SAndras01/Masters-thesis/FELV-cat.jpg

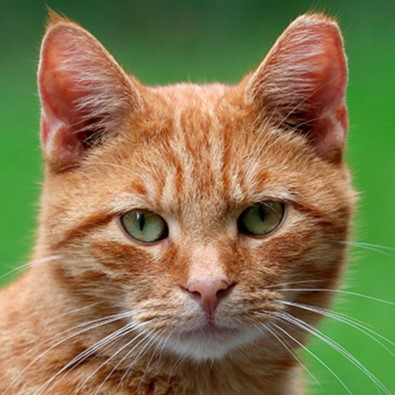
FELV-cat.jpg
