SAndras01/Masters-thesis/images/20251127_200717.jpg

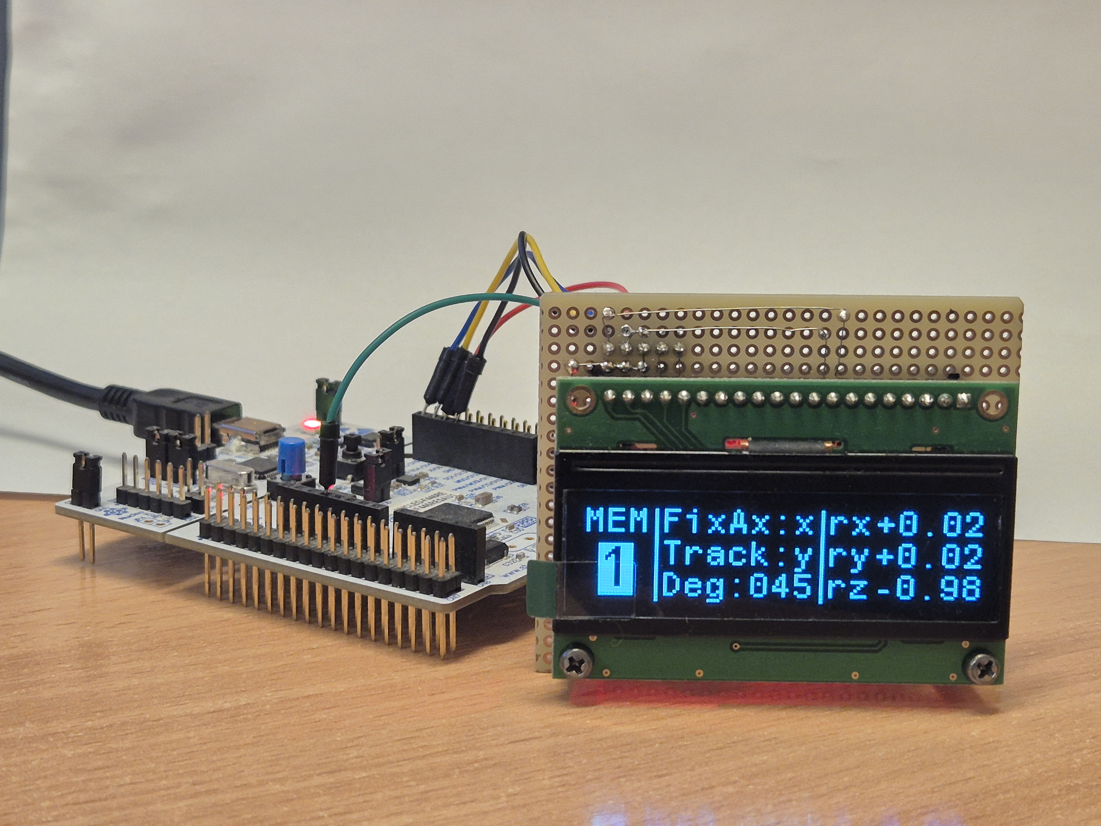
images/20251127_200717.jpg
