SAndras01/Masters-thesis/README.md

# Masters-thesis
Two-axes rotary table for characterization of accelerometers
