SAndras01/Masters-thesis/Dokumentáció/PowerPoint/rendszerdiagram.pptx

PC

SPI-simulyzer

Motorvezérlő1

Motorvezérlő2

Forgatómechanizmus

Kezelőfelület

Gomb panel

OLED

Numerikus billentyűzet

Ref. szenzor

Mérőasztal

Alaplap

enkóde r

STEPPER

MCU

STEPPER

enkóder

EEPROM

## Slide 2

Kiindulás és tervezés

Megoldandó probléma megállapítása

Teljesítendő követelmények meghatározása

Szakirodalmi áttekintés és elméleti alapok

Deszkamodell, megvalósítás

Rendszerarchitektúra és szükséges modulok meghatározása

Modulok fejlesztése

Szoftverintegráció és állapotgép

Nyomtatott áramkörök tervezése

Funkcionális prototípus

Rendszerszintű funkcionalitás elérése

Mechanikai kivitelezés és végső integráció
