SAndras01/Masters-thesis/Dokumentáció/PowerPoint/CharKnowDay.pptx

## K.I.T.T.E.N.

(Kinetic Test Environment)

## Feladat: Gyorsulásmérő szenzorok pozicionálása

Manuális pozicionálás

Időigényes (mérés leállítás, újra pozicionálás)
Jelenlétet igényel
Nem időzíthető
Pontos reprodukálás nehéz

Gépi pozicionálás

Forgatás a mérési kódba integrálható
Távolról vezérelhető
Pontos időzítés
Pontosan reprodukálható mérési szekvencia

## Követelmények

- Hozzáférés a mért szenzorhoz
- Vezérelhető számítógépről vagy kezelőpanelről
- Laborbiztonságnak megfelel

## Slide 4

Gombok

Encoder

Kijelző

Kezelőfelület

Numpad

Motorvezérlés

Mozgatás

Referenciaszenzor

MCU
modulok vezérlése
állapotgép

## Állapotgép

Mem btn

Select Memory

Beállítások betöltése, 9 memória hely van

MEM

Settings

FixAx
TrackedAx
Angle of tracked ax

REMOTE

Remote

Vezérlés PC-ről

OK

REMOTE

Moove

Beállítások által leírt pozíció felvétele

SET

Mozgás vége

Free moove

Free moove

Free moove

Szabad mozgatása a tengelyeknek

## Kezelőfelület

Kijelző

Numpad

Gombok

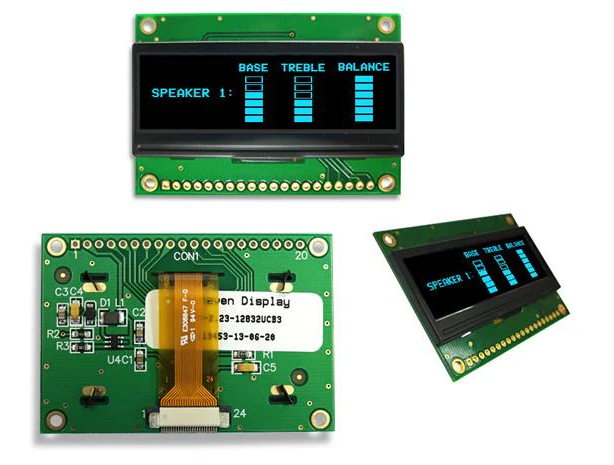
[picture p3: figure]

Analóg
Szűrt jel
Referencia visszamérve

HW debounce

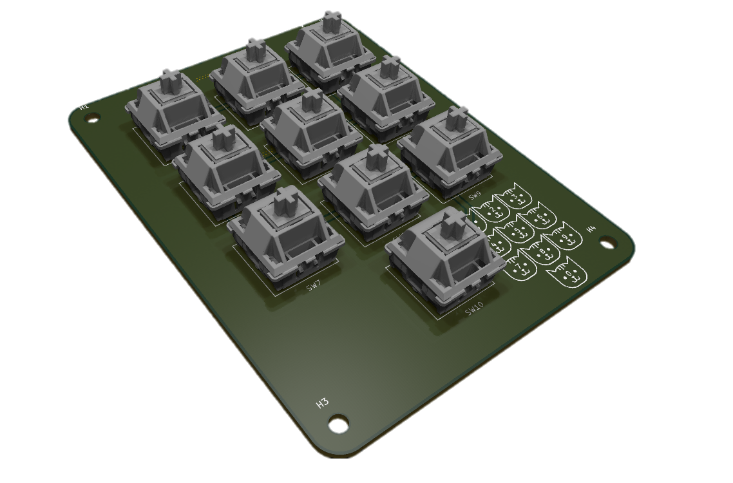
[picture p4: figure]
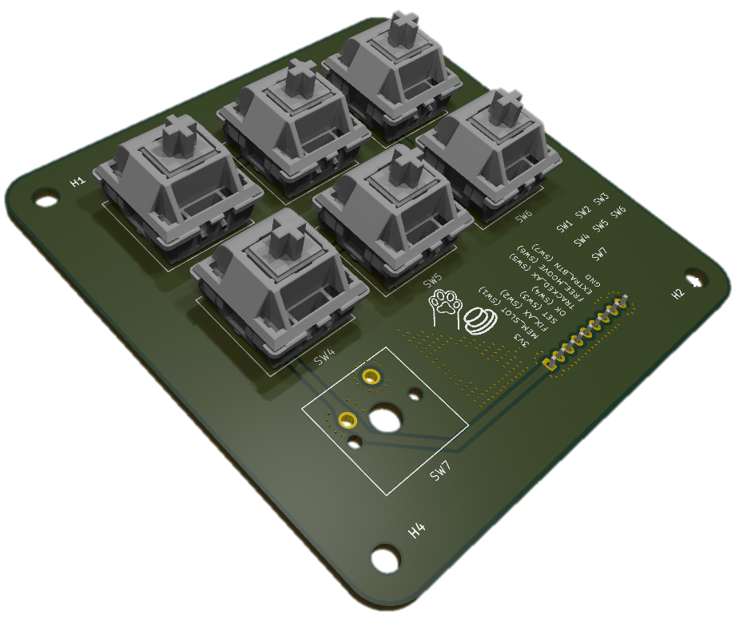
[picture p5: figure]
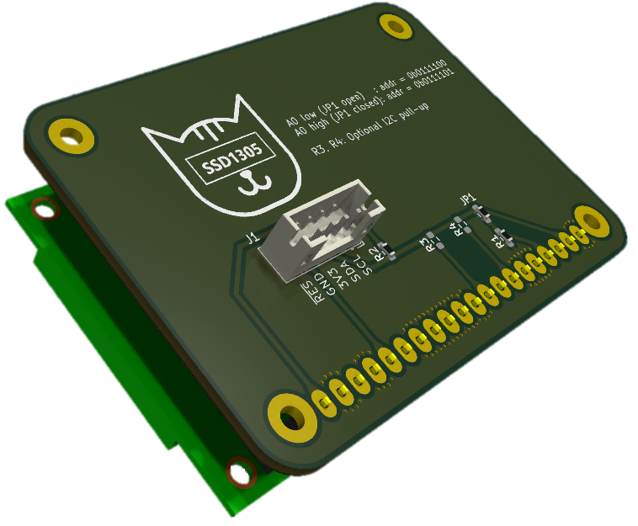
[picture p6: figure]

## Fő panel

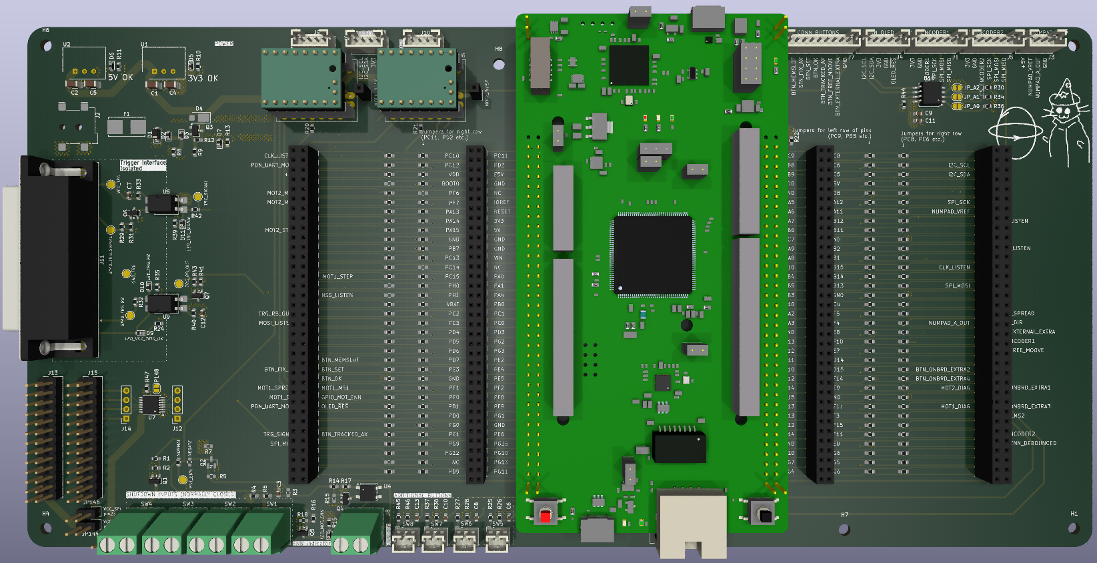
[picture p7: figure]

Notes: „Hackability”

Minden gpio kivezetve, sok tesztpont, invertálható leállítójel

## Mozgatás

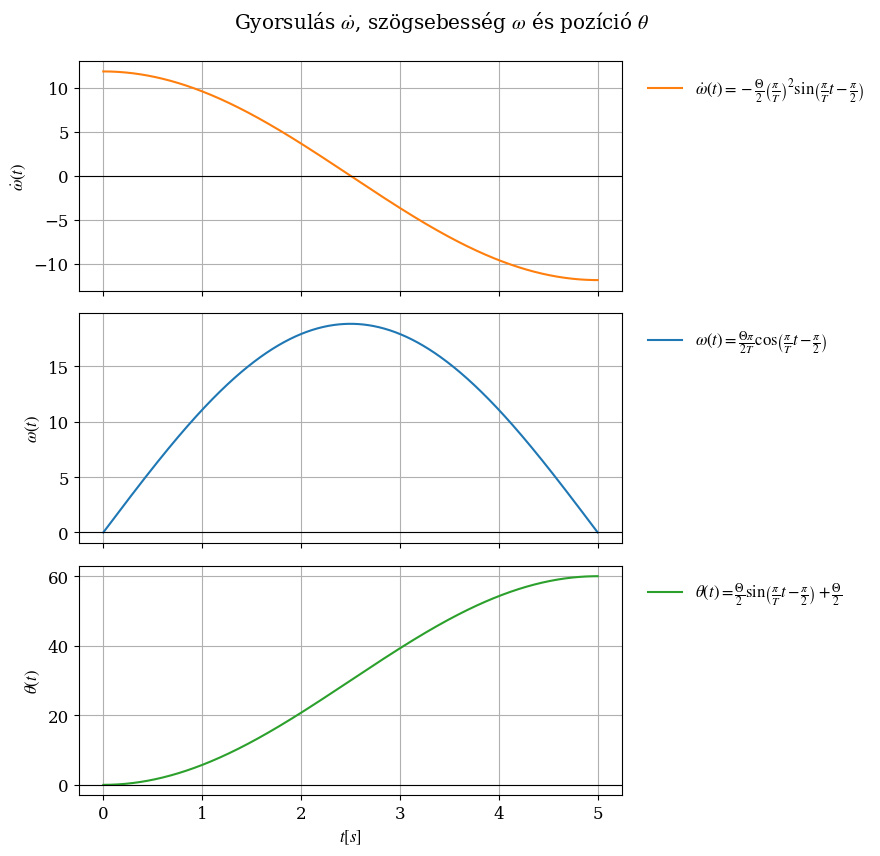
[picture p8: figure]
A képen szöveg, sor, Diagram, diagram látható Előfordulhat, hogy az AI által létrehozott tartalom helytelen.

CPU

Periféria
(timer)

DMA

Memória

BUSZ

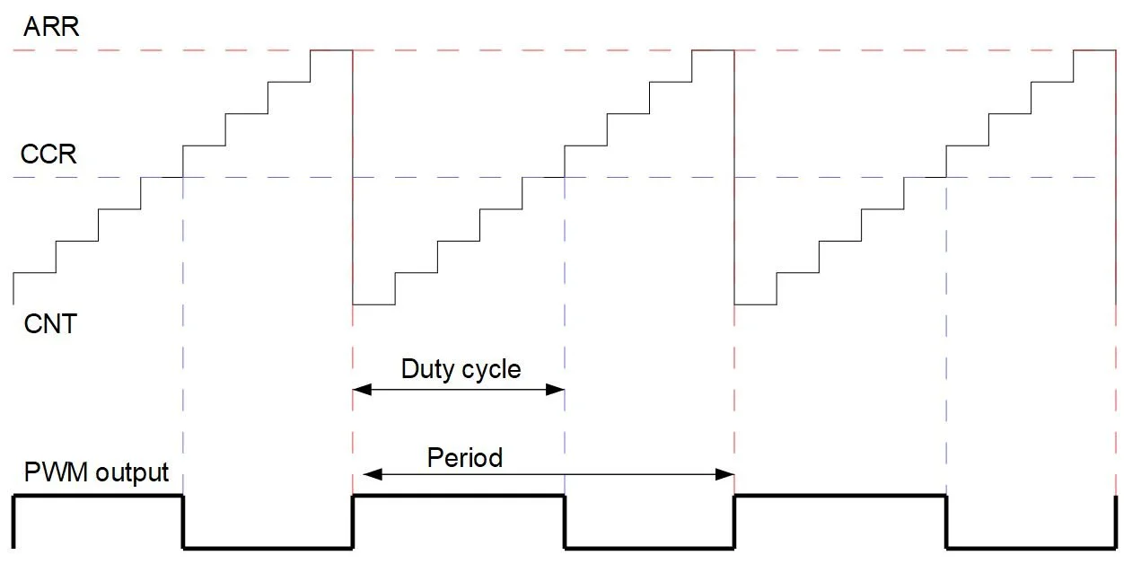
[picture p9: figure]

Notes: Nullomga nyomaték + 0 lengési lehetőség: léptetőmotr -> nyílt hatáslánc.
Ne legyen végtelen nyomaték és ezért rángatás/lépéstévesztés -> deriválható fgv: trigonometrikus. Jelenleg nincs implementáva, de könnyedén lehetne Nyomatékmax (= gyorsulásmax * tehetetlenség) alapján T és omega maxot számolni.

theta(t) inverz fgv-e a t(theta), ami t(k*alpha) -> k adik lépés t-je megkapható

Aszinkron, hogy a két motor egyszerre is mozgatható legyen-> PWM + DMA
CCR fix->kb a minimális step impulzus hossz, ARR értékeket számolunk, ezeket lapátolja a DMA a timerbe. Ha végez azt jelzi egy flag

## Slide 9
