SAndras01/Masters-thesis/Dokumentáció/töröltSlide-ok.pptx

## Projekt ütemterve

Kiindulás és tervezés

Megoldandó probléma megállapítása

Teljesítendő követelmények meghatározása

Szakirodalmi áttekintés és elméleti alapok

Deszkamodell, driverek

Rendszerarchitektúra és szükséges modulok meghatározása

Modulok fejlesztése

Szoftverintegráció és állapotgép

Nyomtatott áramkörök tervezése

Funkcionális prototípus

Rendszerszintű funkcionalitás elérése

Mechanikai kivitelezés és végső integráció

## Tengelyek elrendezése

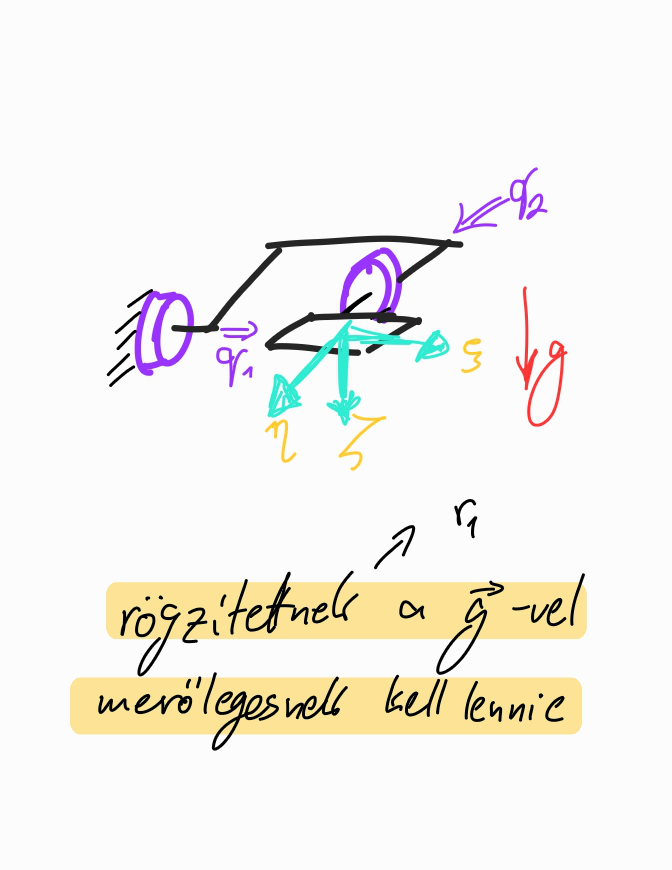
[picture p80: figure]
A képen szöveg, kézírás, rajz, tinta látható Előfordulhat, hogy a mesterséges intelligencia által létrehozott tartalom helytelen.
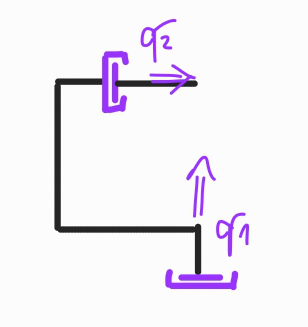
[picture p81: figure]
A képen szöveg, kézírás, rajz, tinta látható Előfordulhat, hogy a mesterséges intelligencia által létrehozott tartalom helytelen.
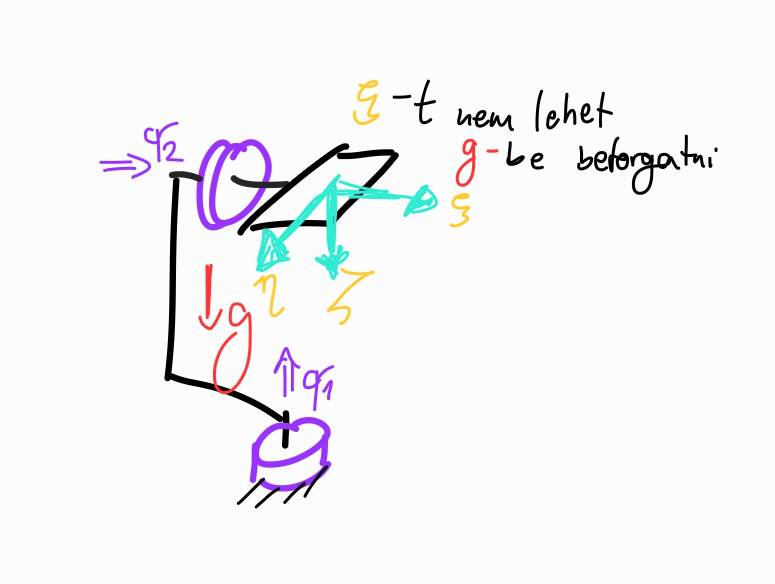
[picture p82: figure]
A képen szöveg, kézírás, rajz, tinta látható Előfordulhat, hogy a mesterséges intelligencia által létrehozott tartalom helytelen.

Notes: Akár 3tengelyes gyorsulásmérő szenzor bármely tengelye párhuzamos tudjon lenni a g-vel
Legalább két tengely körül forgatott forgóasztal
Nézzük hogyan oldható meg

## Slide 3

SW

HW

MCU

Állapotgép

PC vezérlés

Kialakított

OLED

Külön panelen

Numpad

Külön panelen

Gombok

Külön panelen

EEPROM

Külön panelen

Referenciaszenzor

Kapható hardwer

SPI sniffer

Alaplapon

Trigger interface

Alaplapon

Motorvezérlés

Kapható hardwer

Enkóderek

Motorra rögzíthető

## Slide 4

Állapotgép

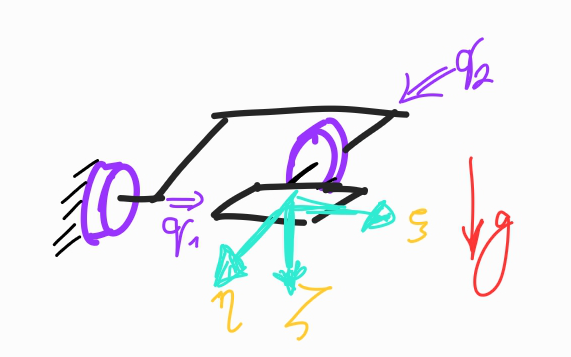
[picture p83: figure]
A képen szöveg, kézírás, rajz, tinta látható Előfordulhat, hogy a mesterséges intelligencia által létrehozott tartalom helytelen.

Memória választás

Beállítások betöltése, 9 memória hely van

MEM

Paraméterek beállítása

Fix tengely
Követett tengely
Szög

REMOTE

PC vezérlés

Vezérlés PC-ről

Szabad mozgatás

OK

REMOTE

Mozgás vége

Szabad mozgatás

SET

Beállás

Beállítások által leírt pozíció felvétele

Szabad mozgatás

Szabad mozgatása a tengelyeknek

## Slide 5
