SAndras01/Masters-thesis/Dokumentáció/DIP A/Diplomaterv.docx

FELADATKIÍRÁS

A feladatkiírást a tanszék saját előírása szerint vagy a tanszéki adminisztrációban lehet átvenni, és a tanszéki pecséttel ellátott, a tanszékvezető által aláírt lapot kell belefűzni a leadott munkába, vagy a tanszékvezető által elektronikusan jóváhagyott feladatkiírást kell a Diplomaterv Portálról letölteni és a leadott munkába belefűzni (ezen oldal HELYETT, ez az oldal csak útmutatás). Az elektronikusan feltöltött dolgozatban már nem kell megismételni a feladatkiírást.

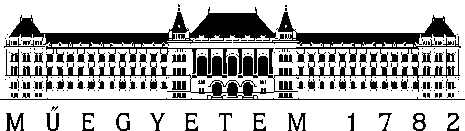
[picture p84: figure]

Budapesti Műszaki és Gazdaságtudományi Egyetem

Villamosmérnöki és Informatikai Kar

Automatizálási és Alkalmazott Informatikai Tanszék

Sásdi András

# Két tengelyű forgóasztal gyorsulásmérő szenzorok karakterizálásához

Konzulens

Dr. Stumpf Péter Pál

BUDAPEST, 2025

# Tartalomjegyzék

Hallgatói nyilatkozat

Alulírott Sásdi András, szigorló hallgató kijelentem, hogy ezt a diplomatervet meg nem engedett segítség nélkül, saját magam készítettem, csak a megadott forrásokat (szakirodalom, eszközök stb.) használtam fel. Minden olyan részt, melyet szó szerint, vagy azonos értelemben, de átfogalmazva más forrásból átvettem, egyértelműen, a forrás megadásával megjelöltem.

Hozzájárulok, hogy a jelen munkám alapadatait (szerző(k), cím, angol és magyar nyelvű tartalmi kivonat, készítés éve, konzulens(ek) neve) a BME VIK nyilvánosan hozzáférhető elektronikus formában, a munka teljes szövegét pedig az egyetem belső hálózatán keresztül (vagy hitelesített felhasználók számára) közzétegye. Kijelentem, hogy a benyújtott munka és annak elektronikus verziója megegyezik. Dékáni engedéllyel titkosított diplomatervek esetén a dolgozat szövege csak 3 év eltelte után válik hozzáférhetővé.

Kelt: Budapest, 2025. 11. 26.

...…………………………………………….

Sásdi András

# Összefoglaló

# Abstract

The goal of the thesis is to design and implement a controlled two-axis rotary table that is adequate for the characterisation of MEMS accelerometers. As discussed in chapter … due to their physical properties and working principles, MEMS sensors have an offset that some of these sensors can automatically cancel out (think of a digital kitchen scale that upon startup tares itself). Among others, the characterisation of the above-mentioned behaviour is one of the instances where it is necessary to change the orientation of the characterised sensor during a measurement. The current protocol is manual rotation of the sensor, which requires the presence of the engineer performing the measurement. This current method has many downsides, such as the time it takes to manually rotate the sensor, the impossibility of doing these measurements remotely or the poor reproducibility of the exact timing and speed of such rotations. The device created in this thesis aims to solve these issues thereby easing the workload of the characterisation engineers and shortening the runtime of these measurements

# 1 Bevezetés

## 1.1 A munka indoka és célja

A feladat MEMS gyorsulásszenzor karakterizálásához felhasználható vezérelhető kéttengelyes forgóasztal tervezése és megvalósítása. A MEMS szenzorok ahogy azt a … fejezetben is említem működésükből és fizikai kialakításukból adódóan ofszettel rendelkeznek, melyet ezen eszközök egyes típusai automatikusan lenulláznak (akárcsak egyes digitális konyhai mérlegek melyek bekapcsolás után tárázzák önmagukat). A szenzorok karakterizálása során többek közt ezen viselkedések kiméréséhez szükséges a szenzor orientációjának változtatása. Jelen eljárás szerint ilyen mérések során a mérést végző mérnök jelenléte szükséges, hogy a mért szenzort manuálisan a megfelelő orientációba forgassa. A jelenlegi eljárás nem csak meglassítja a mérési folyamatot, de ellehetetleníti a mérés távolról végzését, valamint az ismételhetőséget is korlátozza. A diplomaterv kereteiben létrehozott eszköz célja ezen problémák megoldása, ezáltal a karakterizálómérnök munkája könnyítése és a mérési idők csökkentése.

## 1.2 Specifikáció

## 1.3 Feladatok áttekintése

Minden feladat első lépése annak alfeladatokra bontása. A diplomamunka első féléve során a lehetséges mechanikai megvalósításokat és a biztonságtechnikai elvárásokat tártam fel. Ezután körvonalazódott, hogy milyen modulok szükségesek az eszköz megvalósításához. A modulok megvalósítása és funkcionális tesztje deszkamodell formájában valósult meg. Miután a modulok külön-külön működtek, beillesztettem ezeket az eszköz funkcionális törzsét adó állapotgépbe, itt a modulok együttműködését is ellenőrizhettem. A következő lépés a deszkamodell alapján megtervezni a kapcsolásokat és ezek alapján megalkotni a nyomtatott áramkörök tervét. Az utolsó lépésre, mely az eszköz mechanikájának megvalósítása, már nem volt időm.

## 1.4 Projekt arculata

Annak érdekében, hogy az eszközről könnyen és egyértelműen lehessen beszélni el kellett neveznem. Célom volt olyan nevet vagy betűszót találni, ami egyértelmű viszont könnyedebb hangulatú. Ezeknek megfelelően a projekt neve Kinematic Test Environment lett, aminek a rövidítése K.I.T.T.E.N., ami angolul „kiscica”. Ennek megfelelően macskás grafikákat használtam az áramkörökön. Az ilyen és ehhez hasonló elnevezéseknek és praktikáknak köszönhetően emberközelibb munkaközeg hozható létre.

## 1.5 Szakirodalmi áttekintés, elméleti összefoglaló és tervezési irányelvek

### 1.5.1 MEMS szenzorok [1] [2] [3]

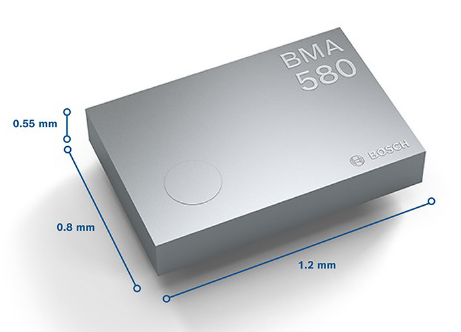
[picture p85: figure]
A képen elektronika, tervezés látható Előfordulhat, hogy a mesterséges intelligencia által létrehozott tartalom helytelen.

Error! Use the Home tab to apply 0 to the text that you want to appear here.-1. ábra BMA508 [4]

A MEMS szenzorok a mérendő fizikai mennyiségeket valamilyen mikromechanika segítségével alakítják mérendő elektromos jellé. Ezt a jelet továbbítás előtt erősíti, esetleg digitalizálja a szenzor jeltovábbítás előtt. Az érzékel fizikai mennyiség többek közt lehet akár nyomás, gyorsulás, hőmérséklet, akár egy bizonyos gáz jelenléte. Elterjedésük okai közt áll kis méretük (mint a képen látható Bosch BMA 580 gyorsulásmérő), alacsony energiafogyasztásuk és magas pontosságuk. A MEMS gyorsulásérzékelők népszerűsége vetekszik az egykor domináns piezoelektromos gyorsulásérzékelőkkel. Felhasználási területük közt szerepelnek az okos eszközök és a gépjárművek is, megbízhatóságukat alátámasztja, hogy ez utóbbiban biztonsági rendszerek részeiként is felhasználásra kerülnek.

A MEMS gyorsulásérzékelő szenzorok felépítésükből és működési elvükből adódóan belső mechanikai feszültség következtében (mely akár hőmérsékletváltozás, illetve beforrasztáskor is kialakulhat) DC ofszettel terhelt gyorsulás jelet adnak. Ezt nevezik 0g ofszetnek, melynek kikompenzálása a magasabb minőségű szenzorok esetén már a szenzor belső jelfeldolgozásánál megtörténik, így a kiküldött digitális jel ezt már nem tartalmazza. Ez a folyamat az offset cancellation (ofszet törlés), mely nem csak a szenzor bekapcsolásakor, de az esetleges hőmérsékletváltozások miatt a szenzor működése közben is üzemel.

### 1.5.2 Biztonságtechnikai lépések [5] [6]

A mérőberendezés használatánál jelen van a személyi sérülés kockázata, melyet megszűntetni vagy csökkenteni kell. A személyi sérülés forrása a forgó elemek melyek lehetséges következménye az ütés, nyírás [5] (3.2 táblázat).

Ezeknek a kockázatoknak a leg egyszerűbb minimalizálása egy védőburkolat beépítése. A védőburkolatot tervezésekor a veendő szempontokat a következőkben részletezem. Feladata a veszélyforrás emberrel való érintkezését megakadályozni. Általános szabályai, hogy legyen szilárd, ne idézzen elő további veszélyeket, ne legyen egyszerűen megkerülhető vagy hatástalanítható, tartson a veszélyes tértől kellő távolságot, a munkafolyamat megfigyelését csak a lehető legszükségesebb módon korlátozza [6]. Továbbá fontos elvárás, hogy a védőburkolat ne lassítsa feleslegesen a munkát, ezáltal ne ösztönözze a felhasználót annak kiiktatására. Emiatt fontos, hogy csak annyit burkoljon, amely a munkavégzés biztonsága szempontjából feltétlenül szükséges.

A megfigyelhetőséget figyelembe véve egy víztiszta polikarbonátból kialakított védőburkolat kerül megtervezésre. A munkavégzés minimális gátlása érdekében védőburkolat csak a forgó részeket takarhatja, nem akadályozhatja a kezelőfelületek és csatlakozók hozzáférhetőségét, valamint szerszám nélkül legyen nyitható.

A veszélyes gépi funkciók csak lezárt védőburkolat esetén működhetnek. Amennyiben működés közben kinyílik a védőburkolat, a veszélyes folyamatnak le kell állnia, a burkolat visszacsukása esetén nem folytatódhatnak automatikusan, azaz egy reteszelő berendezéssel lesz ellátva a védőburkolat.

További védőberendezésnek kell biztosítania az eszköz felborulása esetén a motorok leállását. Ennek kialakításakor a működési elv is kettőzve lesz, hiszen a felborulás érzékelésére alkalmas lesz a mérőasztalon található referencia gyorsulásérzékelő is. Ezen felül beépítésre kell kerülnie egy vészleállító gombnak is.

A biztonsági berendezések vizsgálhatóságát is figyelembe kell venni a tervezéskor. A berendezés által kiadott jelet, valamint a megszakítók állapotát is vizuális visszajelzéssel kell ellátni, például egy piros és egy zöld LED-del.

### 1.5.3 kéttengelyű forgatómechanizmusok

A kéttengelyű forgatómechanizmus alapvetően két egymásra merőleges forgatási tengelyből áll. Amennyiben a két tengely egymással párhuzamos lenne a gimbal lock jelenség lépne fel, ezért a forgatás csak a közös tengely mentén lehetne lehetséges.

A mechanizmusnak a háromtengelyű gyorsulásmérő szenzor bármely tengelyét a gravitációs térrel párhuzamossá kell tudnia tenni. Ezt minél jobb ismételhetőséggel, mechanikai stabilitással kell tudnia végrehajtani, a motorok tengelyének terhelését csapágyazás felhasználásával minimalizálni kell. A mechanizmusnak lehetőleg egyszerűnek kell lennie, a meghibásodási lehetőségeket lehetőleg minimalizálni kell.

Az első elvárás teljesítésének szükséges feltétele, hogy nem lehet olyan tengely, ami a gravitációs térrel állandóan párhuzamos, onnan ki nem fordítható. Tehát rögzített tengelynek ( q_1 ) a gravitációs térre merőlegesnek kell lennie.

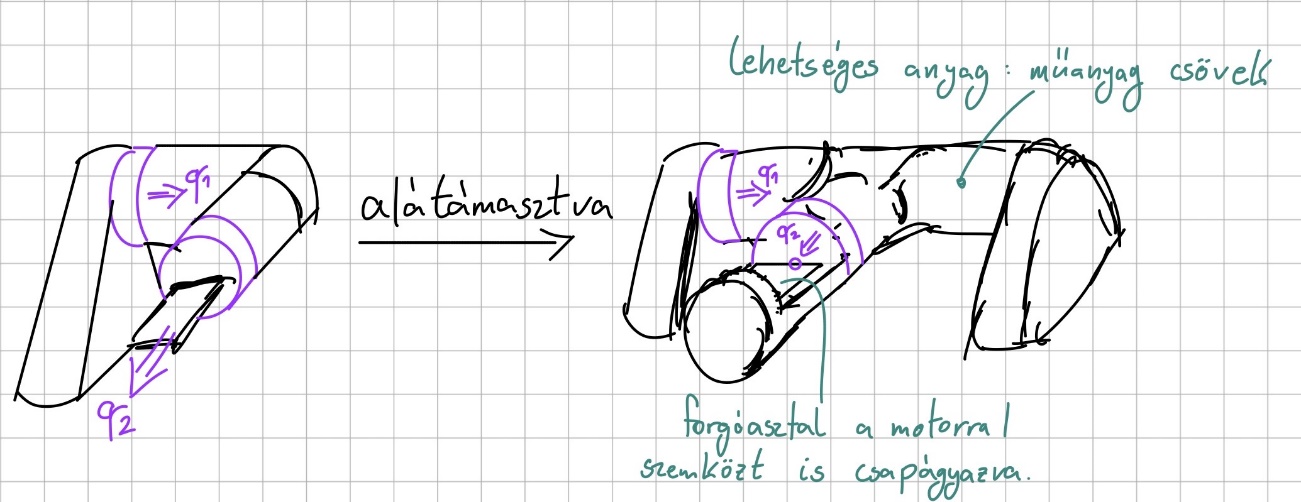
[picture p86: figure]
A képen szöveg, kézírás, sor, Diagram látható Előfordulhat, hogy a mesterséges intelligencia által létrehozott tartalom helytelen.

Error! Use the Home tab to apply 0 to the text that you want to appear here.-2. ábra Kézi vázlatok az első megoldásra

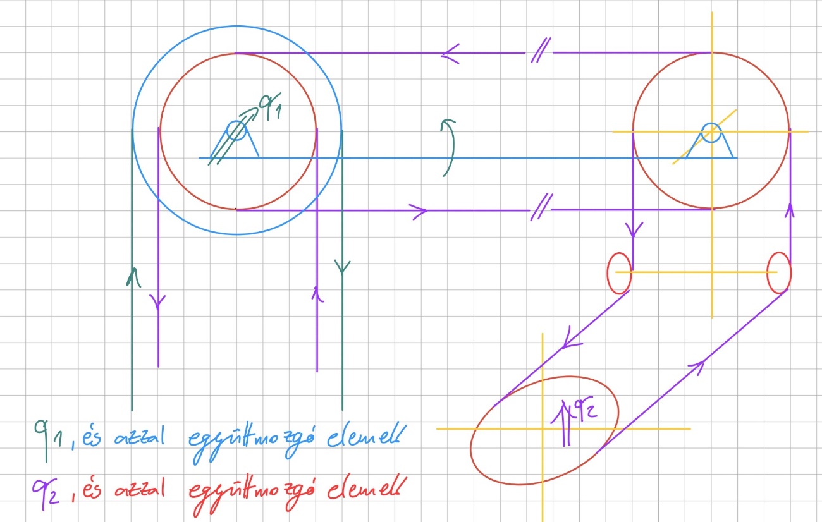
[picture p87: figure]
A képen szöveg, kézírás, sor, diagram látható Előfordulhat, hogy a mesterséges intelligencia által létrehozott tartalom helytelen.

Error! Use the Home tab to apply 0 to the text that you want to appear here.-3. ábra Kézi vázlat a második megoldásra

Alapvetően két megközelítés lehetséges, a mechanikailag leg egyszerűbb megoldás esetén egy rögzített és egy forgatott aktuátor felelős a tengelyek forgatásáért (1. ábra). Ebben az első esetben az egyik kihívás a forgatott motor jeleinek és tápvezetékeinek átvitele forgócsatlakozókon a mérőasztalra menő jeleken túl. A másik kihívás abból ered, hogy a forgatott asztalon kívül egy aktuátor tömegét és ebből adódó tehetetlenségét is gyorsítania kell az első motornak. A második kivitelezés esetén a motorok rögzítettek, így nem szükséges a második motornak sem mozgatása, sem annak jeleinek és tápvezetékeinek átvitele. Ebben az esetben viszont bonyolult fogaskerekes vagy (mint a vázlaton is látható) hajtószíjas mechanizmus szükséges (3. ábra).

# 2 Modulok

Az eszköz megvalósításához szükséges egységek fejlesztését úgynevezett deszkamodellen végeztem, ami a gyors prototípusgyártás egyik elterjedt módja. Az elektronikai alkatrészek próbapanelen vannak, nincs nyomtatott áramkör, próbanyákon vannak a csatlakozók kialakítva.

## 2.1 Motorok

Abból, hogy a mérőseszköz gyorsulásmérő szenzorokat pozícionál következik az elvárás, hogy a mérőeszköz miután felvette a kívánt pozíciót azt tartsa. Tehát nulla szögsebességnél is legyen nyomatéka, valamint oszcilláció lehetősége ne állhason fenn. Ezen elvárások alapján léptetőmotorokat választottam aktuátoroknak. A léptetőmotor tekercseinek gerjesztésével a forgórész léptethető, vagy az adott pozícióban tarható. A tekercsek gerjesztését TMC2209 IC-t használó SilentStepStick meghajtóval végeztem. A meghajtónak forgási irányt, mikrostep felbontást és lépés impulzust adva lépteti a motort lépés impulzusonként. Mivel a lépés impulzusok hatására a motor adott szöggel fordul el, a motorok nyílt hatásláncú pozíció irányítását választottam (ez elterjedt megoldás léptetőmotorok esetén). A mozgás végén felvett pozíciót mágneses abszolút enkóderekkel mérem vissza.

### 2.1.1 Motorvezérlő IC [7]

A léptetőmotorok vezérléséhez, mint azt feljebb is említettem, a TMC2209 IC-t használtam. Az IC a szükséges passzív áramköri elemekkel ellátva is kapható, beépítve a SilentStepStick elnevezésű panelen. Ez egy elterjedt léptetőmotor meghajtó IC, amit gyakran alkalmaznak például 3D nyomtatók motorjainak vezérlésére is. Választásom azért erre esett, mivel elterjedtsége miatt könnyen beszerezhető, sok információ található róla, valamint csöndesebb és energiahatékonyabb léptetést ígér. A meghajtó IC képes UART-csatornán kommunikálni, akár ezen keresztül is megadható a léptetés sebessége, de ezt a képességét nem használom ki, mivel ez nem képes gyorsító és lassító profilokra. Emiatt a későbbiekben tárgyalt sebességprofilvezérlést alkalmaztam. Az IC-nek további nagyon hasznos funkciója, hogy képes nyomaték ugrást detektálni, ezáltal végálláskapcsoló nélkül is lehet alaphelyzetet találni a motorokkal, valamint képes kihagyott lépések detektálására. A lehető leg optimálisabb motorvezérlés érdekében a meghajtó kalibrálható. Ezeket a funkcionalitásait egyelőre még nem használtam ki, de az alaplap tervezésekor úgy hoztam létre a kapcsolást, hogy az UART csatorna használható legyen.

Ez a motorvezérlő kétfázisú bipoláris léptetőmotorok vezérlésére alkalmas 2.8A maximális árammal. A pontos motorválasztásra akkor kerülhet sor, amikor a mechanikai terv már elkészült. Mivel a motor mérete nem befolyásolja az alapvető működési és vezérlési elvet, ezért ez nem jelent akadályt a fejlesztés során.

A motorvezérlő legfinomabb mikrolépés beállítása 1/32. Ez 1.8° felbontású léptetőmotorok esetén α_(min) =0,05625° -os felbontást jelent.

### 2.1.2 Léptetőmotorok sebességprofil vezérlése [7]

Feltételezve, hogy nem történik lépéstévesztés, a léptetőmotorok által a mozgás végén felvett szöghelyzetet a léptető impulzusok száma határozza meg (1.1) egyenlet, míg a mozgás közbeni szögsebességet az impulzusok közötti idő határozza meg (1.2) egyenlet.

| Θ=α⋅n | (1.1)
| ω=α/τ | (1.2)

Az egyenletekben a α az egy lépésimpulzus hatására tett elfordulást, n az impulzusok számát, Θ a mozgás során tett teljes elfordulást, τ az impulzusok között eltelt időt, ω pedig a szögsebességet jelöli.

Belátható viszont, hogy nem vezérelhető a motor oly módon, hogy álló helyzetében azonnal egy kívánt szögsebességhez tartozó τ időintervallumonként lépés impulzust adunk a vezérlőnek. A sebességprofil, amit így előírnánk a motornak nem lenne teljesíthető, hiszen az ugrásszerű szögsebességváltozáshoz elméletileg végtelenül nagy szöggyorsulás, ezáltal nyomaték tartozna, amit természetesen nem tud a motor szolgáltatni. Ez nem csak magas áramfelvételhez, hanem esetleges lépésvesztéshez is vezethet, valamint az éles gyorsulásból adódóan a motor „rángatna”. Ezen nem kívánatos hatások elkerülése érdekében a léptetőmotorokat megfelelő sebességprofillal kell vezérelni.

Gyakran használt megoldás a sebességprofilt lineáris szakaszokból összeilleszteni, ahogy azt a 4. ábra is mutatja.

A képen diagram, vázlat, sor, rajz látható Előfordulhat, hogy az AI által létrehozott tartalom helytelen.

Error! Use the Home tab to apply 0 to the text that you want to appear here.-4. ábra Gyorsulás ( ω ), sebesség ( ω ), pozíció ( θ ) [7]

Meg kell jegyezni, hogy ez a sebességprofil sem deriválható folyamatosan, ugrások vannak a gyorsulásban, így a gyorsító nyomatékban is ugrások vannak. Ennek kiküszöbölése érdekében akárhányszor deriválható sebességprofilt választottam. Kézenfekvő megoldás volt a trigonometrikus függvényekhez nyúlni.

Ezen kívül a forrásban leírt megoldásban a következő lépésig eltelt időt a motor forgása közben lépésről-lépésre számították. Annak érdekében, hogy a motorok forgatása akár párhuzamosan is történhessen, célom volt, hogy forgás közben ne használjak számítási kapacitást.

### 2.1.3 Trigonometrikus sebességprofil

A választott pozícióbeállási görbét az (1.3) függvéy adja meg, ahol Θ a végpozíció, T pedig a mozgás ideje. A kívánt mozgási profilokat az 5. ábra mutatja.

| θ(t)=Θ/2⋅sin(π/2⋅t -π/2)+Θ/2 | (1.3)

Ennek deriváltja pedig az (1.4) függvény:

| ω(t)=(π⋅Θ)/(2T)⋅cos(π/T⋅t-π/2) | (1.4)

A képen szöveg, sor, Diagram, diagram látható Előfordulhat, hogy az AI által létrehozott tartalom helytelen.

Error! Use the Home tab to apply 0 to the text that you want to appear here.-5. ábra Trigonometrikus mozgásprofil, T = 5, Θ=60°

Mivel a motor forgási sebessége a lépésimpulzusok között eltelt időtől függ, a cél a lépések közötti t_k idők meghatározása.

Első megközelítésben először számoltam a sebességprofilt, majd ezt kiértékeltem Θ/α=N db helyen, majd az így kapott ω_i sebességekhez tartozó t_i időzítéseket a t_i =(ω_i)/α összefüggéssel számoltam. Ennek a megoldásnak a problémája, hogy ω(t=0) helyen 0 értéket vesz fel, ott kiértékelve ω_i =0 -t kapunk, amiből t_i = ∞ adódik és a motor sosem fog elindulni. Erre megoldást adhat az ω(t) függvény ω_(min) minimális szögsebességgel való eltolása, így viszont a θ(t) függvényt is korrigálni kell az ebből adódó hibával.

A megoldás a θ(t) függvény inverzének, a t(θ) függvénynek használata.

| θ(t)= Θ/2⋅sin(π/2⋅t-π/2)+Θ/2 | (1.5)

Kifejezve a t(θ) függvényt:

| t(θ)=(arcsin((θ-Θ/2)⋅Θ/2)+π/2)⋅T/π | (1.6)

Áttérve diszkrét időre a θ_k =k⋅α helyettesítéssel:

| t_k =(arcsin((k⋅α-Θ/2)⋅Θ/2)+π/2)⋅T/π, {k|1≤k≤Θ/α, k∈Z} | (1.7)

Az így kapott összefüggéssel egyből a k. lépésben alkalmazandó t_k időzítést kapom, amivel a kívánt sebességprofil érhető el.

Amennyiben nem a megtételhez szükséges idő, hanem a maximális elért szögsebességet szeretnénk paraméterként felhasználni, először meg kell találni az összefüggést T és ω_(max) között. A szögsebesség maximuma könnyen belátható, hogy
t=T/2 pontban található. Az (1.4) függvénybe behelyettesítve ebben a pontban:

| ω(t=T/2)=(π⋅Θ)/(2T)⋅cos(π/T⋅T/2-π/2) | (1.8)

majd kiértékelve, az (1.9) összefüggést kapjuk. Ebből akár visszaszámolható a szükséges T a kívánt ω_(max) alapján.

| ω_(max) =(π⋅Θ)/(2T) | (1.9)

### 2.1.4 Numerikus módszerek

A következő felmerülő probléma, hogy az arcsin függvény számítása. Erre több megoldás is lehetséges: Taylor sor használata, aszimptotikus közelítés ±1 -körül [8] vagy keresőtábla lineáris interpolációval. A numerikus módszereket először python környezetben valósítottam meg, majd összehasonlítottam az eredményeket és ez alapján döntöttem, hogy melyiket implementáljam az eszközön.

Az összehasonlításnál negyedfokú Taylor sort használtam. Ezzel a -arcsin függvény közelítését a 6. ábra mutatja. Mint látható, nullától távolodva egyre jobban torzul a függvény közelítése.

A képen sor, Diagram, diagram, szöveg látható Előfordulhat, hogy az AI által létrehozott tartalom helytelen.

Error! Use the Home tab to apply 0 to the text that you want to appear here.-6. ábra -arcsin közelítése negyedfokú Taylor sorral

A következő vizsgált megoldás az aszimptotikus közelítés, mellyel a Taylor sor 1 és -1 körüli torzítását kívántam ellensúlyozni azzal, hogy az aszimptotikus közelítést -1 (és a szimmetria által ezáltal 1) köré választottam. Az így kapott -arcsink közelítést a 7. ábra mutatja. Látható, hogy itt törés van nullánál. Magasabb fokú kifejtésnél ez az effektus csökken, de a nem folytonosságból adódó hiba sosem tűnik el.

A képen sor, Diagram, szöveg, diagram látható Előfordulhat, hogy az AI által létrehozott tartalom helytelen.

Error! Use the Home tab to apply 0 to the text that you want to appear here.-7. ábra Aszimptotikus közelítés

A harmadik módszer keresőtáblát használni, azaz adott pontokban előre meghatározni a függvény értékét, és ezen pontok között becsülni a függvény értékét. Az összehasonlítás során 100 elemű táblát használtam. A tábla csak a negatív x értékekhez tartozó y értékeket tartalmazza, hiszen a függvény szimmetrikus, ezért valójában 200 elemes tábla felbontását adja. Az így kapott -arcsin közelítést a 8. ábra mutatja.

A képen sor, Diagram, diagram, szám látható Előfordulhat, hogy az AI által létrehozott tartalom helytelen.

Error! Use the Home tab to apply 0 to the text that you want to appear here.-8. ábra -arcsin közelítése keresőtáblával

A módszereknek az adott feladatra való alkalmasságát úgy ellenőriztem, hogy a különböző módszerekkel kiszámítottam egy adott mozgásprofilhoz tartozó t_k értékeket, illetve ez alapján számítottam ebből adódó szögsebességet és szögelfordulást is. Annak érdekében, hogy legyen összehasonlítási alap, a Numpy csomag beépített arcsin függvényével is kiszámoltam egy „pontos” sorozatot. Az eredményeket a 9. ábra foglalja össze.

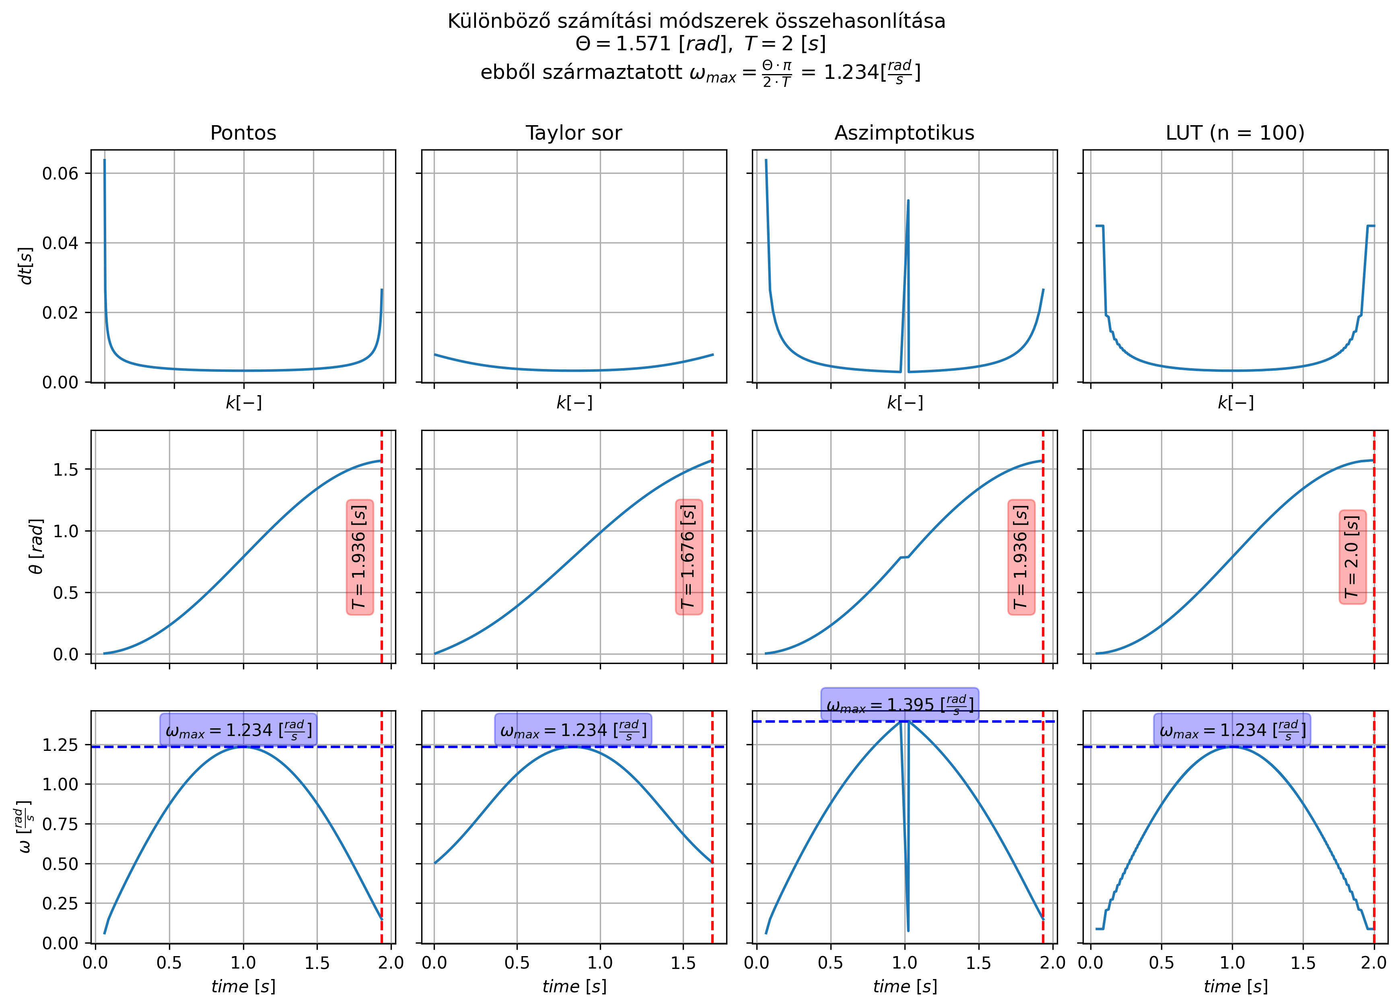
[picture p88: figure]
A képen szöveg, diagram, sor, Diagram látható Előfordulhat, hogy az AI által létrehozott tartalom helytelen.

Error! Use the Home tab to apply 0 to the text that you want to appear here.-9. ábra közelítési módszerek

A megadott T beállási időt a Taylor soros megoldás közelítette a leg rosszabbul, illetve a Taylor soros számítás esetén a kapott szögsebesség profil is sokkal nagyobb kezdeti ugrással indul, mint a többi módszer. Az aszimptotikus közelítés esetén a nulla körüli törés által okozott torzításon kívül a sebességprofil formája messze van a kívánt profiltól, ezért a nulla körüli kiugrás numerikus kiszűrésével nem foglalkoztam. A 100 elemes keresőtáblás megoldás a tesztelt módszerek közül a legjobban követte a pontos számítás eredményeit. Nem tekinthetünk el attól a sem, hogy a keresőtáblás megközelítés jóval kisebb számítási igényt igényel, viszont a keresőtábla keresése időigényes, valamint a többi megközelítéssel szemben a keresőtábla letárolása miatt memória igényesebb ez a módszer. Ezek a hátrányok elfogadhatóak, hiszen a választott mikrovezérlő tárhelye bőven elegendő a 100db, akár 32bites érték letárolásához, valamint az aszinkron kivitelezés miatt (először t_k táblázat számítása majd parancsra a mozgatás megkezdése) nem probléma, ha a mozgásprofil számítása időigényesebb.

### 2.1.5 Módszer implementálása beágyazott eszközre

Mivel kis számokkal kellene számolni, könnyen bekövetkezhetne, hogy számolás közben nullává változik egy eredmény a számábrázolás miatt. Azért, hogy ezt elkerüljem, felskálázott keresőtáblát használok és az értékeit 32 biten tárolom. A számítások leírásánál többek között az osztások és szorzások sorrendjére is külön figyelnem kellett.

### 2.1.6 Enkóderek [10]

Mivel a motorokat nyílt hatáslánccal irányítom (tehát nincs visszacsatolás) elengedhetetlen, hogy a mozgás végén visszamérjem a motorok pontos pozícióját. A pozíció visszamérése azért is elengedhetetlen, mert a következő pozícióba való beálláshoz szükséges a jelenlegi pozíció ismerete. A pozícióméréssel szemben támaszott elvárásom, hogy bekapcsoláskor is abszolút szöghelyzetet szolgáltasson, szögfelbontása legalább annyira legyen finom, mint a legkisebb használt motorlépés, könnyű legyen beszerelni és könnyen beszerezhető legyen.

Ezen megfontolások alapján mágneses alapú enkódert választottam. Ezek az eszközök a hall effektuson alapulnak, a tengelyre rögzített mágnes terének abszolút helyzetét képesek megállapítani. A pontos választott szenzortípus az AMS által gyártott „AS5147U” 14 bites mágneses elfordulásmérő szenzor. 14 biten az elméleti felbontása az eszköznek 360/(2^14 -1)≅0.022[(deg)/(LSB)] , ami kisebb, mint az elérhető α_(min) . A szenzor beszerezhető beépítve az AMS által gyártott „AS5x47U Motor Board” panelbe. Ez a kész eszköz különböző tengelyátmérőkre rögzíthető, megfelelően polarizált mágnesekkel érkezik, valamint különböző méretű motorokkal kompatibilis rögzítőfuratokkal el van látva.

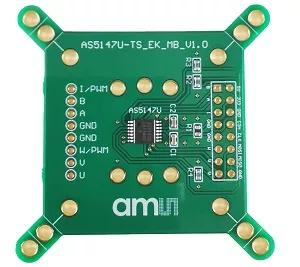
[picture p89: figure]
A képen szöveg, Elektronikus alkatrész, Elektrontechnika, Passzív áramköri elem látható Előfordulhat, hogy az AI által létrehozott tartalom helytelen.

Error! Use the Home tab to apply 0 to the text that you want to appear here.-10. ábra AS5x47U Motor Board [11]

A választott szenzor képes az optikai enkódereknél megszokott impulzus jelek kiadására, de SPI kommunikáción keresztül kiolvasható belőle a mágneses tér pozíciója, így a tengely abszolút szögpozíciója bármikor kiolvasható a szenzorból. További előnye, hogy diagnosztikai adatok is kiolvashatóak, így a megfelelő beépítés ellenőrizhető.

Mivel nem találtam szabadon felhasználható drivert erre az enkóderre, ezért azt nekem kellett megvalósítani az adatlapja alapján.

## 2.2 Kezelőfelület

Mivel cél, hogy az eszköz számítógép nélkül is intuitívan használható legyen meg kellett terveznem a kezelőfelületét. Célom az volt, hogy a laboratóriumi tápegységek kezelőfelületével hasonlóan egyszerű és egyértelmű interfészt alkossak. Itt is (akárcsak a labortápoknál is) a felhasználó kiválaszt 2 paramétert, majd a gép gombnyomásra végrehajtja a paraméterek szerinti állapot felvételét.

Az eszköz feladata az, hogy a 3 tengelyű gyorsulásmérő szenzor bármely adott tengelyét képes legyen a gravitációs tengelyhez képest adott szögbe állítani. Ennek egy nagyon intuitív megoldása, ha a kezelő kiválaszthat egy fix, gravitációs térre merőleges tengelyt, ami körül forgatni fog a gép. Ez után kiválasztható a maradék két tengely közül, hogy melyiknek a szögét szeretnénk megadni, majd megadható a kívánt szög. Ezzel a módszerrel egyértelműen tudni fogja az eszköz, hogy melyik forgató tengelyt hova forgassa és nem lesz olyan konfiguráció, ahonnan a beállás nem egyértelmű. Ezen kívül a kezelőnek is egy intuitív eszközt ad a kívánt szög megadására.

A használatot nagyban egyszerűsíti, ha a felhasználó elmenthet néhány állapotot. Ennek érdekében az eszközt kiegészítettem egy EEPROM IC-vel. A felhasználó amikor beállít egy adott pozíciót, az az éppen kiválasztott „memória helyre” kerül mentésre. A memória választó gombbal a felhasználó beléphet a memóriaválasztás állapotba, ahol számlapon megadhatja a 9 közül melyik memóriát szeretné betölteni és akár módosítani.

### 2.2.1 Állapotgép

Legyenek képek, hogy az egyes állapotban miket mutat az OLED

Az eszköz vezérlését egy egyszerű állapotgéppel valósítottam meg. A felhasználó a gép bekapcsolásakor a „Paraméterek beállítása” állapotba lép. Ebben az állapoton belül egy belső állapotgép fut. A felhasználó kiválaszthatja a

A képen szöveg, képernyőkép, diagram, Betűtípus látható Előfordulhat, hogy az AI által létrehozott tartalom helytelen.

### 2.2.2 Számítógépes vezérlés [12]

A számítógépes vezérléshez a nyílt forráskódú „Shellminator” programot használtam. Ez a program lényegében egy terminál, mely mikrovezérlők távoli elérésére lett fejlesztve. Futtatása nem igényel beágyazott operációs rendszert. Mivel a kommunikáció egyszerű soros kommunikáció formájában zajlik, a számítógépre sem szükséges semmilyen specifikus szoftver telepítése.

Ez a keretrendszer lehetővé teszi a számítógépről érkező parancsok egyszerű kezelését. Az eszköz terminálból való kezelését segíti, visszaküldi a leütött betűket, lehetővé teszi az visszakeresést, valamint további terminál alkalmazásokban megszokott kiegészítő funkciót implementál.

## 2.3 Kijelző [13] [14]

A kijelző kiválasztásánál a következő szempontokat vettem figyelembe: képpontonkénti kezelhetőség (például nem 8 szegmenses), kontraszt, megfelelő méret, I2C vagy SPI támogatása, jó dokumentáció elérhetősége, professzionális megjelenés.

A fenti elvárásaimat tökéletesen teljesítette egy, a Newhaven Display International által gyártott 128x32 felbontású kék OLED panel (NHD-2.23-12832UCB3). Ez az OLED panel az SSD1305 típusú vezérlő IC-vel van szerelve. Ez a vezérlő IC támogat párhuzamos és soros kommunikációt is, és maga az OLED panel is úgy van megvalósítva, hogy ezeket a kommunikációs protokollokat támogatja, én az I2C kommunikációt választottam.

Sajnos ehhez a meghajtó IC-hez nem találtam szabadon felhasználható I2C drivert, ezért ezt nekem kellett megvalósítanom az adatlapja alapján.

### 2.3.1 Nyomtatott áramkör

Az OLED panel egy nyomtatott áramkörre szerelve kapható, amin 20 csatlakozási furat van kialakítva. Ezeket a csatlakozási pontokat a kívánt kommunikációs protokollnak és egyéb paramétereknek megfelelően kell földre vagy logikailag magas feszültségre „húzni”, illetve a megfelelő csatlakozási pontokon keresztül kell a mikrovezérlővel összekötni, hogy megvalósuljon a kommunikáció. A megfelelő kapcsolást a panel adatlapja részletezni (11. ábra).

A képen szöveg, diagram, Betűtípus, sor látható Előfordulhat, hogy az AI által létrehozott tartalom helytelen.

Error! Use the Home tab to apply 0 to the text that you want to appear here.-11. ábra OLED panel adatlapi ábrája I2C konfigurációhoz [14]

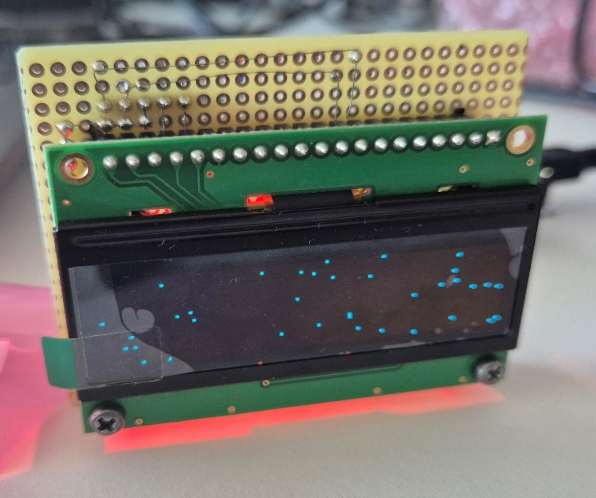
[picture p90: figure]
A képen elektronika, Elektronikus eszköz, számítógép, Számítógép-alkatrész látható Előfordulhat, hogy az AI által létrehozott tartalom helytelen.
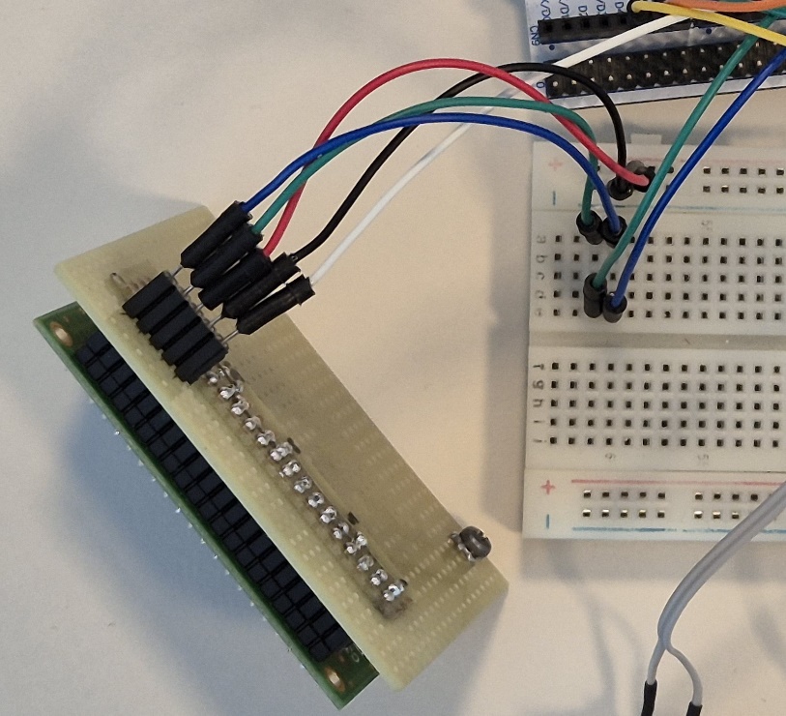
[picture p91: figure]
A képen Elektromos vezetékek, Elektrontechnika, kábel, elektronika látható Előfordulhat, hogy az AI által létrehozott tartalom helytelen.

Error! Use the Home tab to apply 0 to the text that you want to appear here.-12. ábra OLED modul próbapanelen

Amíg a panel funkcionalitásait teszteltem és a drivert írtam hozzá addig ideiglenesen egy próbapanelen hoztam létre ezt a kapcsolást és azon helyeztem el az I2C felhúzó ellenállásait is. Így a mikrovezérlőhöz már csak 5 vezetéket kellett vezetnem.

A végső megvalósításhoz ez alapján nyomtatott áramkört terveztem. Az áramkörön az A0 kiválasztására 0R ellenállás beforrasztásával van lehetőség, valamint bele terveztem egy tápfeszültség visszajelző LEDet is (ez a próbapanelen is helyet kapott).

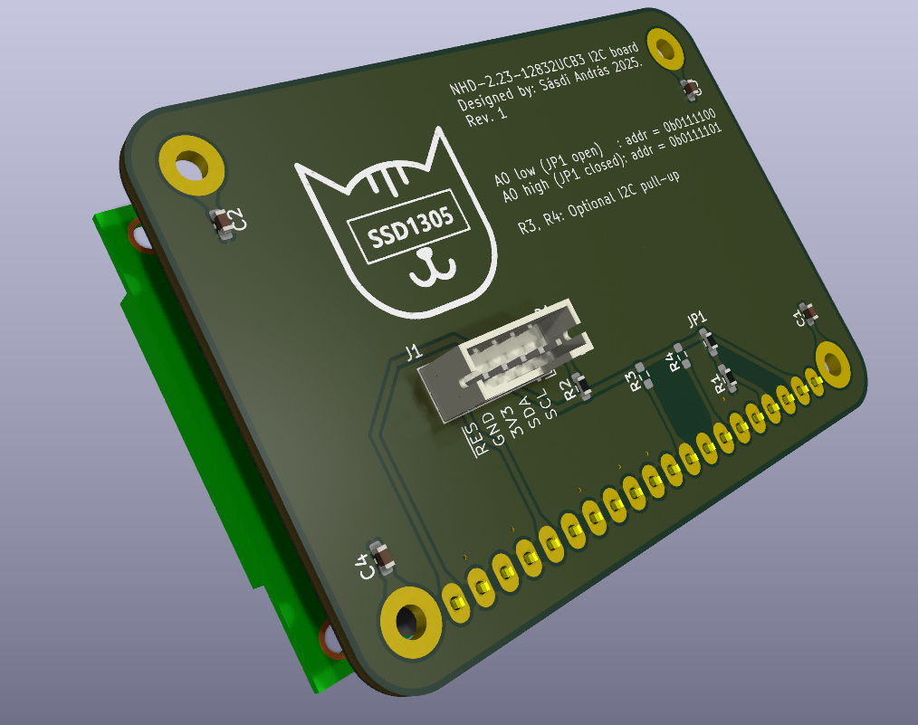
[picture p92: figure]
A képen szöveg, elektronika, Betűtípus, Elektrontechnika látható Előfordulhat, hogy az AI által létrehozott tartalom helytelen.

Error! Use the Home tab to apply 0 to the text that you want to appear here.-13. ábra OLED modul nyomtatott áramkörön

A képen is látható R3 és R4 ellenállások az I2C felhúzó ellenállásainak a helyei. Mivel az I2C busz felhúzó ellenállásai az alaplapon, a mikrovezérlőhöz minél közelebb lesznek beépítve, ezért ezeket nem szabad jelen esetben beültetni. Helyük azért van kialakítva, hogy ettől a projekttől függetlenül is, akár önállóan felhasználható legyen az áramkör.

## 2.4 Gomb panel

A felhasználó az eszközt (ha nem számítógépen keresztül kommunikál) gombok segítségével tudja kezelni. Annak érdekében, hogy a gombokat az alaplaptól függetlenül el tudjam helyezni az eszközön, a gomboknak külön panelt hoztam létre.

A nyomógombok típusának kiválasztásában fontos szempont volt a taktilis visszajelzés. A gumimembrános gomboknál a felhasználók sokszor nem érik biztosra, hogy lenyomták-e a gombot, van, hogy túl erősen nyomják és összességében „olcsó” hatást adnak az eszköznek. Ezzel szemben a mechanikus gombok, amiknek van érezhető átbillenési pontja visszajelzést adnak a felhasználónak a gomb lenyomásáról. Ismert kapcsoló gyártó cég a Cherry, aminek a kék típusú kapcsolóját választottam. Ezek a gombok egyértelmű aktivációs ponttal és érezhető kattanással és hanggal rendelkeznek. A lenyomásról a felhasználó biztos visszajelzést kap.

A mechanikus kapcsolók (nyomógombok, relék stb.) tulajdonsága az úgynevezett „pergés”. Ez a jelenség abból adódik, hogy a mechanikailag bistabil rendszert az egyik állapotából a másikba billentve a rugalmas érintkező tagok visszapattanhatnak egymásról, így több kapcsolódás-szakadás periódus alakulhat ki az állapot állandósulása előtt [15]. Ez a jelenség ahhoz vezet, hogy a felhasználó egyszeri gombnyomását a mikrovezérlő sok egymás utáni lenyomásként érzékeli. Ennek a nem kívánatos jelenségnek több elterjedt és bevált kezelése is létezik. A gomb panel megépítése előtt, az állapotgép tesztelésekor szoftveres megoldást használtam. A hardveres megoldások közt elterjedt az RC tag, illetve ennek ötvözése egy hiszterézises kapcsolóval (schmitt triggerrel). Én schmitt trigger nélküli, egyszerű RC tagos megoldást választottam (Error! Use the Home tab to apply 0 to the text that you want to appear here.-14. ábra), ami lényegében egy alul áteresztő szűrő. Első iterációban ezt 0.5ms-os feltöltési és 5ms kisütési idővel terveztem. Ezt az áramkör megérkezésekor tesztelni fogom, hogy megfelelő-e és ez alapján szükség esetén módosítom az ellenállás és kondenzátor értékeket.


Error! Use the Home tab to apply 0 to the text that you want to appear here.-14. ábra Nyomógomb pergésmentesítése

A szűrő válaszát a gomb lenyomására és felengedésére (pergést nem szimulálva) a köveztkező ábra mutatja


A nyomtatott áramkörön a bővíthetőség érdekében a szükségesnek ítélt gombokon kívül kialakítottam még egy további gombnak a helyét.

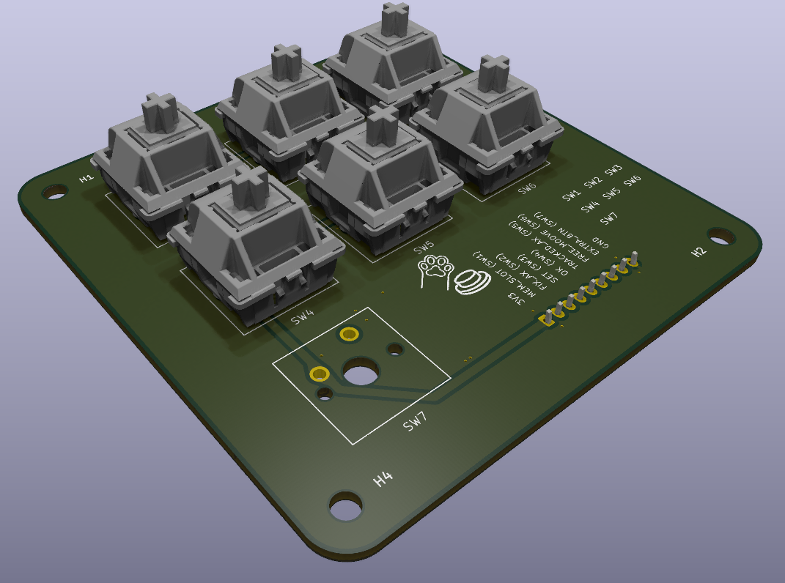
[picture p93: figure]

## 2.5 Számlap

Az eszköz másik fontos kezelőszerve a numerikus billentyűzet. Ezzel tudja a felhasználó bevinni a kívánt szög értéket, valamint szabad mozgatás állapotban a mozgatás is ezzel valósítható meg. A számlap gombjaival szemben is a korábban támasztott elvárásaim voltak, ezért itt is Cherry Blue nyomógombokat használtam.

Mivel az eszköznek sok perifériát kell kezelnie és szempont a bővíthetőség, Minimalizálni szerettem volna a számlap kezeléséhez felhasznált GPIO-k számát. Egy lehetséges megoldás erre, és amivel tovább haladtam az egy analóg megközelítés. A kimeneti feszültség a lenyomott gombbal arányos. Ezt a megoldást a vezetékes fülhallgatók gombjainak kivitelezéséből merítettem [16].

A feszültségosztós megoldásnál alapvetően két megközelítés lehetséges. Az első, hogy a be- és kimeneti feszültséget is méri a mikrovezérlő és ennek kettőnek a hányadából lehet a lenyomott gombot megállapítani. Ennek előnye, hogy a bemeneti feszültség változása nem befolyásolja a módszer eredményét, hátránya viszont, hogy 2 analóg-digitális átalakító is szükséges hozzá. A második megközelítés ismert referenciafeszültség létrehozása, majd ennek az osztása. Ebben az esetben elegendő egy ADC használata, a mért jelet ismert szintekhez hasonlítva.

Mivel az eszköz tervezése során a modularitás és rugalmasság központi szempont a két megközelítést ötvöztem. A bemeneti 5V-ból 3V-os referenciafeszültséget hozok létre, de mind a bemeneti, mind az osztott feszültség vissza van vezetve a mikrovezérlőhöz. A feszültségek visszamérését követőerősítőkön keresztül vezetem vissza, de erősítésnek a lehetőségét kialakítottam: a visszacsatolás 0R ellenálláson keresztül, valamint nem beépített 0603-as beforrasztási lehetőség passzív alkatrésznek, amivel erősítés vagy szűrés megvalósítható. Tehát akár az is megoldható, hogy a bemeneti 5V-ot vezetem a feszültségosztóra (kiveszem a referenciafeszültséget biztosító állítható referenciát), majd visszamérés előtt ezt visszaskálázom a mikrovezérlőnek megfelelő feszültségtartományra.

Ez a megközelítés felépítéséből adódóan érzékeny a passzív komponensek értéknek szórására. A 0.1%-os pontosságú ellenállások bőségesen elérhetőek és nem számítanak drága, precíziós ellenállásnak. Azt, hogy ez a pontossági kategória elegendő lesz-e LTspice szoftverben ellenőriztem, Monte Carlo legrosszabb esetek elemzéssel. Ennek a lényege, hogy végig iterálja a tűréssel ellátott passzív komponenseknek az adott tűréssel megadott leg rosszabb értékeit, így minden legrosszabb kombinációt lemodellez.

Az áramkör tervezésénél a visszamérés előtt a feszültségosztó kimenetét egy alul áteresztő szűrőn keresztül vezetem. Ennek az értékei egyelőre 1k ohm és 1nF, de amennyiben szükséges, a panel viselkedésének kimérése után ez módosítható.

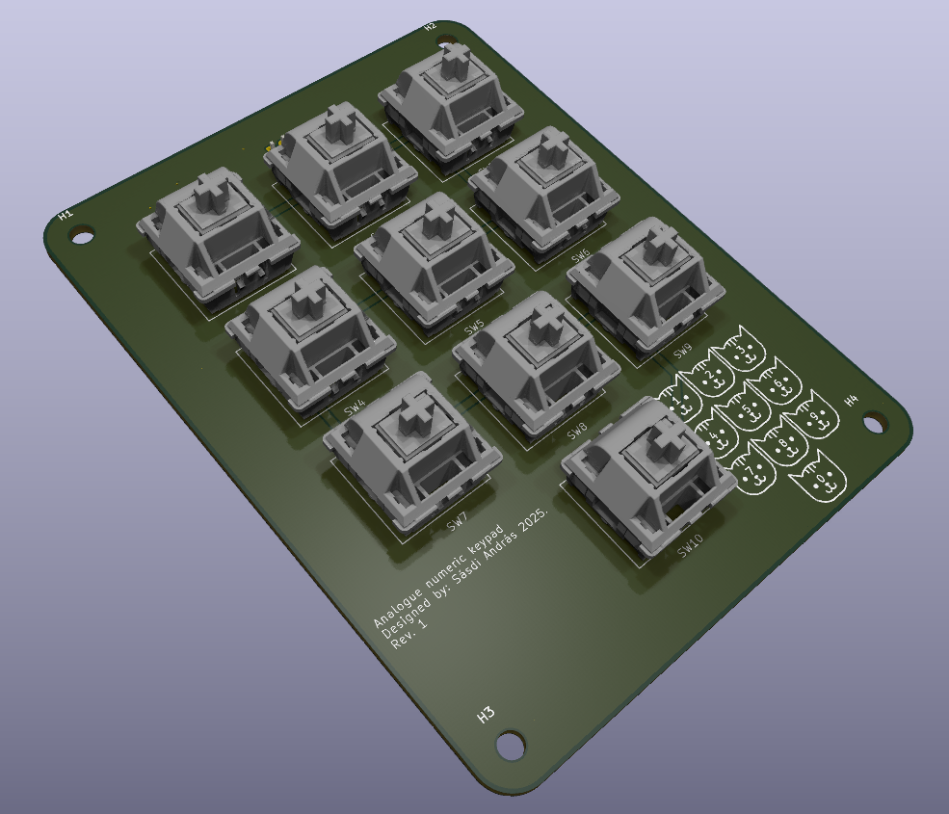
[picture p94: figure]

## 2.6 Referenciaszenzor

## 2.7 EEPROM

## 2.8 Alaplap

# 3 Irodalomjegyzék

[1] | „All about MEMS sensors,” © Bosch Sensortec GmbH, 2024. [Online]. Available: https://www.bosch-sensortec.com/about-us/our-company/mems/. [Hozzáférés dátuma: 10 05 2025].
[2] | C. Murphy, „Why MEMS Accelerometers Are Becoming the Designer’s Best Choice for CbM Applications,” Analog Devices, 01 02 2021. [Online]. Available: https://www.analog.com/en/resources/technical-articles/why-memes-acceler-are-best-choice-for-cbm-apps.html. [Hozzáférés dátuma: 10 05 2025].
[3] | PCB design guidelines for MEMS sensors, STMicroelectronics, 2023.
[4] | „Acceleration sensor: BMA580,” © Bosch Sensortec GmbH, 2024. [Online]. Available: https://www.bosch-sensortec.com/products/motion-sensors/accelerometers/bma580/. [Hozzáférés dátuma: 10 05 2025].
[5] | Z. Bende és A. Rávai, Gépek biztonsága, Budapest: Akadémiai Kiadó, 2018.
[6] | Technológiai és Ipari Minisztérium, MUNKAESZKÖZÖK BIZTONSÁGA, Technológiai és Ipari Minisztérium, 2022.
[7] | ATMEL, „AVR446: Linear speed control of stepper motor,” Atmel Corporation, San Jose, CA 95131, USA, 2006.

# Irodalomjegyzék

[1] Levendovszky, J., Jereb, L., Elek, Zs., Vesztergombi, Gy.: Adaptive statistical algorithms in network reliability analysis, Performance Evaluation - Elsevier, Vol. 48, 2002, pp. 225-236
[2] National Istruments: LabVIEW grafikus fejlesztői környezet leírása, http://www.ni.com/ (2010. nov.)
[3] Fowler, M.: UML Distilled, 3rd edition, ISBN 0-321-19368-7, Addison-Wesley, 2004
[4] Wikipedia: Evaluation strategy, http://en.wikipedia.org/wiki/Evaluation_strategy (revision 18:11, 31 July 2012)

# Függelék
