SAndras01/Masters-thesis/Dokumentáció/DIP A/SásdiAndrás_Forgóasztal.pptx

## KÉT TENGELYŰ FORGÓASZTAL GYORSULÁSMÉRŐ SZENZOROK KARAKTERIZÁLÁSÁHOZ

(Diplomatervezés A)
Sásdi András
Email: sasdiandris01@gmail.com
Tel.: 06305779087

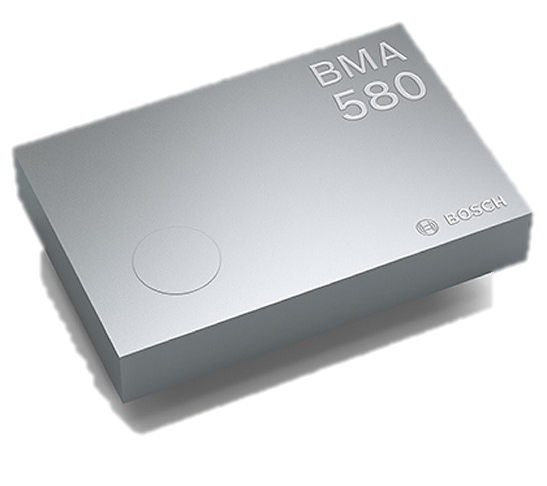
[picture p95: figure]
A képen elektronika, tervezés látható Előfordulhat, hogy a mesterséges intelligencia által létrehozott tartalom helytelen.
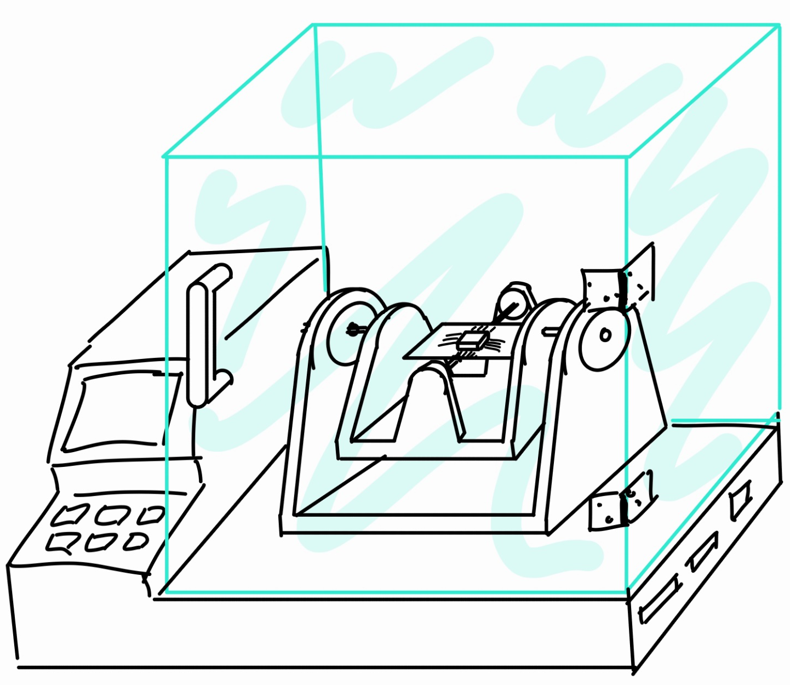
[picture p96: figure]
A képen szöveg, diagram, rajz, vázlat látható Előfordulhat, hogy a mesterséges intelligencia által létrehozott tartalom helytelen.
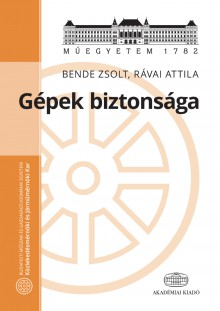
[picture p97: figure]
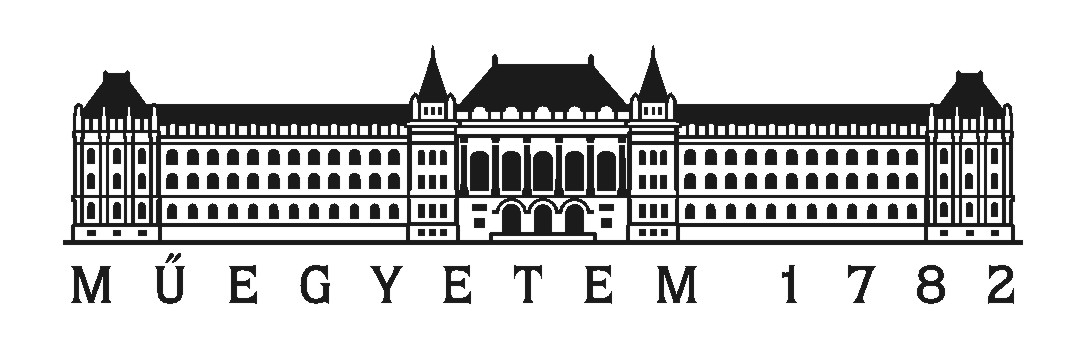
[picture p98: figure]

Notes: Diplomamunka A - tervezés

## MEMS szenzorok

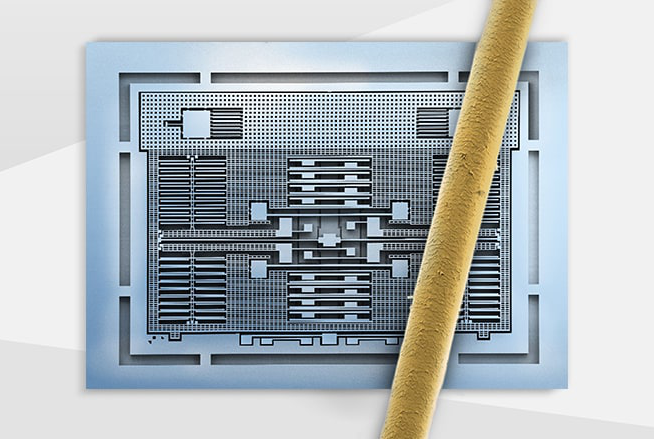
[picture p99: figure]
Automotive MEMS Sensors
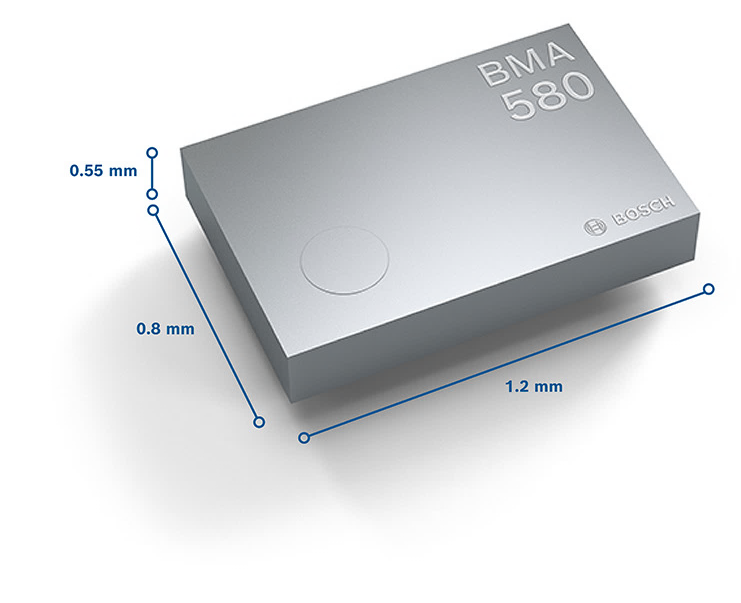
[picture p100: figure]
A képen elektronika, tervezés látható Előfordulhat, hogy a mesterséges intelligencia által létrehozott tartalom helytelen.

Notes: Mikromechanikai szerkezettel alakítják át a fizikai mennyiséget elektromos jellé
Jeltovábbítás előtt jelerősítés és kondicionálás, digitalizálják.
Mérendő mennyiség lehet Nyomás, Gyorsulás, gázkoncentráció stb
Felhasználásuk sokrétű, egyre elterjedtebbek

Kis méret
Megbízhatóság
Alacsony áramfelvétel

## A megoldandó probléma

MEMS gyorsulásérzékelők manuális pozicionálása

Automatizálás

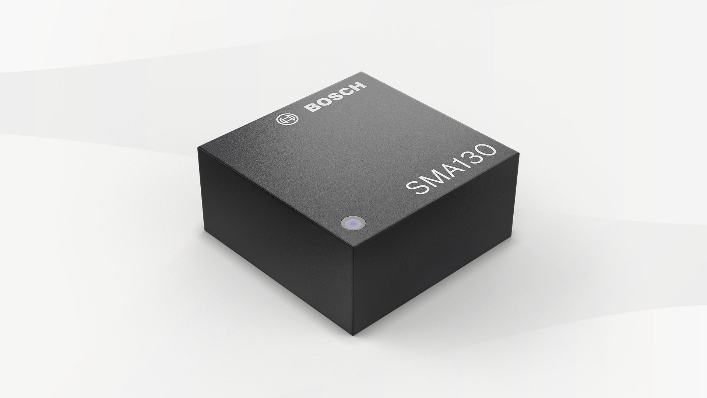
[picture p101: figure]

Távolról végezhető
Gyorsabb
Jobb reprodukálhatóság
Mérnökórák ideálisabb kihasználása

Notes: Karakterizáció során egyes tesztek elvégzéséhez szükséges a mért szenzor pozicionálás
Jelenleg a mérést végzést mérnöknek kell ezt megtennie manuálisan
Feladat a Tengelyek beforgatása a gravitációs térrel párhuzamos irányba

Ott kell lenni
Sok idő
Kevésbé reprodukálható

## Elvárások és kihívások

- Manuális forgatás kiváltása
- Hozzáférés a mért szenzorhoz
- Vezérelhető számítógépről vagy kezelőpanelről
- Laborbiztonságnak megfelel

Notes: A szenzor tengelyei beforgathatóak legyenek a gravitációs térrel párhuzamos orientációba
A mért szenzor táp- és jelvezetékei ki legyenek vezetve
Az eszköz vezérlőpanelről és PC-ről egyaránt vezérelhető kell, hogy legyen
Ne legyen veszélyforrás, a laborban üzembehelyezhető legyen

## Mechanizmus - Tengelyek

A képen szöveg, kézírás, rajz, tinta látható Előfordulhat, hogy a mesterséges intelligencia által létrehozott tartalom helytelen.
A képen szöveg, kézírás, rajz, tinta látható Előfordulhat, hogy a mesterséges intelligencia által létrehozott tartalom helytelen.
A képen szöveg, kézírás, rajz, tinta látható Előfordulhat, hogy a mesterséges intelligencia által létrehozott tartalom helytelen.

Notes: Akár 3tengelyes gyorsulásmérő szenzor bármely tengelye párhuzamos tudjon lenni a g-vel
Legalább két tengely körül forgatott forgóasztal
Nézzük hogyan oldható meg

## Jeltovábbítás

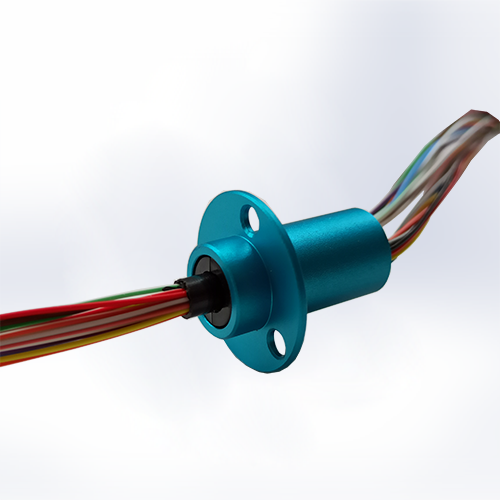
[picture p102: figure]
OD12.4mm 18 Channel 2A - ZER-X1A - Slipring Elektrik A.S.
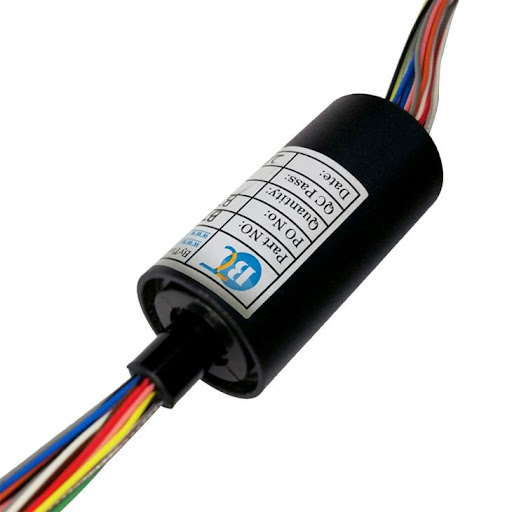
[picture p103: figure]
csúszógyűrű fémház gyártóval, beszállítóval, eladóval - ByTune Electronics Co., Ltd.

Notes: A forgóasztalhoz a jel továbbításának kézenfekvő megoldása a csúszógyűrűk használata. Könnyen beszerezhető, sorozatgyártott alkatrészek
Fontos szempont, hogy a kommunikációs jelek továbbítására alkalmasak legyenek.

## Mechanizmus – Motorok elrendezése

Forgatott motor

Fix motor

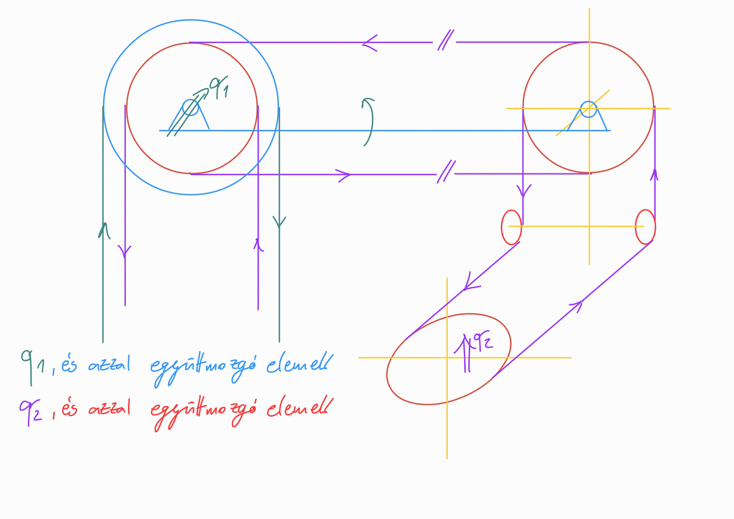
[picture p104: figure]
A képen vázlat, rajz, diagram, szöveg látható Előfordulhat, hogy a mesterséges intelligencia által létrehozott tartalom helytelen.
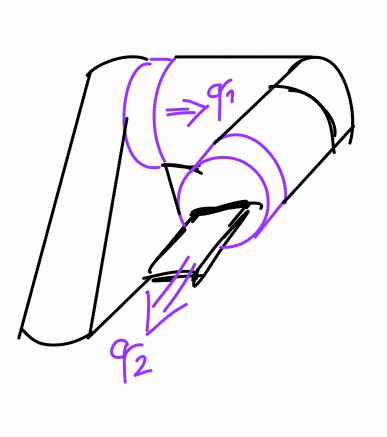
[picture p105: figure]
A képen szöveg, kézírás, rajz, tinta látható Előfordulhat, hogy a mesterséges intelligencia által létrehozott tartalom helytelen.
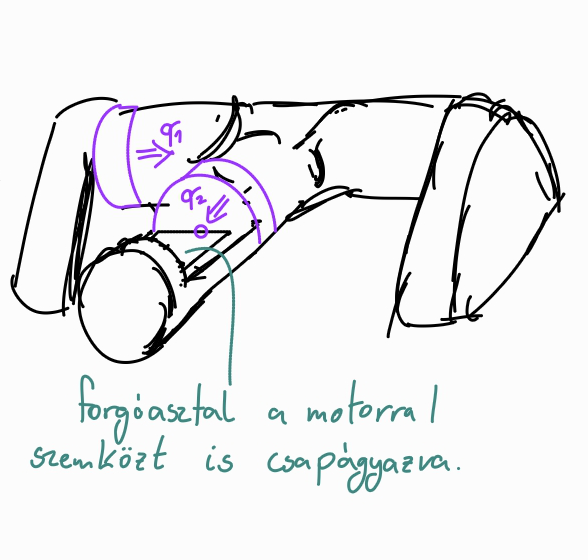
[picture p106: figure]
A képen szöveg, kézírás, rajz, tinta látható Előfordulhat, hogy a mesterséges intelligencia által létrehozott tartalom helytelen.

Notes: Forgatott motor

Motor tengelye ne legyen egyedüli teherviselő

Hátrány:
q2 táp és jelvezetékei,
Többeres csúszógyűrű vagy párhuzamosan több használata
Nagy áram továbbítása csúszógyűrűn, jelvezeték mellett
q2 súly
Q1-nek erősebbnek kell lennie
Nagyobb szerkezet

Fix motor ezeket megoldja, de:

Bonyolultabb szerkezet
Nem lehet backlash
Több meghibásodási lehetőség

## Biztonság – veszély felmérése

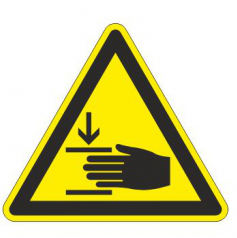
[picture p107: figure]
Figyelmeztető táblák

Forgó alkatrészek

veszély

Ütés, nyírás

Kockázat minimalizálása

Védőburkolat

Notes: Lássa el a feladatot, legyen a szenzor elérhető

## Biztonság – Védőburkolat

- Szilárd, nem megkerülhető, nem idéz elő új veszélyt
- Csak szükséges mértékben korlátozza a munkát
- Ne ösztönözze a megkerülését

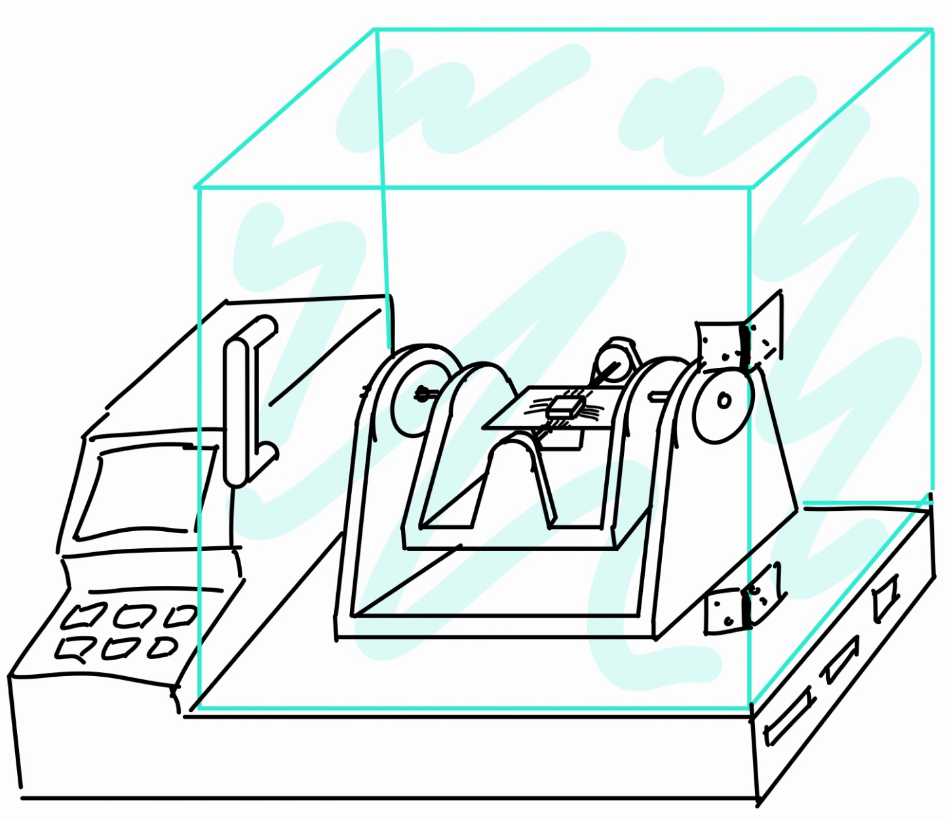
[picture p108: figure]
A képen szöveg, diagram, rajz, vázlat látható Előfordulhat, hogy a mesterséges intelligencia által létrehozott tartalom helytelen.

- Víztiszta polikarbonát
- Csak a veszélyforrást fedi
- Szerszám nélkül nyitható

## Biztonság – További megfontolások

- Nyitott burkolat esetén veszélyes funkciók kikapcsolása
- Vészleállítási lehetőség
- Tesztelhetőség

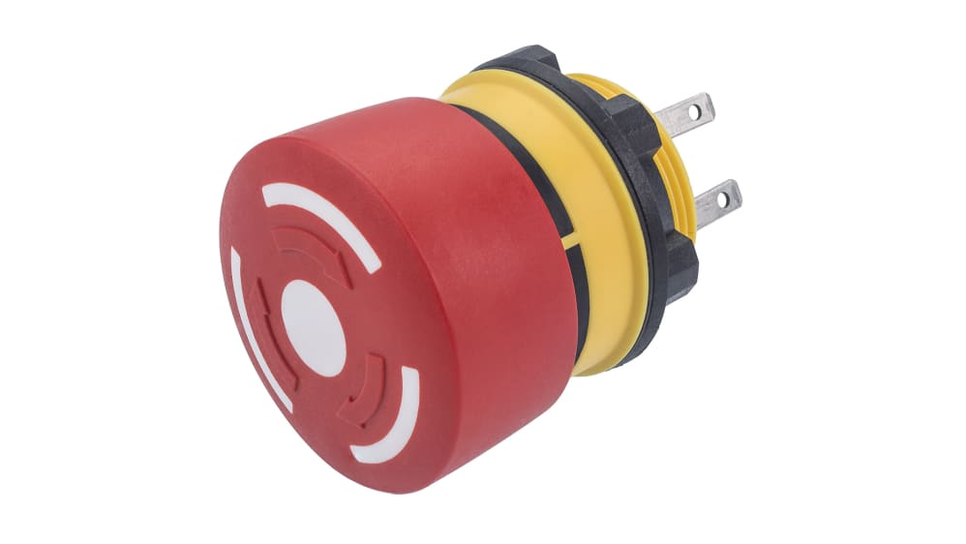
[picture p109: figure]
84-5240.0020 | EAO vészleállító nyomógomb, 22mm, Panelre szerelhető, Menetes kioldású, 2 alaphelyzetben zárt, IP65, IP67 | RS

- Reteszelt védőburkolat
- Vészleállító gomb
- Visszajelző LED-ek

Notes: Reteszelt védőburkolat: reteszelő berendezéssel (reteszeléssel) úgy összekapcsolt védőburkolat, hogy a gép vezérlőrendszerével együtt teljesíti a következő funkciókat:
a védőburkolattal „lefedett” veszélyes gépi funkciók nem működtethetők mindaddig, amíg a védőburkolat nincs becsukva;
ha a védőburkolat nyitva van, miközben a veszélyes gépi funkciókat működtetik, akkor állj parancsot ad, és
ha a védőburkolat be van csukva, akkor a védőburkolattal „lefedett” veszélyes gépi funkciók működtethetők (a védőburkolat becsukása önmagában nem indítja el a veszélyes gépi funkciókat).

A biztonsági berendezések vizsgálhatóságát is figyelembe kell venni a tervezéskor. A berendezés által kiadott jelet, valamint a megszakítók állapotát is vizuális visszajelzéssel kell ellátni, például egy piros és egy zöld LED-del

## Köszönöm a figyelmet!

Notes: Következő lépés: megvalósítás
