SAndras01/Masters-thesis/images/20251127_200728.jpg

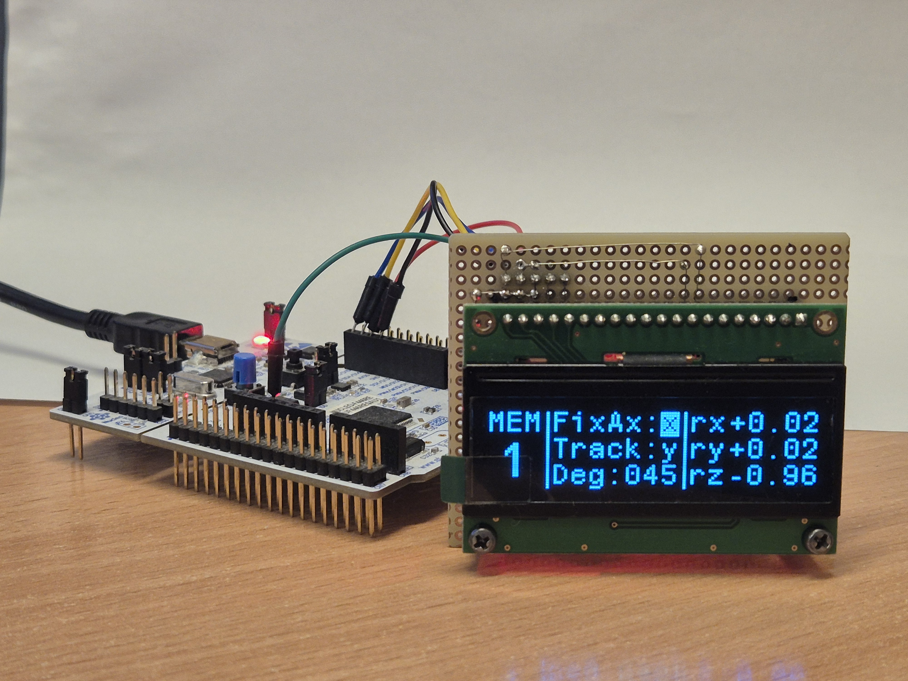
images/20251127_200728.jpg
