SAndras01/Masters-thesis/images/20251127_200736.jpg

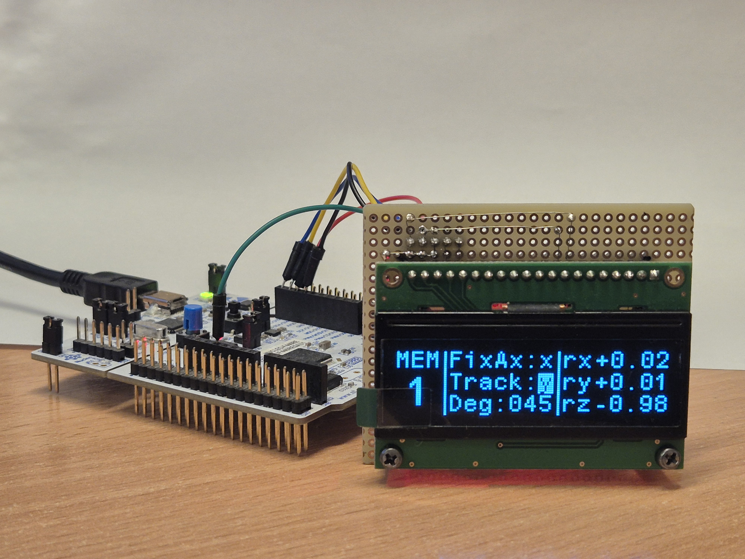
images/20251127_200736.jpg
