SAndras01/Masters-thesis/KiCad/motherboard/motherboard_.png

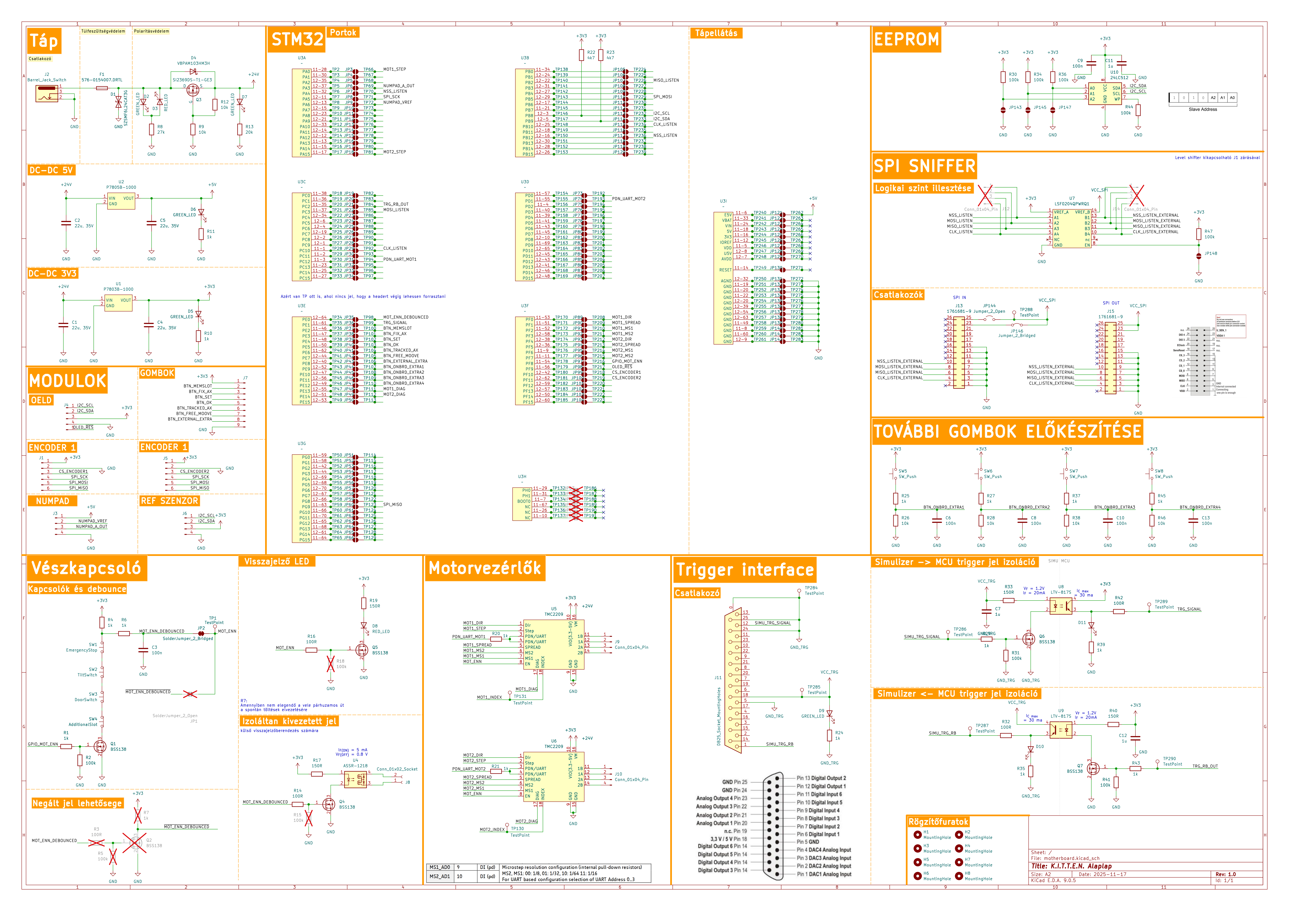
KiCad/motherboard/motherboard_.png
