SAndras01/Masters-thesis/python/LUT/output.png

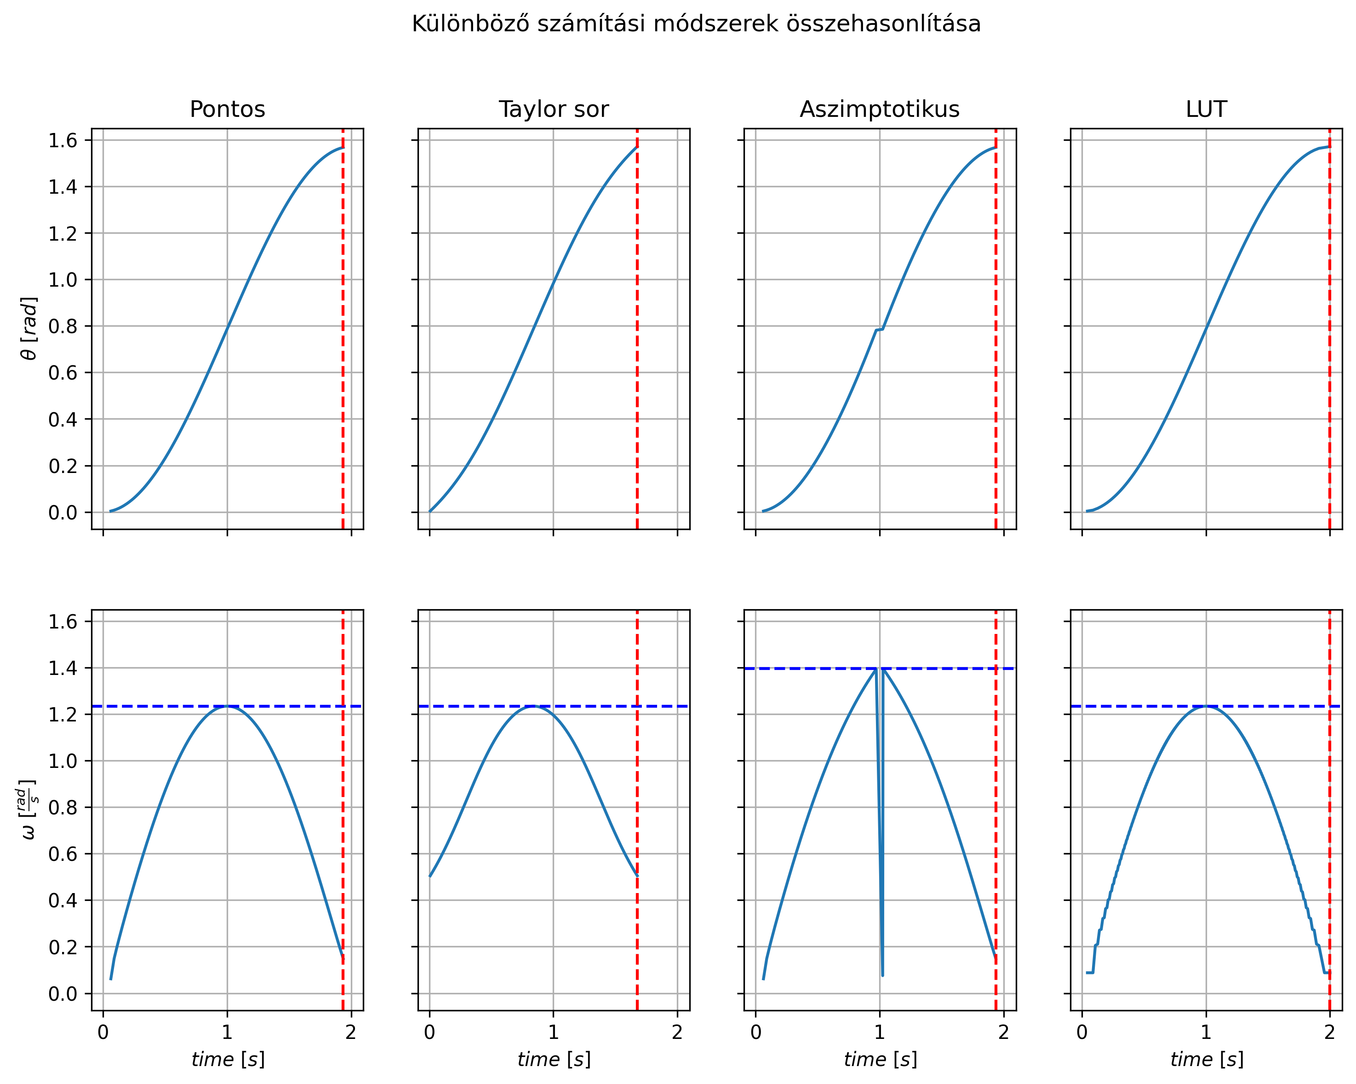
python/LUT/output.png
