SAndras01/Masters-thesis/KiCad/BOMs/Boms.xlsx

Sheet: buttons
Id | Designator | Footprint | Quantity | Designation | Supplier and ref | megjegyzés | Rendelve | Megérkezett | Beültetve
1 | SW2,SW4,SW5,SW7,SW3,SW6,SW1 | SW_Cherry_MX_1.00u_PCB | 7 | Cherry Switch Single | MX1A-E1NW |  |  | 1
2 | J1 | JST_PH_B9B-PH-K_1x09_P2.00mm_Vertical | 1 | Conn_01x09_Pin | 306-B9BPHKSLFSNP |  |  | 1
3 | R13,R2,R1,R8,R3,R7,R9 | R_0603_1608Metric | 7 | 1k | MCT06030D1001BP500 |  |  | 1
4 | C2,C3,C6,C1,C4,C7,C5 | C_0603_1608Metric | 7 | 100n | GA0603Y104KXAAC31G |  |  | 1
5 | R14,R12,R5,R6,R11,R4,R10 | R_0603_1608Metric | 7 | 10k | MCT06030D1002BP500 |  |  | 1

Sheet: display
Id | Designator | Footprint | Quantity | Designation | Supplier and ref | megjegyzés | Rendelve | Megérkezett | Beültetve
1 | J1 | JST_PH_B5B-PH-K_1x05_P2.00mm_Vertical | 1 | Conn_01x05_Pin | 306-B5BPHKSLFSNP |  |  | 1
2 | R1 | R_0603_1608Metric_Pad0.98x0.95mm_HandSolder | 1 | 15k | - | Ez csak az A0 lehúzó ellenállása, nem kell megrendelni
3 | R3,R4 | R_0603_1608Metric | 2 | 2k2 | 594-MCT06030D2201BP5 | I2C felhúzó ellenállás, a működés ellenőrzéséhez kell
4 | C1,C3,C2,C4 | C_0603_1608Metric | 4 | 1n | 77-VJ0603Y102JXACBC
5 | D1 | D_0603_1608Metric | 1 | LED | 150060VS83000 | Zöld LED
6 | R2 | R_0603_1608Metric | 1 | 150R | 594-MCT06030D1500BP5
7 | U1 | NHD-2.23-12832UCB3 | 1 | Display | - | Ez már meg van

Sheet: numpad
Id | Designator | Footprint | Quantity | Designation | Supplier and ref | megjegyzés | Rendelve | Megérkezett | Beültetve
1 | SW5,SW7,SW3,SW6,SW8,SW2,SW10,SW9,SW4,SW1 | SW_Cherry_MX_1.00u_PCB | 10 | Cherry Switch Single | MX1A-E1NW
2 | TP1,TP2 | TestPoint_Pad_D2.0mm | 2 | TestPoint | -
3 | R12,R13,R15,R10,R9,R16,R14,R17,R1,R18,R20,R11 | R_0603_1608Metric | 12 | 1k | MCT06030D1001BP500
4 | R8 | R_0603_1608Metric | 1 | 7k5 | MCT06030D7501BP500
5 | J1 | JST_PH_B4B-PH-K_1x04_P2.00mm_Vertical | 1 | Conn_01x04_Pin | B4B-PH-K-S(LF)(SN)
6 | C2,C1 | C_0603_1608Metric_Pad1.08x0.95mm_HandSolder | 2 | C | DNP
7 | R5,R4 | R_0603_1608Metric | 2 | 0R | 71-CRCW06030000Z0EE
8 | D1 | D_0603_1608Metric | 1 | LED | 150060VS83000 | Zöld LED
9 | R7,R6 | R_0603_1608Metric | 2 | 100R | MCT06030D1000BP500
10 | U2 | SOIC-8_3.9x4.9mm_P1.27mm | 1 | TL431D | 595-TL431BCDR
11 | R3 | R_0603_1608Metric | 1 | 51k | 594-MCT06030D5102BP5
12 | R2 | R_0603_1608Metric | 1 | 10k | MCT06030D1002BP500
13 | R19 | R_0603_1608Metric | 1 | 100k | MCT06030D1003BP500
14 | R21 | R_0603_1608Metric | 1 | 4k7 | 594-MCT06030D4701BP5
15 | U1 | SOIC-8_3.9x4.9mm_P1.27mm | 1 | LT1632 | 584-LT1632IS8#PBF
16 | C3 | C_0603_1608Metric | 1 | 1n | 77-VJ0603Y102JXACBC

Sheet: motherboard
Id | Designator | Footprint | Quantity | Designation | Supplier and ref | megjegyzés | Rendelve | Megérkezett | Beültetve
45 | J2 | BarrelJack_Wuerth_694106106102_2.0x5.5mm | 1 | Barrel_Jack_Switch | 710-694108106102
19 | C12,C7,C11 | C_0603_1608Metric | 3 | 1u | 963-TMK107B7105KA-T
25 | C8,C10,C9,C3,C13,C6 | C_0603_1608Metric | 6 | 100n | GA0603Y104KXAAC31G
5 | C2,C4,C1,C5 | C_1206_3216Metric | 4 | 22u, 35V | 810-C3216X5R1V226M
21 | D11,D10,D9,D6,D2,D7,D5 | D_0603_1608Metric | 7 | GREEN_LED | 150060VS83000
32 | D8,D3 | D_0603_1608Metric | 2 | RED_LED | 710-150060SS75003
47 | D1 | D_SOD-123 | 1 | SZSMF6L24CAT3G | 576-SZSMF6L24CAT3G
39 | J11 | DSUB-25_Socket_Horizontal_P2.77x2.84mm_EdgePinOffset7.70mm_Housed_MountingHolesOffset9.12mm | 1 | DB25_Socket_MountingHoles | 622-025-260-042
28 | F1 | Fuseholder_Littelfuse_Nano2_154x | 1 | 576-0154007.DRTL | 576-0154007.DRTL
3 | SW5,SW6,SW8,SW7 | JST_PH_B2B-PH-K_1x02_P2.00mm_Vertical | 4 | SW_Push | B2B-PH-K-S(LF)(SN)
12 | J6,J3,J10,J9 | JST_PH_B4B-PH-K_1x04_P2.00mm_Vertical | 4 | Conn_01x04_Pin | 306-B4BPHKSLFSNPP
33 | J4 | JST_PH_B5B-PH-K_1x05_P2.00mm_Vertical | 1 | Conn_01x05_Pin | 306-B5BPHKSLFSNP
14 | J1,J5 | JST_PH_B6B-PH-K_1x06_P2.00mm_Vertical | 2 | Conn_01x06_Pin | 306-B6B-PH-K-SLFSN
18 | J7 | JST_PH_B9B-PH-K_1x09_P2.00mm_Vertical | 1 | Conn_01x09_Pin | 306-B9BPHKSLFSNP
46 | U3 | NUCLEO-F767ZI | 1 | ~
37 | TP288 | PinHeader_1x01_P2.54mm_Vertical | 1 | TestPoint
38 | JP144 | PinHeader_1x02_P2.54mm_Vertical | 1 | Jumper_2_Open |  | Ezek a jumpereknek ilyen 2-es pinek
44 | JP146 | PinHeader_1x02_P2.54mm_Vertical | 1 | Jumper_2_Bridged |  | Ezek a jumpereknek ilyen 2-es pinek
2 | J13,J15 | PinHeader_2x13_P2.54mm_Vertical | 2 | 1761681-9 | 571-1761681-9
1 | TP185,TP75,TP14,TP182,TP194,TP196,TP99,TP282,TP275,TP76,TP218,TP67,TP79,TP240,TP138,TP59,TP145,TP277,TP191,TP82,TP239,TP43,TP245,TP169,TP45,TP214,TP258,TP102,TP243,TP58,TP7,TP230,TP62,TP270,TP158,TP232,TP167,TP101,TP4,TP281,TP9,TP264,TP251,TP114,TP234,TP46,TP47,TP168,TP257,TP206,TP263,TP205,TP154,TP70,TP237,TP77,TP20,TP121,TP268,TP133,TP256,TP219,TP278,TP179,TP184,TP220,TP10,TP157,TP57,TP96,TP162,TP254,TP92,TP209,TP74,TP180,TP207,TP143,TP265,TP109,TP68,TP113,TP201,TP90,TP110,TP54,TP159,TP279,TP216,TP262,TP172,TP33,TP136,TP244,TP17,TP122,TP241,TP141,TP52,TP95,TP217,TP242,TP49,TP227,TP274,TP97,TP98,TP61,TP66,TP146,TP247,TP34,TP5,TP105,TP231,TP151,TP225,TP215,TP210,TP19,TP170,TP189,TP260,TP28,TP85,TP63,TP8,TP200,TP204,TP259,TP126,TP123,TP235,TP84,TP165,TP65,TP103,TP112,TP83,TP25,TP11,TP104,TP188,TP197,TP252,TP24,TP115,TP178,TP193,TP190,TP27,TP36,TP255,TP15,TP38,TP148,TP69,TP134,TP150,TP13,TP142,TP213,TP55,TP223,TP224,TP87,TP16,TP198,TP91,TP132,TP212,TP233,TP56,TP253,TP51,TP155,TP236,TP119,TP144,TP3,TP6,TP261,TP156,TP32,TP186,TP181,TP44,TP31,TP22,TP166,TP78,TP276,TP89,TP267,TP30,TP152,TP280,TP120,TP40,TP127,TP249,TP195,TP199,TP26,TP80,TP128,TP48,TP100,TP248,TP39,TP140,TP202,TP93,TP88,TP283,TP171,TP129,TP203,TP12,TP137,TP71,TP266,TP273,TP23,TP164,TP118,TP211,TP18,TP161,TP35,TP125,TP221,TP229,TP94,TP173,TP149,TP176,TP183,TP272,TP64,TP246,TP29,TP177,TP153,TP174,TP108,TP42,TP2,TP37,TP73,TP72,TP81,TP271,TP269,TP107,TP135,TP117,TP238,TP116,TP139,TP163,TP106,TP53,TP208,TP21,TP228,TP25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 | PinSocket_1x01_P2.54mm_Vertical | 280 | TestPoint_Small |  | Ide igazából 2soros anya kell
24 | TP131,TP130 | PinSocket_1x01_P2.54mm_Vertical | 2 | TestPoint
36 | J12,J14 | PinSocket_1x04_P2.54mm_Vertical | 2 | Conn_01x04_Pin |  | SPI illesztő mellett tüskesor
4 | R43,R10,R25,R6,R1,R39,R27,R24,R21,R35,R20,R4,R45,R7,R29,R37,R11 | R_0603_1608Metric | 17 | 1k | MCT06030D1001BP500
6 | R19 | R_0603_1608Metric | 1 | 330R |  | 150R-re frissítve a rajzon
7 | R16,R42,R3,R14,R32 | R_0603_1608Metric | 5 | 100R | MCT06030D1000BP500
8 | R31,R15,R41,R30,R5,R2,R36,R44,R34,R18,R47 | R_0603_1608Metric | 11 | 100k | MCT06030D1003BP500
9 | R38,R9,R26,R46,R12,R28 | R_0603_1608Metric | 6 | 10k | MCT06030D1002BP500
10 | R22,R23 | R_0603_1608Metric | 2 | 4k7 | 594-MCT06030D4701BP5
16 | R33,R40 | R_0603_1608Metric | 2 | 190R |  | Ide 190 jó lesz, mert 11 mA nál már szaturál lényegében
23 | R8 | R_0603_1608Metric | 1 | 27k | 594-MCT06030D2702BP5 | 75V-os
31 | R17 | R_0603_1608Metric | 1 | 150R | 594-MCT06030D1500BP5
41 | R13 | R_0603_1608Metric | 1 | 20k |  | ide is 27k lesz, rajzon frissítve
30 | U2 | SIP3_11.6x8.5mm | 1 | P7805B-1000 | 490-P7805B-1000
43 | U1 | SIP3_11.6x8.5mm | 1 | P7803B-1000 | 490-P7803B-1000
40 | U9,U8 | SMDIP-4_W9.53mm | 2 | LTV-817S | 859-LTV-817S
13 | U4 | SO-4_4.4x4.3mm_P2.54mm | 1 | ASSR-1218 | 630-ASSR-1218-503E
27 | U10 | SOIC-8_5.3x6.2mm_P1.27mm | 1 | 24LC512 |  | Ilyenünk van
17 | Q2,Q4,Q5,Q1,Q6,Q7 | SOT-23 | 6 | BSS138 | 621-BSS138-13-F
11 | SW1 | TerminalBlock_Phoenix_MKDS-1,5-2_1x02_P5.00mm_Horizontal | 1 | EmergencyStop | 651-1734656
15 | SW4 | TerminalBlock_Phoenix_MKDS-1,5-2_1x02_P5.00mm_Horizontal | 1 | AdditionalSlot | 651-1734656
29 | SW2 | TerminalBlock_Phoenix_MKDS-1,5-2_1x02_P5.00mm_Horizontal | 1 | TiltSwitch | 651-1734656
42 | J8 | TerminalBlock_Phoenix_MKDS-1,5-2_1x02_P5.00mm_Horizontal | 1 | Conn_01x02_Socket | 651-1734656
48 | SW3 | TerminalBlock_Phoenix_MKDS-1,5-2_1x02_P5.00mm_Horizontal | 1 | DoorSwitch | 651-1734656
26 | TP286,TP1,TP285,TP290,TP289,TP284,TP287 | TestPoint_Pad_D2.0mm | 7 | TestPoint
35 | U5,U6 | TMC2209 Silentstepstick | 2 | TMC2209
20 | Q3 | TSOT-23 | 1 | SI2369DS-T1-GE3 | 78-SI2369DS-T1-GE3
22 | U7 | TSSOP-14_4.4x5mm_P0.65mm | 1 | ~ | 595-LSF0204QPWRQ1
34 | D4 | Vishay_SMPA | 1 | V8PAM103HM3H | 78-V8PAM103HM3H

Sheet: Summary
Key | Quantity | Mouser No | Desc | Note
1k_R_0603_1608Metric | 36 | MCT06030D1001BP500 | Thin Film Resistors - SMD .032W 1Kohm 0.1% 0603 25ppm
Cherry Switch Single_SW_Cherry_MX_1.00u_PCB | 17 | MX1A-E1NW | Pushbutton Switches Full Travel, Mech. KeyswitchClick Tactile Feel (Blue stem), 60cNNo LED, No DiodeFixation Pins for PCB Mounting
10k_R_0603_1608Metric | 14 | MCT06030D1002BP500 | Thin Film Resistors - SMD .032W 10Kohm 0.1% 0603 25ppm
100n_C_0603_1608Metric | 13 | GA0603Y104KXAAC31G | Multilayer Ceramic Capacitors MLCC - SMD/SMT 0.1 uF 10% 50V X7R 0603
100k_R_0603_1608Metric | 12 | MCT06030D1003BP500 | Thin Film Resistors - SMD .032W 100Kohms 0.1% 0603 25ppm
GREEN_LED_D_0603_1608Metric | 7 | 150060VS83000 | Single Colour LEDs WL-SMCW SMT 0603 Dome Bright Green Typ 300mcd 2V | 2
100R_R_0603_1608Metric | 7 | MCT06030D1000BP500 | Thin Film Resistors - SMD .032W 100ohms 0.1% 0603 25ppm
BSS138_SOT-23 | 6 | 621-BSS138-13-F
Conn_01x04_Pin_JST_PH_B4B-PH-K_1x04_P2.00mm_Vertical | 5
1n_C_0603_1608Metric | 5 | 77-VJ0603Y102JXACBC | Multilayer Ceramic Capacitors MLCC - SMD/SMT 0603 1000pF 50volts X7R 5%
22u, 35V_C_1206_3216Metric | 4 | 810-C3216X5R1V226M | Multilayer Ceramic Capacitors MLCC - SMD/SMT 1206 35V 22uF X5R 20% T: 1.6mm
SW_Push_JST_PH_B2B-PH-K_1x02_P2.00mm_Vertical | 4
4k7_R_0603_1608Metric | 3 | 594-MCT06030D4701BP5 | Thin Film Resistors - SMD .032W 4.7Kohms 0.1% 0603 25ppm
1u_C_0603_1608Metric | 3 | 963-TMK107B7105KA-T | Multilayer Ceramic Capacitors MLCC - SMD/SMT 963-MSAST168SB7105KT RPLCMT PN 25V 1uF X7R 0603 10%
C_C_0603_1608Metric_Pad1.08x0.95mm_HandSolder | 2
RED_LED_D_0603_1608Metric | 2 | 710-150060SS75003 | Single Colour LEDs WL-SMCW 320mcd 1,9V 0603 S_Red 630nm Adv
LTV-817S_SMDIP-4_W9.53mm | 2 | 859-LTV-817S
LED_D_0603_1608Metric | 2 |  |  | Ide is simán a zöld mehet
Conn_01x09_Pin_JST_PH_B9B-PH-K_1x09_P2.00mm_Vertical | 2
Conn_01x06_Pin_JST_PH_B6B-PH-K_1x06_P2.00mm_Vertical | 2
Conn_01x05_Pin_JST_PH_B5B-PH-K_1x05_P2.00mm_Vertical | 2
TMC2209_TMC2209 Silentstepstick | 2
TestPoint_PinSocket_1x01_P2.54mm_Vertical | 2
0R_R_0603_1608Metric | 2 | 71-CRCW06030000Z0EE |  | 50
Conn_01x04_Pin_PinSocket_1x04_P2.54mm_Vertical | 2
2k2_R_0603_1608Metric | 2 | 594-MCT06030D2201BP5 | Thin Film Resistors - SMD MCT 0603-25 0.1% P5 2K2
150R_R_0603_1608Metric | 2 | 594-MCT06030D1500BP5
1761681-9_PinHeader_2x13_P2.54mm_Vertical | 2
190R_R_0603_1608Metric | 2
Barrel_Jack_Switch_BarrelJack_Wuerth_694106106102_2.0x5.5mm | 1
TL431D_SOIC-8_3.9x4.9mm_P1.27mm | 1
24LC512_SOIC-8_5.3x6.2mm_P1.27mm | 1
SI2369DS-T1-GE3_TSOT-23 | 1
20k_R_0603_1608Metric | 1
SZSMF6L24CAT3G_D_SOD-123 | 1
TestPoint_PinHeader_1x01_P2.54mm_Vertical | 1
P7803B-1000_SIP3_11.6x8.5mm | 1
15k_R_0603_1608Metric_Pad0.98x0.95mm_HandSolder | 1
TiltSwitch_TerminalBlock_Phoenix_MKDS-1,5-2_1x02_P5.00mm_Horizontal | 1
V8PAM103HM3H_Vishay_SMPA | 1
~_NUCLEO-F767ZI | 1
P7805B-1000_SIP3_11.6x8.5mm | 1
27k_R_0603_1608Metric | 1
Conn_01x02_Socket_TerminalBlock_Phoenix_MKDS-1,5-2_1x02_P5.00mm_Horizontal | 1
LT1632_SOIC-8_3.9x4.9mm_P1.27mm | 1
Jumper_2_Open_PinHeader_1x02_P2.54mm_Vertical | 1
Jumper_2_Bridged_PinHeader_1x02_P2.54mm_Vertical | 1
330R_R_0603_1608Metric | 1
EmergencyStop_TerminalBlock_Phoenix_MKDS-1,5-2_1x02_P5.00mm_Horizontal | 1
DoorSwitch_TerminalBlock_Phoenix_MKDS-1,5-2_1x02_P5.00mm_Horizontal | 1
Display_NHD-2.23-12832UCB3 | 1
DB25_Socket_MountingHoles_DSUB-25_Socket_Horizontal_P2.77x2.84mm_EdgePinOffset7.70mm_Housed_MountingHolesOffset9.12mm | 1
51k_R_0603_1608Metric | 1
576-0154007.DRTL_Fuseholder_Littelfuse_Nano2_154x | 1
7k5_R_0603_1608Metric | 1
ASSR-1218_SO-4_4.4x4.3mm_P2.54mm | 1
AdditionalSlot_TerminalBlock_Phoenix_MKDS-1,5-2_1x02_P5.00mm_Horizontal | 1
~_TSSOP-14_4.4x5mm_P0.65mm | 1
