SAndras01/Masters-thesis/KiCad/Buttons/asm_mx_asm_PCB.stp

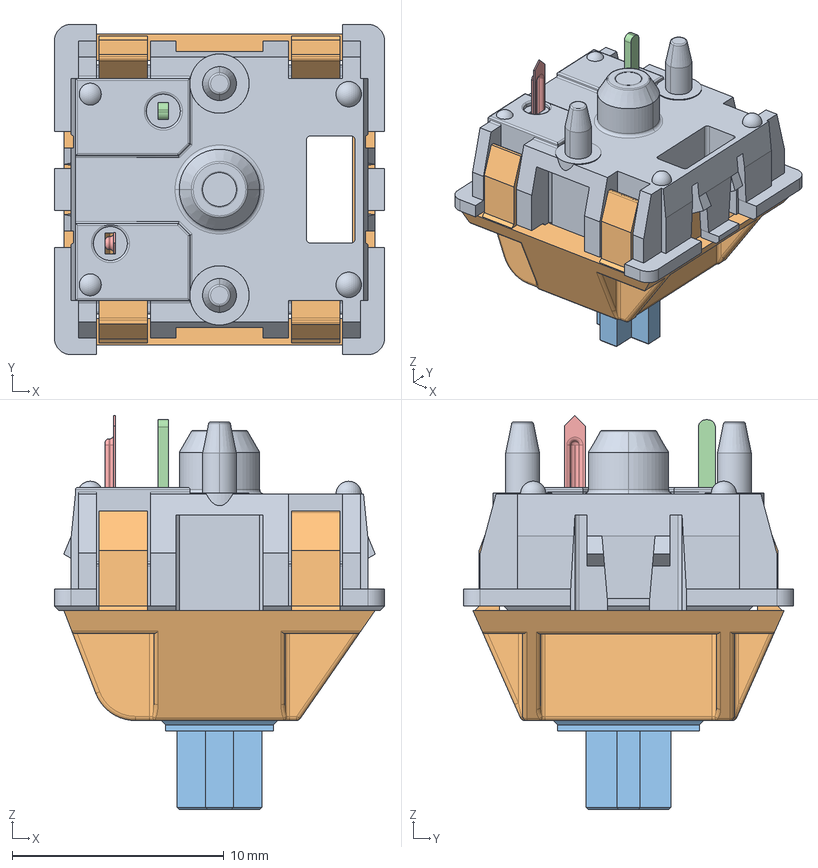
[picture p114: CAD file, 2025-10-26]
KiCad/Buttons/asm_mx_asm_PCB.stp
15.6 x 15.6 x 18.6 mm
MX_DOWN
MX_UP
UP_MX
MX_PIN
MX_SPRING
MX_CLICK
