SAndras01/Masters-thesis/KiCad/Buttons/SilentStepStick-TMC2209_v20.step

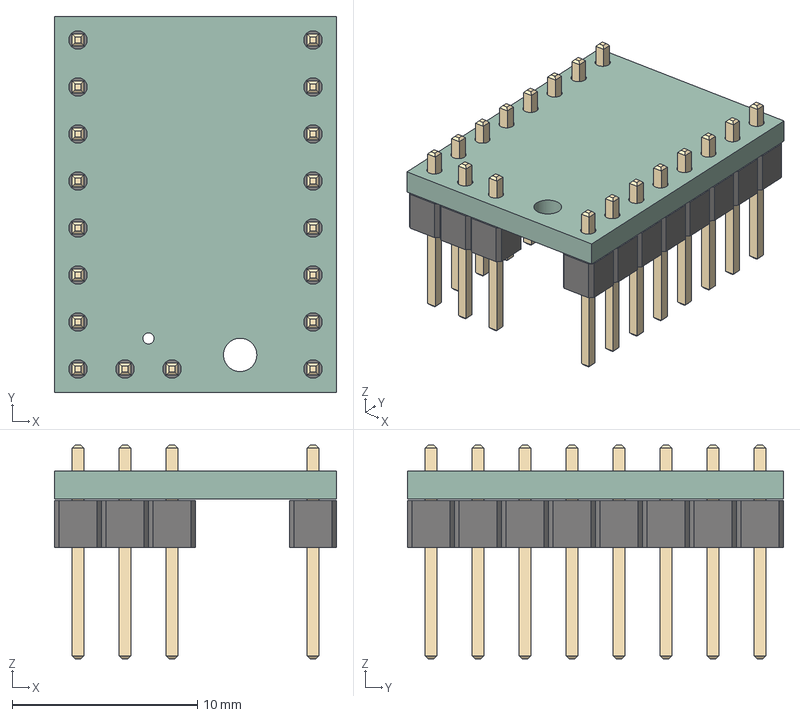
[picture p115: CAD file, 2025-10-26]
KiCad/Buttons/SilentStepStick-TMC2209_v20.step
15.2 x 20.3 x 11.5 mm
PinHeader_1x08_P2.54mm_Vertical x 2
PinHeader_1x02_P2.54mm_Vertical
SilentStepStick-TMC2209_v20_PCB
