SAndras01/Masters-thesis/KiCad/Buttons/SSW-108-01-L-S.stp

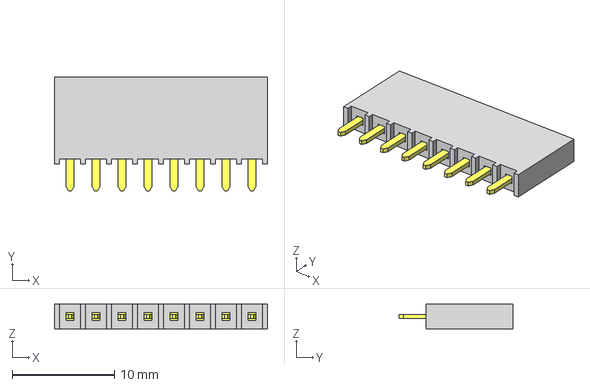
[picture p116: CAD file, 2025-10-26]
KiCad/Buttons/SSW-108-01-L-S.stp
20.8 x 11.2 x 2.41 mm
T1SSW-108-01-L-S
P2SSW-108-01-L-S
