SAndras01/Masters-thesis/KiCad/Buttons/Samtec_SSW-135-01-L-D.stp

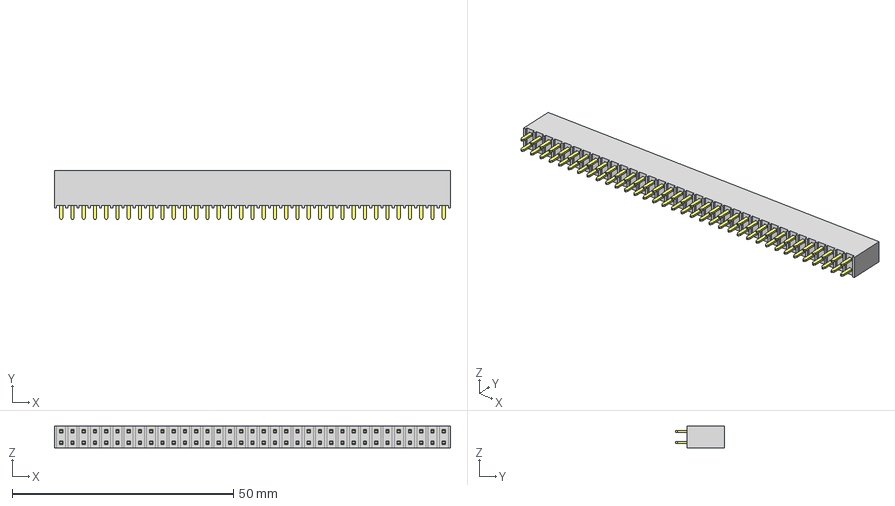
[picture p117: CAD file, 2025-10-26]
KiCad/Buttons/Samtec_SSW-135-01-L-D.stp
89.4 x 11.2 x 4.95 mm
T1SSW-135-01-L-D
P2SSW-135-01-L-D
