SAndras01/Masters-thesis/KiCad/Buttons/TSW-120-06-T-S.stp

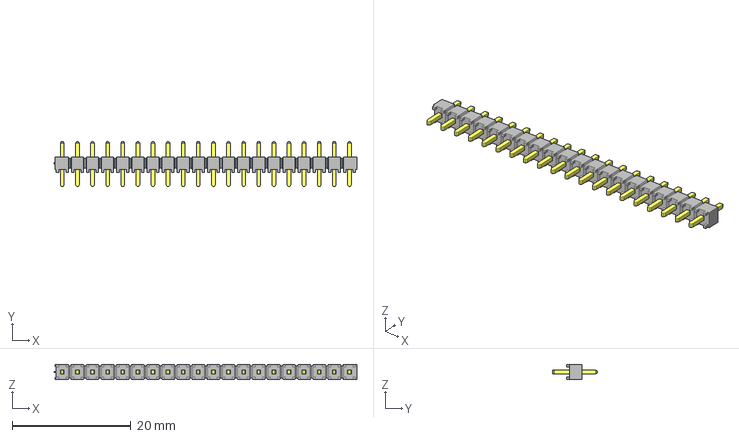
[picture p118: CAD file, 2025-10-26]
KiCad/Buttons/TSW-120-06-T-S.stp
50.9 x 7.62 x 2.54 mm
TSW-120-06-T-S_body
T-1S6-18-TSW-1-06-20-S
