SAndras01/Masters-thesis/KiCad/Buttons/Samtec_TSW-135-07-L-D.stp

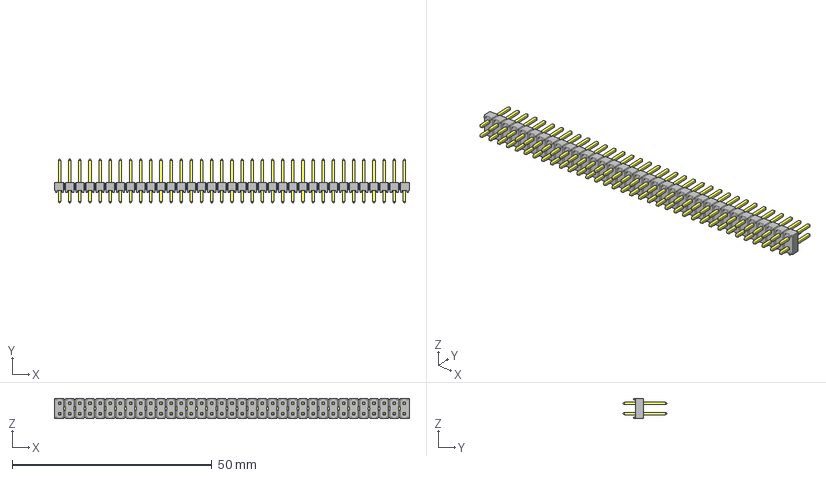
[picture p119: CAD file, 2025-10-26]
KiCad/Buttons/Samtec_TSW-135-07-L-D.stp
88.9 x 10.9 x 5.08 mm
TSW-135-07-L-D_body
T-1S6-07-TSW-1-07-35-D
