SAndras01/Masters-thesis/KiCad/Buttons/NHD-2.23-12832U.STEP

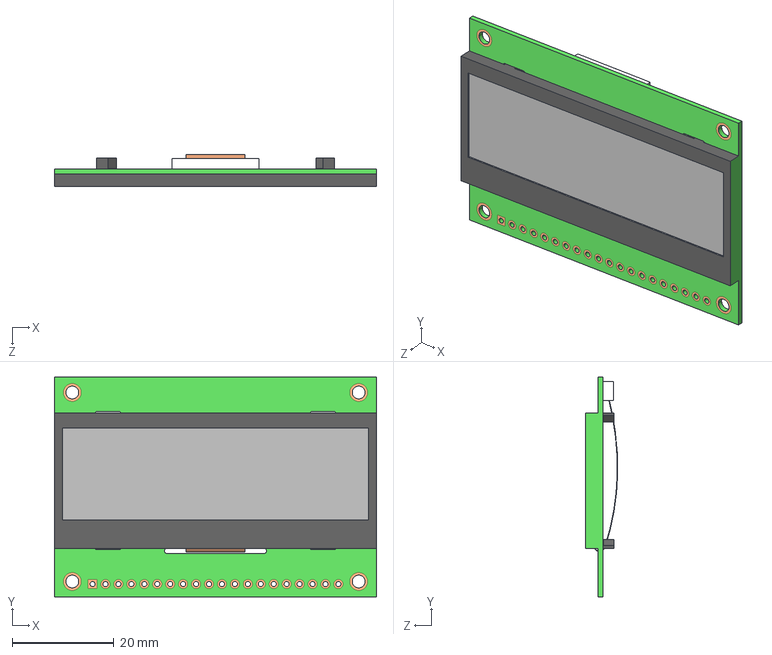
[picture p120: CAD file, 2025-10-26]
KiCad/Buttons/NHD-2.23-12832U.STEP
63.2 x 43.1 x 6.37 mm
