SAndras01/Masters-thesis/KiCad/Buttons/SM04B-SRSS-TB.STEP

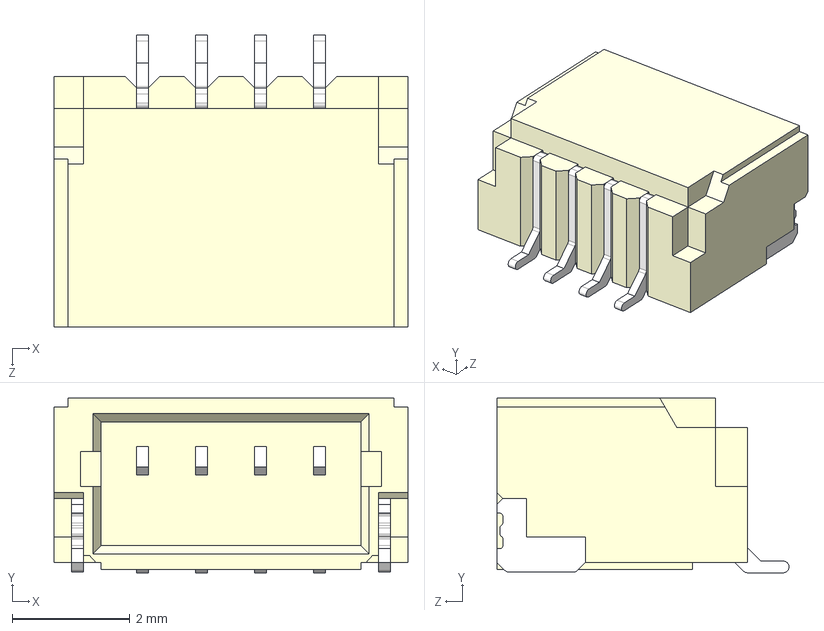
[picture p121: CAD file, 2025-10-26]
KiCad/Buttons/SM04B-SRSS-TB.STEP
6.00 x 2.96 x 4.95 mm
