SAndras01/Masters-thesis/KiCad/Buttons/PHF-120-01-L-S.stp

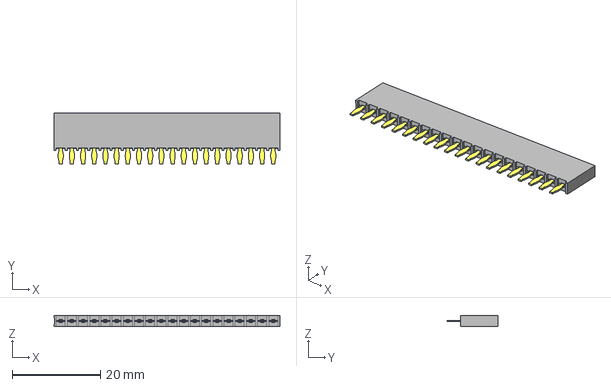
[picture p122: CAD file, 2025-10-26]
KiCad/Buttons/PHF-120-01-L-S.stp
51.3 x 11.6 x 2.41 mm
PHF120-01-L-S_terminal
PHF120-01-L-S_pins
