SAndras01/Masters-thesis/KiCad/Buttons/CES-106-01-T-S.stp

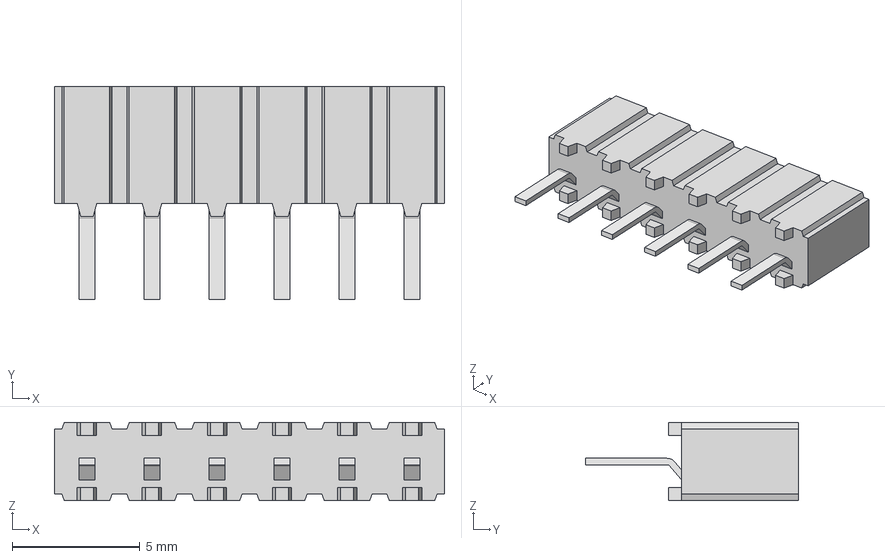
[picture p123: CAD file, 2025-10-26]
KiCad/Buttons/CES-106-01-T-S.stp
15.2 x 8.33 x 3.05 mm
CES-106-01-S_socket
010601TS
010601TS2
