SAndras01/Masters-thesis/KiCad/Buttons/TSW-108-07-L-S.stp

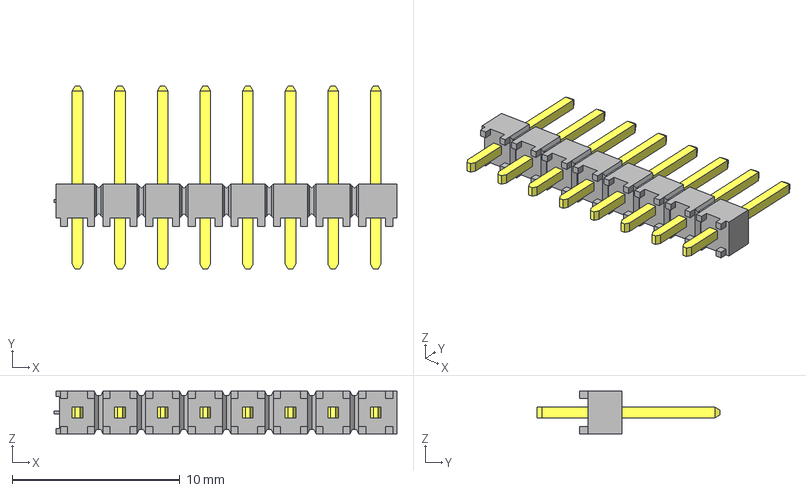
[picture p124: CAD file, 2025-10-26]
KiCad/Buttons/TSW-108-07-L-S.stp
20.4 x 10.9 x 2.54 mm
TSW-108-07-L-S_body
T-1S6-07-TSW-1-07-8-S
