SAndras01/Masters-thesis/KiCad/Buttons/Adafruit ICM20948.step

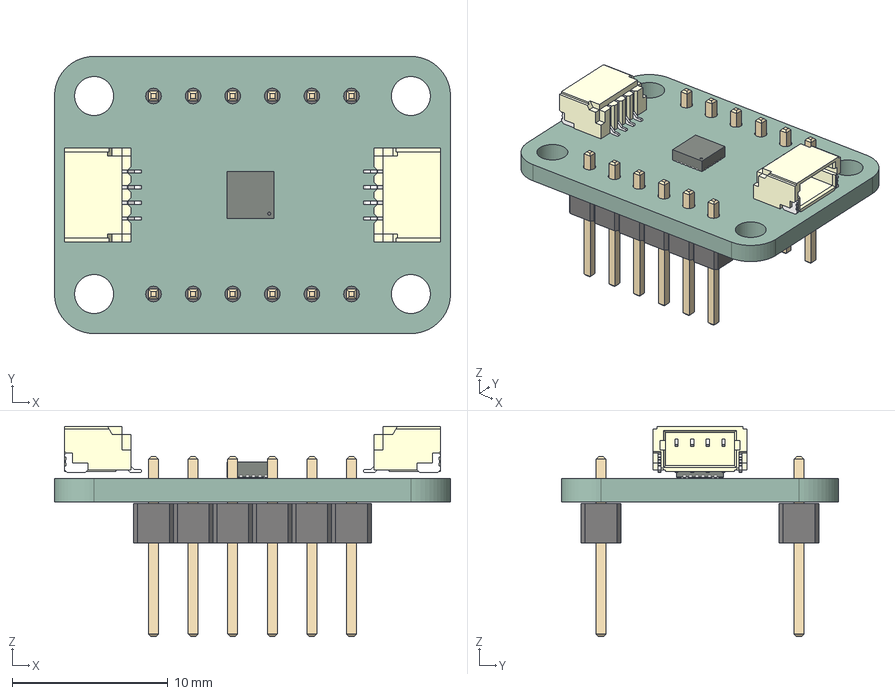
[picture p125: CAD file, 2025-10-26]
KiCad/Buttons/Adafruit ICM20948.step
25.4 x 17.8 x 13.5 mm
SM04B-SRSS-TB x 2
ICM20948
PinHeader_1x06_P2.54mm_Vertical x 2
Adafruit ICM20948_PCB
