SAndras01/Masters-thesis/KiCad/Buttons/ICM20948.step

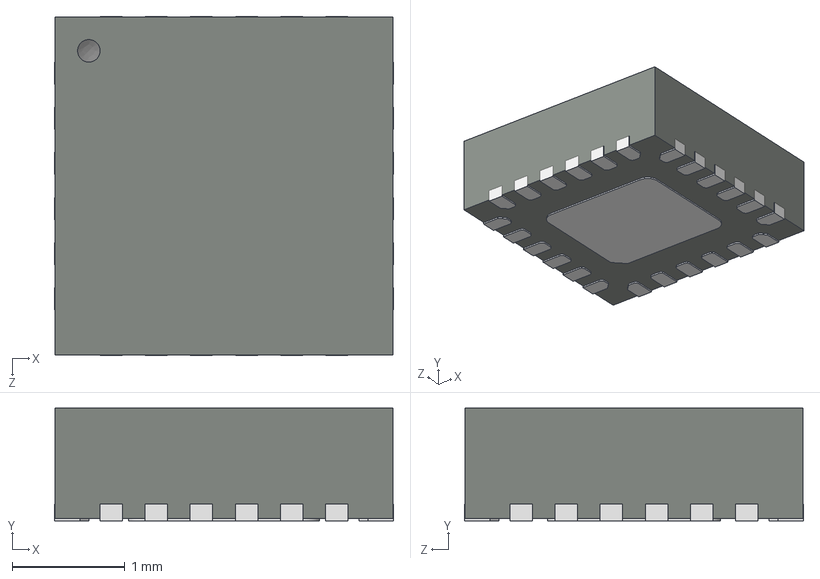
[picture p126: CAD file, 2025-10-26]
KiCad/Buttons/ICM20948.step
3.01 x 1.00 x 3.01 mm
