SAndras01/Masters-thesis/KiCad/Buttons/694106106102 (rev1).stp

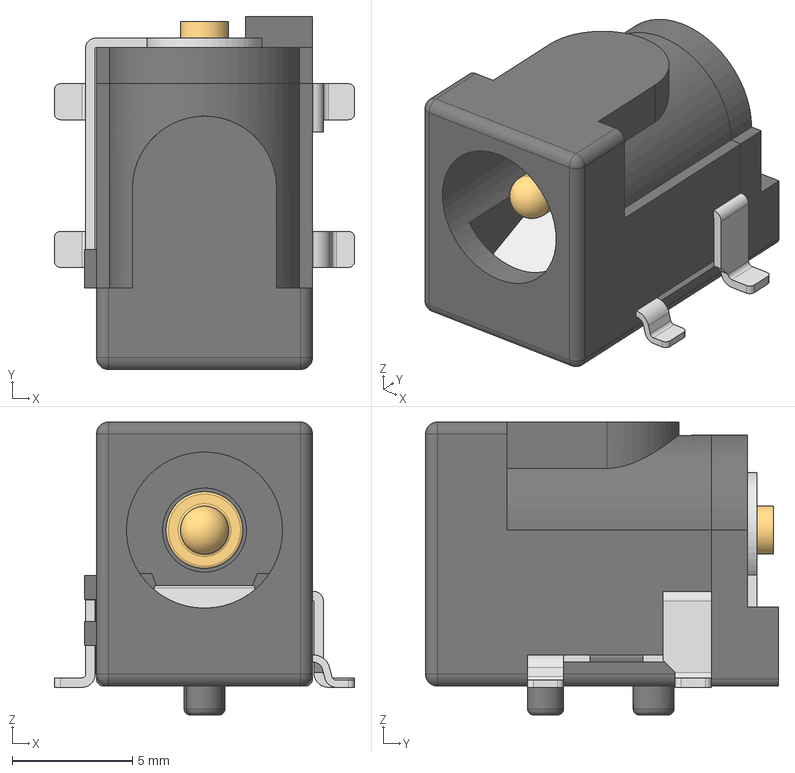
[picture p127: CAD file, 2025-10-26]
KiCad/Buttons/694106106102 (rev1).stp
12.5 x 14.7 x 12.2 mm
6941xx106102
6941xx106102_Capot
694106301002_PinContact
6941xx106102_PIN
6941xx106102_PINBIS
6941xx106102_PINLAME
