SAndras01/Masters-thesis/Dokumentáció/buttons.pdf

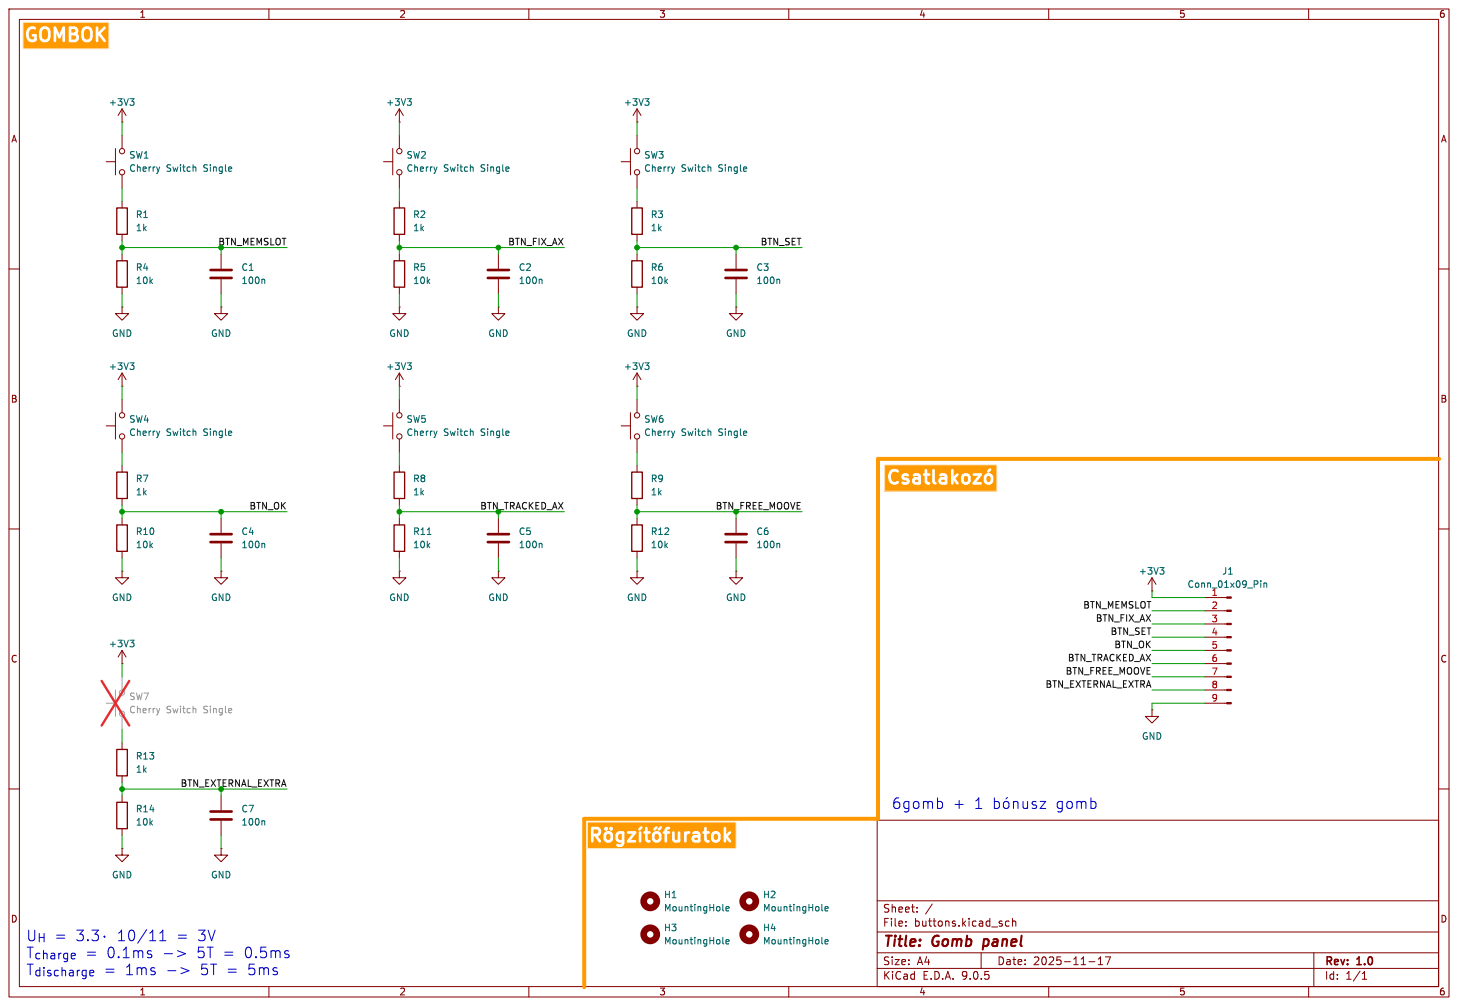
[picture p128: page 1]

Id: 1/1 Title: Gomb panel File: buttons.kicad_sch Sheet: /
