SAndras01/Masters-thesis/Dokumentáció/display.pdf

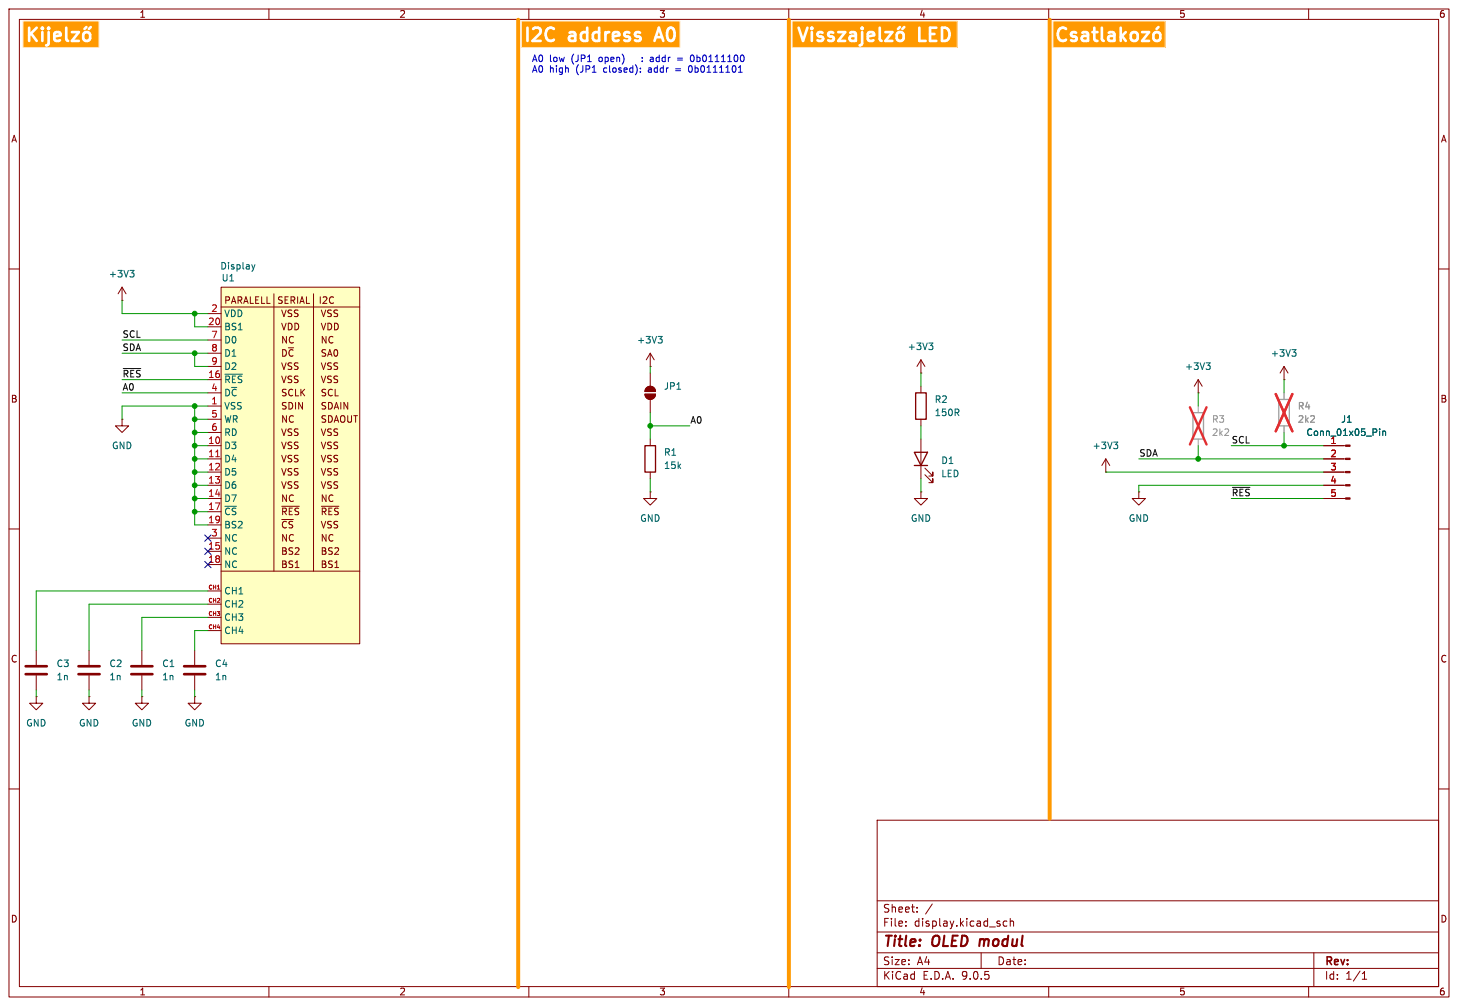
[picture p129: page 1]

Id: 1/1 Title: OLED modul File: display.kicad_sch Sheet: /
