SAndras01/Masters-thesis/LTspice/Numpad.pdf

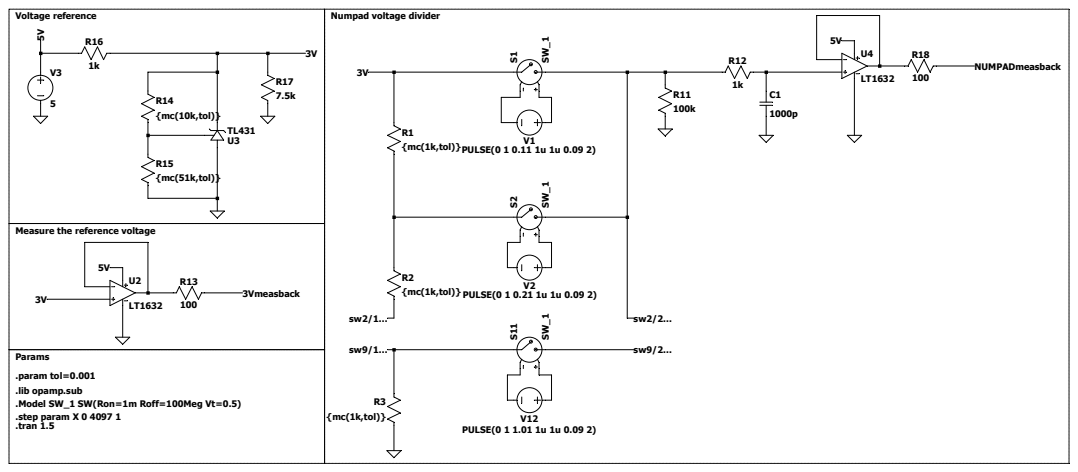
[picture p130: page 1]

Measure the reference voltage

Params
.param tol=0.001
.lib opamp.sub
.Model SW_1 SW(Ron=1m Roff=100Meg Vt=0.5)
.step param X 0 4097 1
.tran 1.5
