SAndras01/Masters-thesis/KiCad/motherboard/kapcsolás.pdf

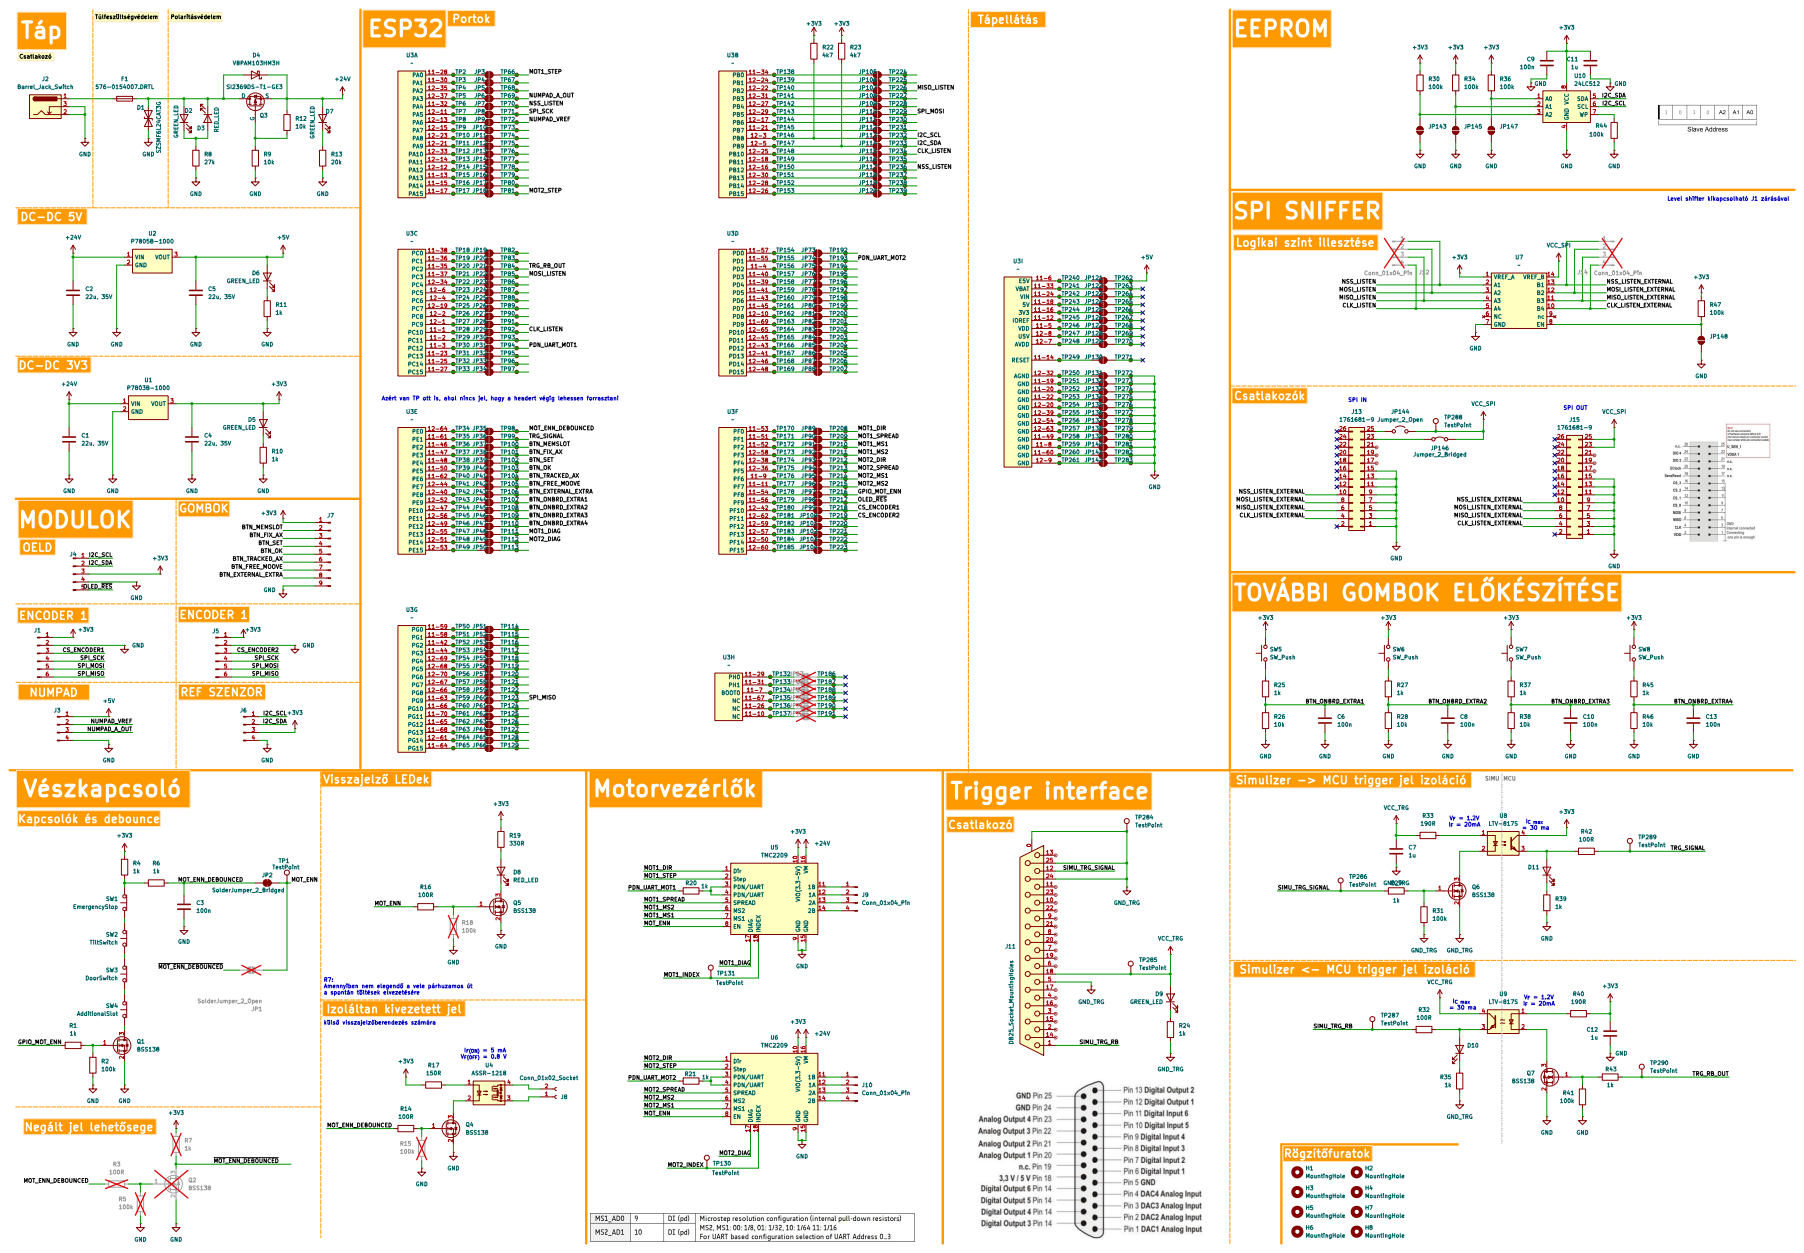
[picture p132: page 1]
