SAndras01/Masters-thesis/LTspice/Numpad.asc

C1: cap; 1n
R1: res; {mc(1k,tol)}
R2: res; {mc(1k,tol)}
R3: res; {mc(1k,tol)}
R4: res; {mc(1k,tol)}
R5: res; {mc(1k,tol)}
R6: res; {mc(1k,tol)}
R7: res; {mc(1k,tol)}
R8: res; {mc(1k,tol)}
R9: res; {mc(1k,tol)}
R10: res; {mc(1k,tol)}
R11: res; 100k
R12: res; 1k
R13: res; 100
R14: res; 10k
R15: res; 51k
R16: res; 1k
R17: res; 7.5k
R18: res; 100
S1: sw; SW_1
S2: sw; SW_1
S3: sw; SW_1
S4: sw; SW_1
S6: sw; SW_1
S7: sw; SW_1
S8: sw; SW_1
S9: sw; SW_1
S10: sw; SW_1
S11: sw; SW_1
U2: LT1632
U3: TL431
U4: LT1632
V1: voltage; PULSE(0 1 0.11 1u 1u 0.09 2)
V2: voltage; PULSE(0 1 0.21 1u 1u 0.09 2)
V3: voltage; 5
V4: voltage; PULSE(0 1 0.31 1u 1u 0.09 2)
V5: voltage; PULSE(0 1 0.41 1u 1u 0.09 2)
V7: voltage; PULSE(0 1 0.51 1u 1u 0.09 2)
V8: voltage; PULSE(0 1 0.61 1u 1u 0.09 2)
V9: voltage; PULSE(0 1 0.71 1u 1u 0.09 2)
V10: voltage; PULSE(0 1 0.81 1u 1u 0.09 2)
V11: voltage; PULSE(0 1 0.91 1u 1u 0.09 2)
V12: voltage; PULSE(0 1 1.01 1u 1u 0.09 2)
Named nets: 0, 3V, 5V, 3Vmeasback, NUMPADmeasback
.step param X 0 1 1
.Model SW_1 SW(Ron=1m Roff=100Meg Vt=0.5)
.lib opamp.sub
.param tol=0.001
.tran 1.5
