SAndras01/Masters-thesis/LTspice/Debounce.asc

C1: cap; 100n
C3: cap; 100n
C4: cap; 100n
M1: nmos; BSS145
M2: nmos; BSS145
R1: res; 1k
R2: res; 1k
R3: res; 1k
R4: res; 100
R5: res; 1k
R6: res; 1k
R7: res; 1k
R8: res; 100k
R9: res; 1k
R10: res; 100k
R11: res; 100
S1: sw; SW_1
S3: sw; SW_1
V1: voltage; 3.3V
V2: voltage; PULSE(0 3.3 0 1u 1u 0.001 0.002 4)
V3: voltage; PULSE(0 3.3 9ms 1u 1u 1 2 4)
Named nets: 3V3, 0, TIMING, BOUNCE
.tran 30ms
.Model SW_1 SW(Ron=1m Roff=100Meg Vt=0.5)
