SAndras01/Masters-thesis/KiCad/buttons/buttons.kicad_pcb

## KiCad design KiCad/buttons/buttons.kicad_pcb (2025-11-19)

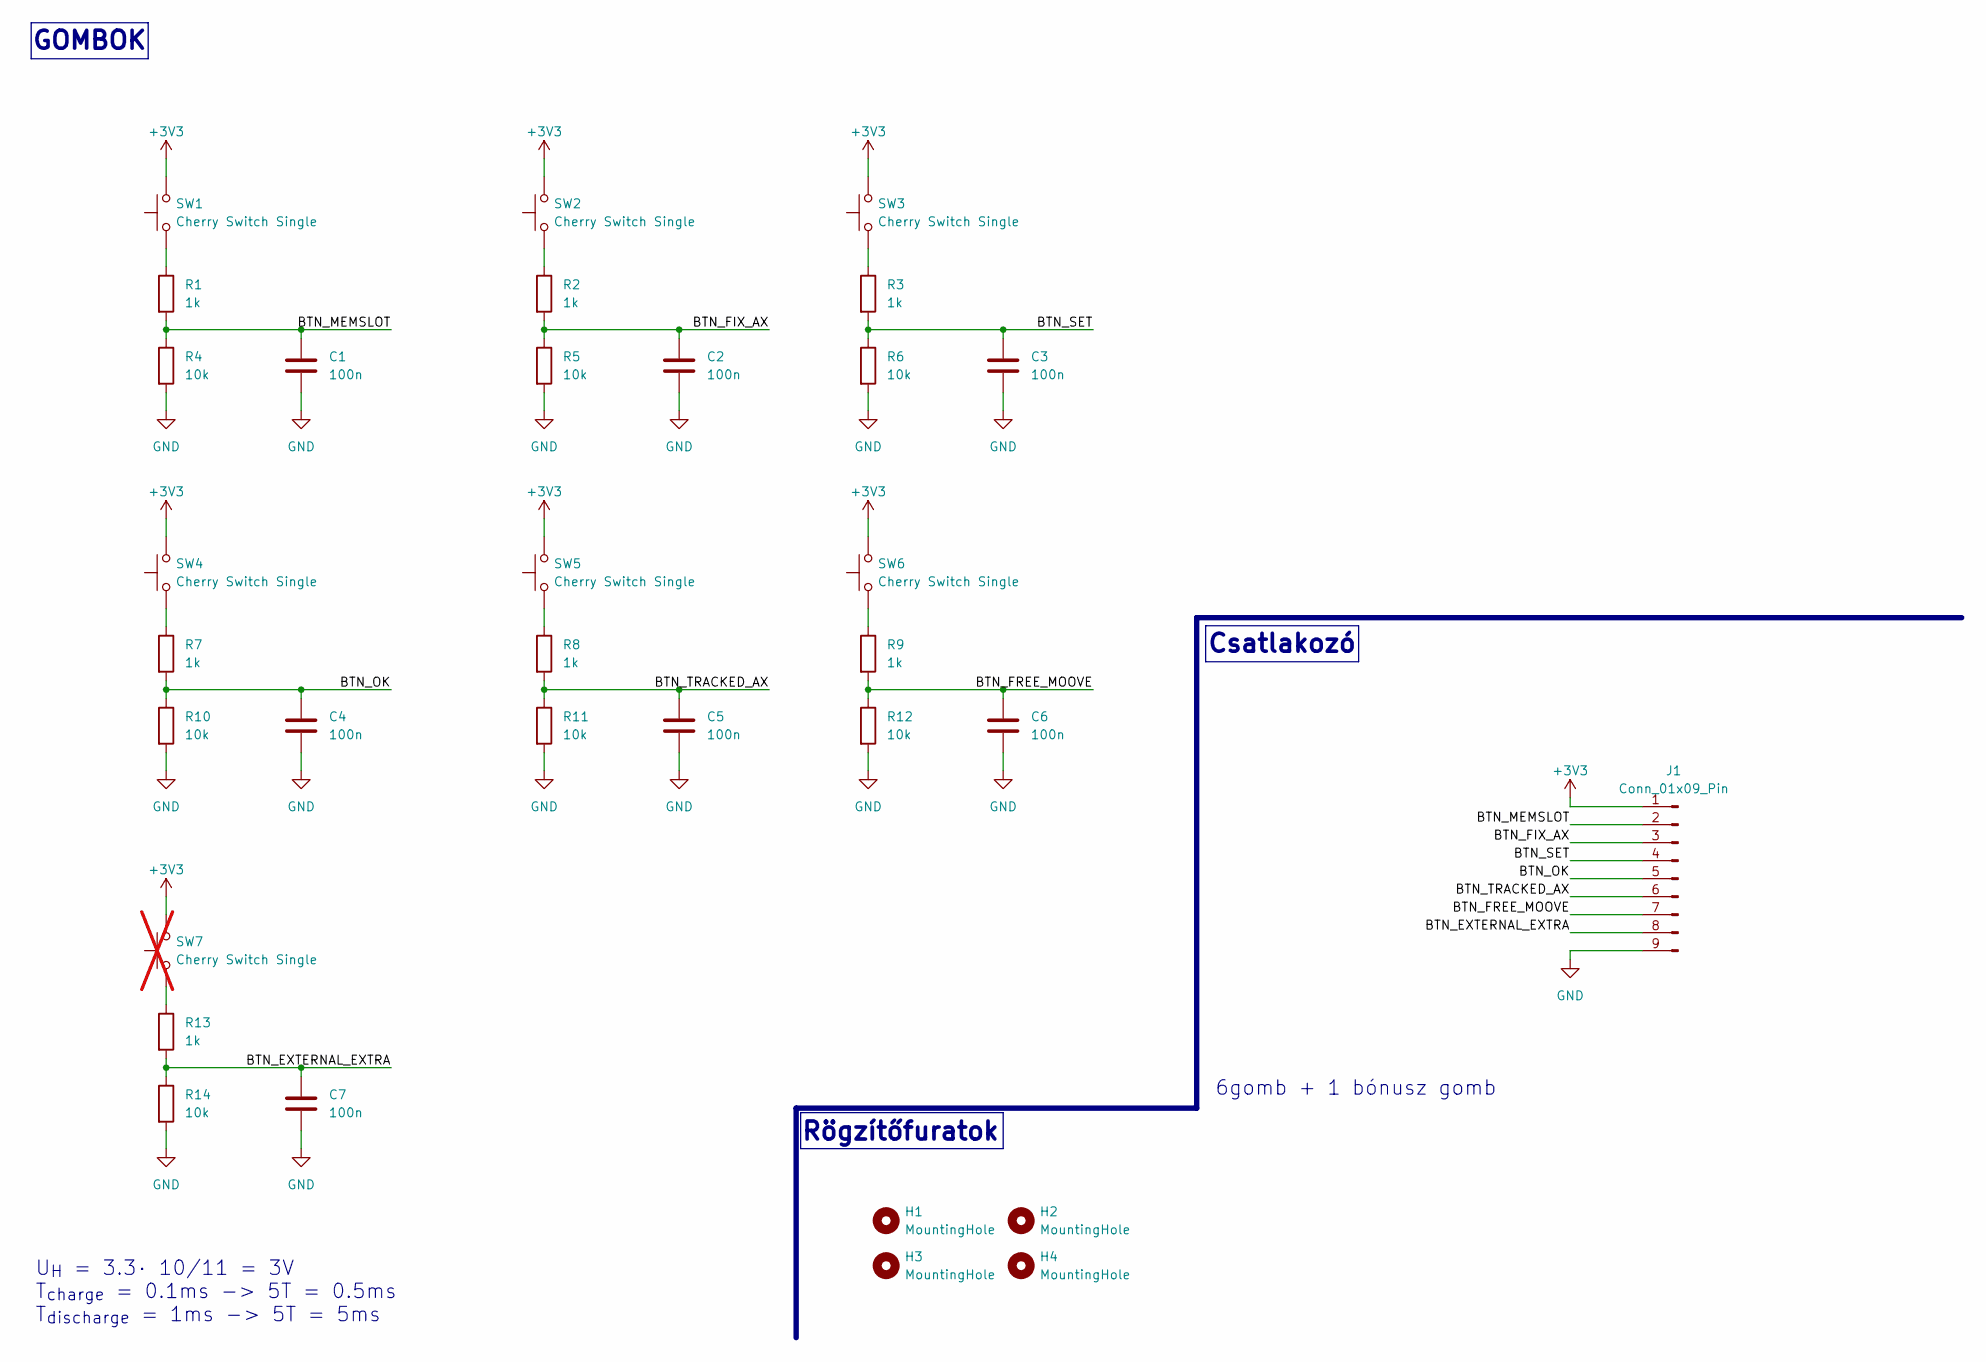
[picture p133: schematic buttons.kicad_sch]

Parts:
C1, C2, C3, C4, C5, C6, C7: 100n; C_0603_1608Metric
H1, H2, H3, H4: MountingHole; MountingHole_3.2mm_M3
J1: Conn_01x09_Pin; JST_PH_B9B-PH-K_1x09_P2.00mm_Vertical
R1, R2, R3, R7, R8, R9, R13: 1k; R_0603_1608Metric
R4, R5, R6, R10, R11, R12, R14: 10k; R_0603_1608Metric
SW1, SW2, SW3, SW4, SW5, SW6: Cherry Switch Single; SW_Cherry_MX_1.00u_PCB
SW7: Cherry Switch Single; SW_Cherry_MX_1.00u_PCB; not fitted

Connections:
+3V3: J1.1, SW1.2, SW2.2, SW3.2, SW4.2, SW5.2, SW6.2, SW7.2
/BTN_EXTERNAL_EXTRA: C7.1, J1.8, R13.2, R14.1
/BTN_FIX_AX: C2.1, J1.3, R2.2, R5.1
/BTN_FREE_MOOVE: C6.1, J1.7, R9.2, R12.1
/BTN_MEMSLOT: C1.1, J1.2, R1.2, R4.1
/BTN_OK: C4.1, J1.5, R7.2, R10.1
/BTN_SET: C3.1, J1.4, R3.2, R6.1
/BTN_TRACKED_AX: C5.1, J1.6, R8.2, R11.1
GND: C1.2, C2.2, C3.2, C4.2, C5.2, C6.2, C7.2, J1.9, R4.2, R5.2, R6.2, R10.2, R11.2, R12.2, R14.2
unnamed: R1.1, SW1.1
unnamed: R2.1, SW2.1
unnamed: R3.1, SW3.1
unnamed: R7.1, SW4.1
unnamed: R8.1, SW5.1
unnamed: R9.1, SW6.1
unnamed: R13.1, SW7.1

Notes on the sheet:
Rögzítőfuratok
U_{H} = 3.3· 10/11 = 3V T_{charge} = 0.1ms -> 5T = 0.5ms T_{discharge} = 1ms -> 5T = 5ms
6gomb + 1 bónusz gomb
Csatlakozó
GOMBOK

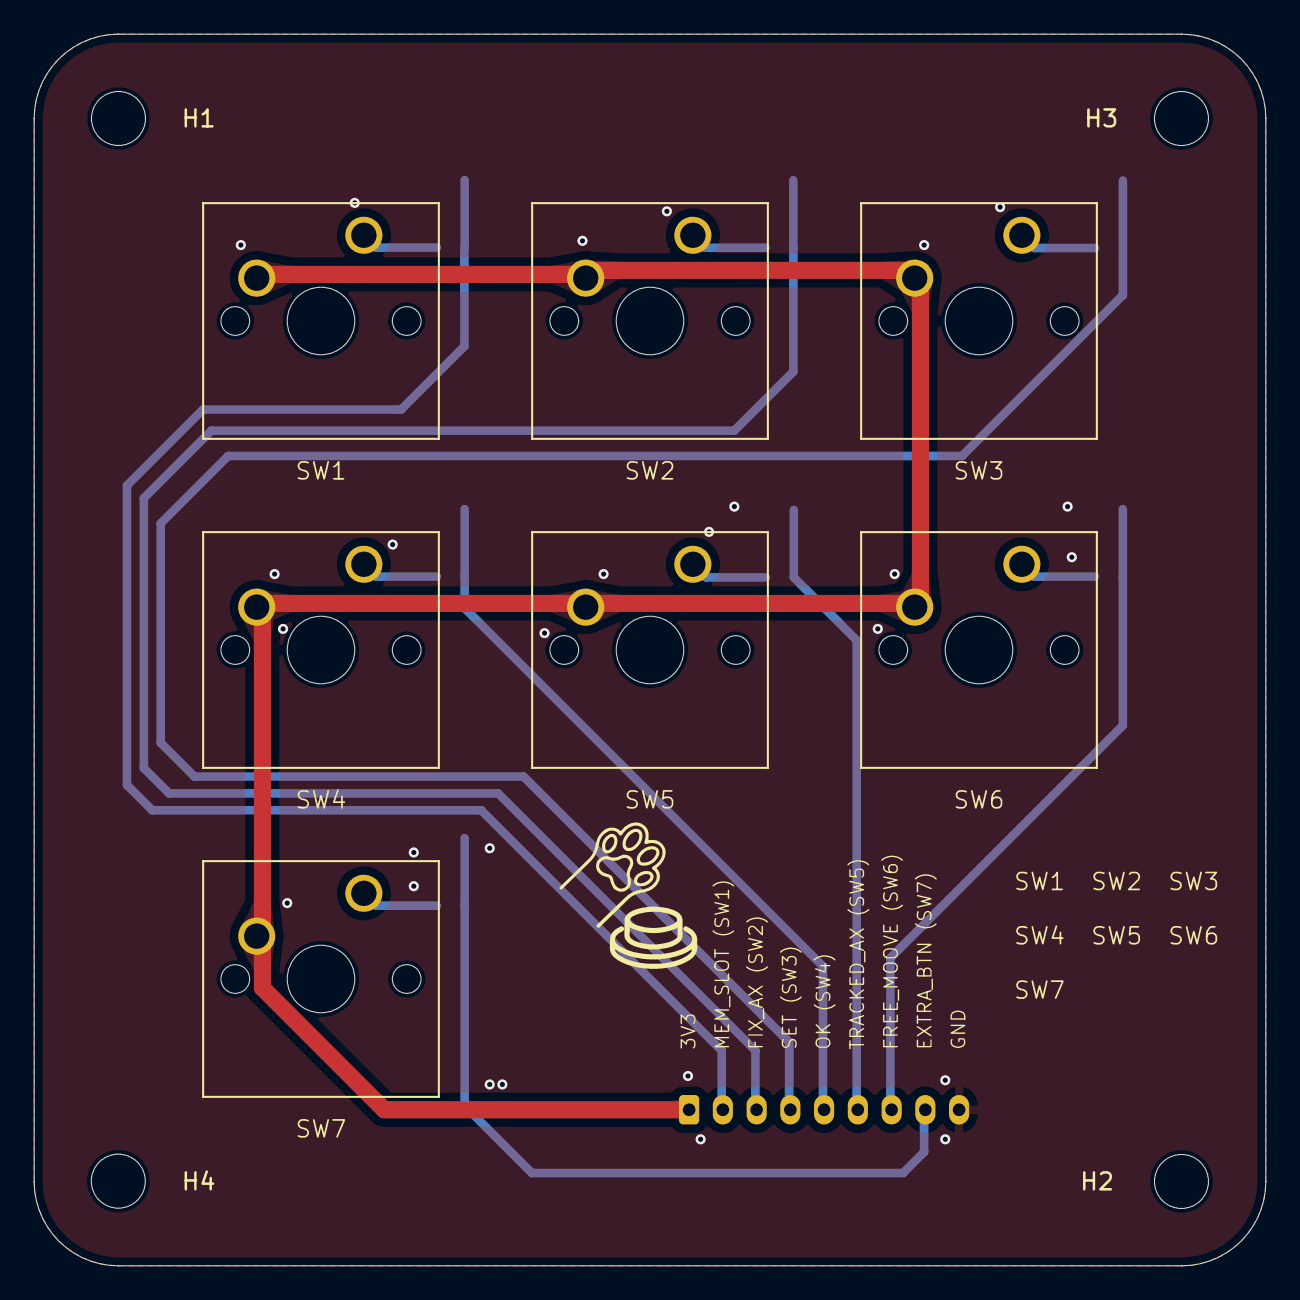
[picture p134: board buttons.kicad_pcb from above]

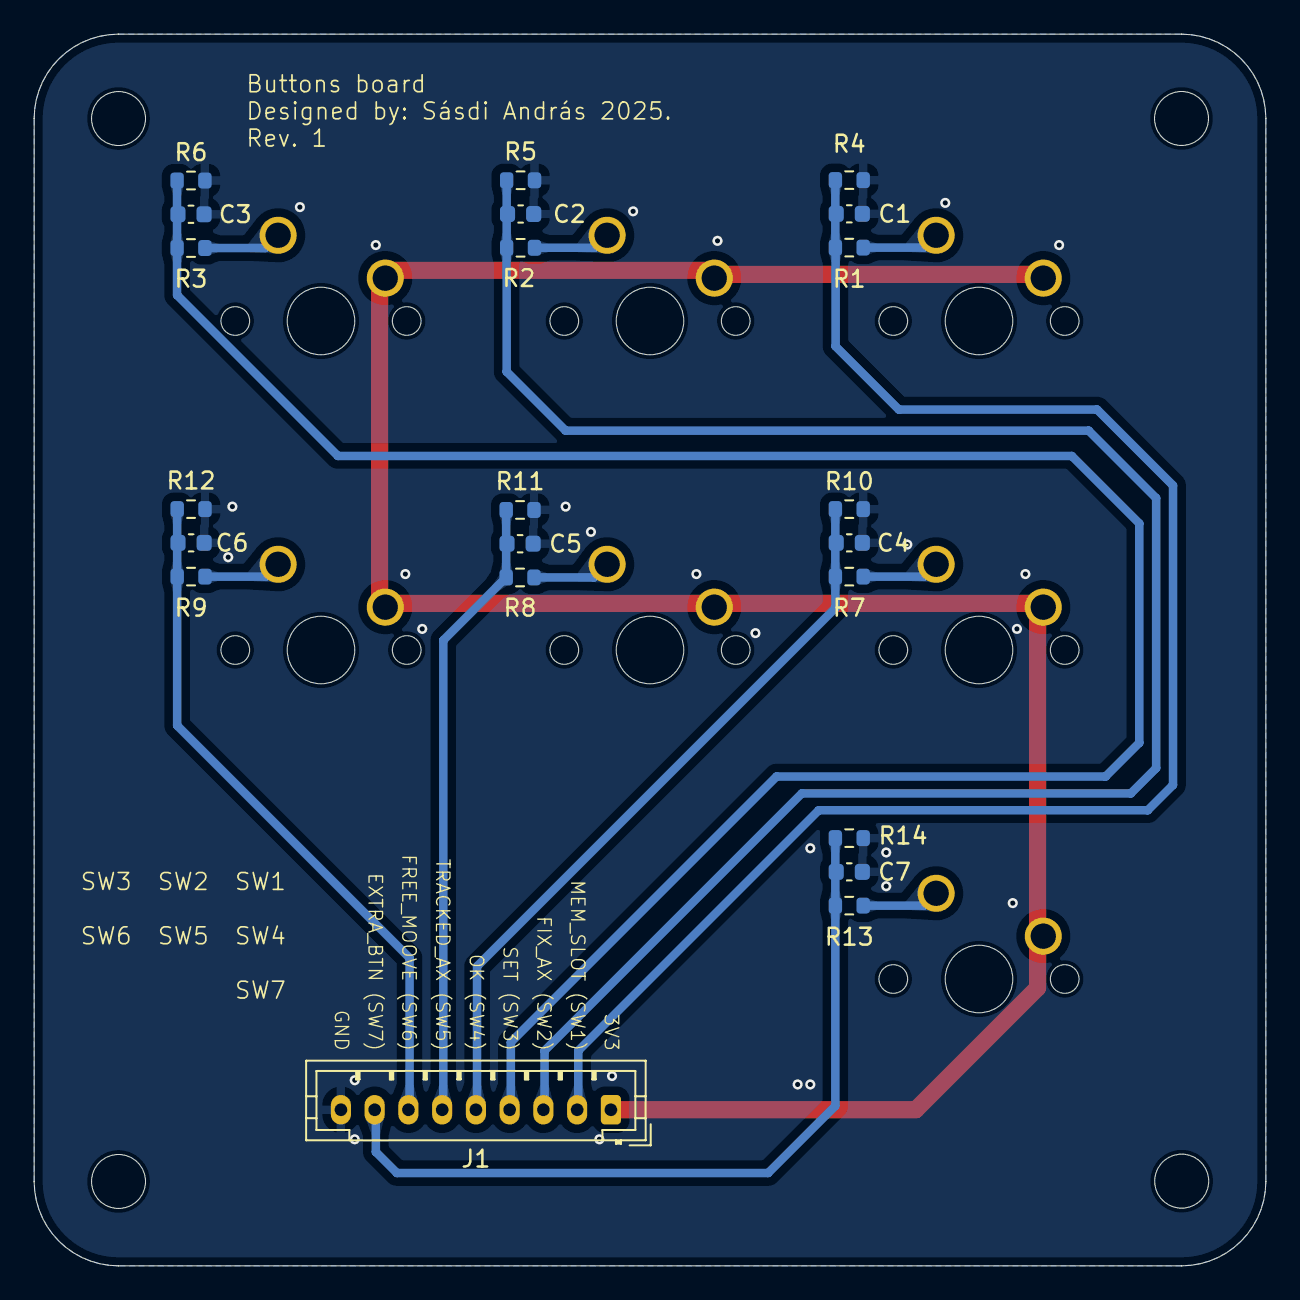
[picture p135: board buttons.kicad_pcb from below]

Board: 2 copper layers, 73.0 x 73.0 mm, 33 parts (22 on the bottom side), 16 nets.
