SAndras01/Masters-thesis/KiCad/display/display.kicad_pcb

## KiCad design KiCad/display/display.kicad_pcb (2025-11-19)

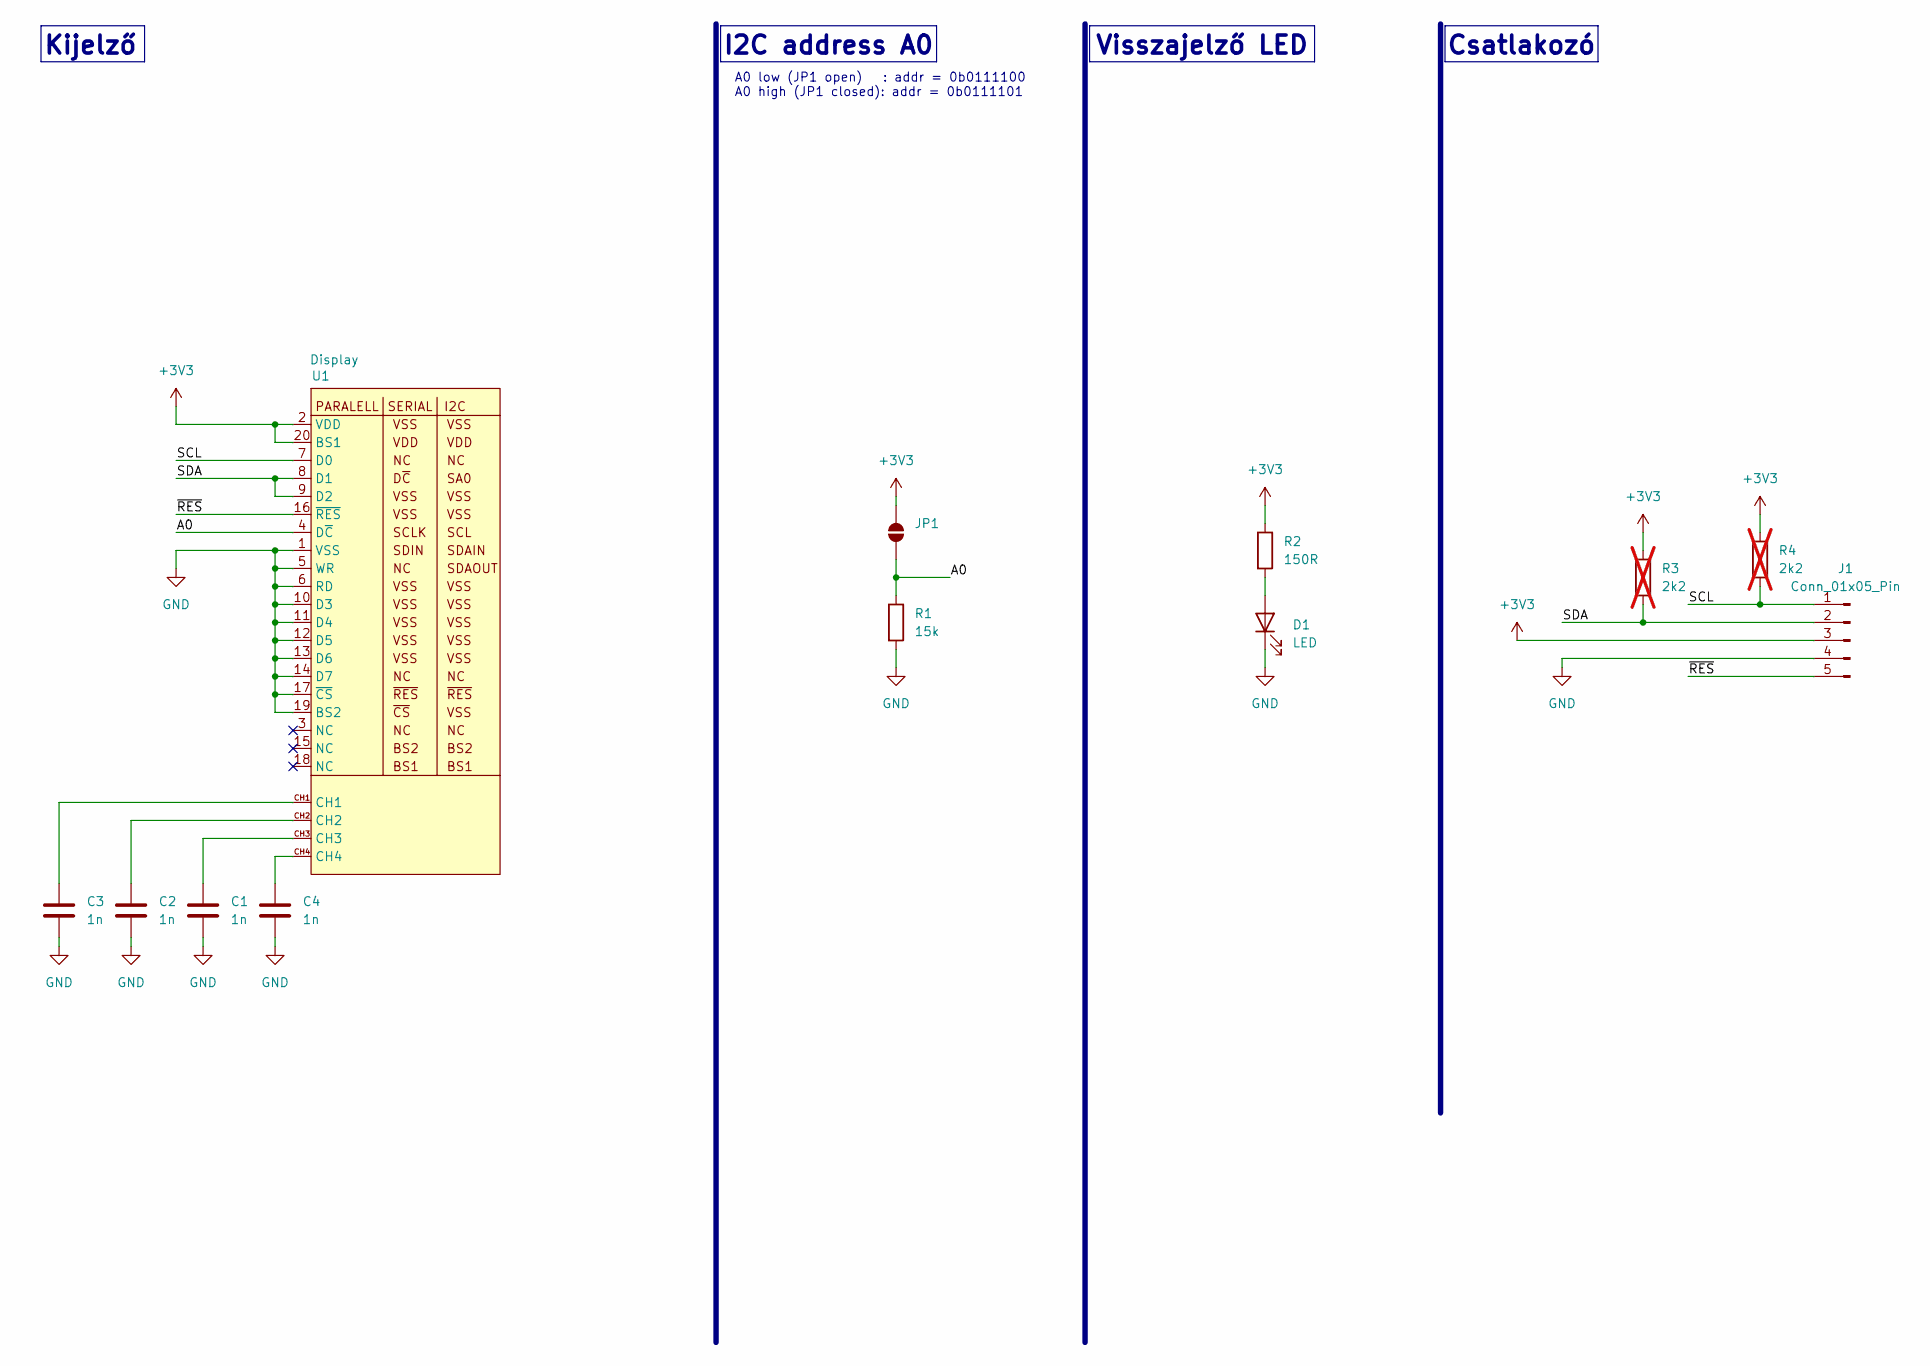
[picture p136: schematic display.kicad_sch]

Parts:
C1, C2, C3, C4: 1n; C_0603_1608Metric
D1: LED; D_0603_1608Metric
J1: Conn_01x05_Pin; JST_PH_B5B-PH-K_1x05_P2.00mm_Vertical
JP1: SolderJumper_2_Open; R_0603_1608Metric_Pad0.98x0.95mm_HandSolder
R1: 15k; R_0603_1608Metric_Pad0.98x0.95mm_HandSolder
R2: 150R; R_0603_1608Metric
R3, R4: 2k2; R_0603_1608Metric; not fitted
U1: Display; NHD-2.23-12832UCB3

Connections:
+3V3: J1.3, JP1.2 (B), R2.1, R3.1, R4.1, U1.2 (VDD), U1.20 (BS1)
/A0: JP1.1 (A), R1.1, U1.4 (D~C)
/SCL: J1.1, R4.2, U1.7 (D0)
/SDA: J1.2, R3.2, U1.8 (D1), U1.9 (D2)
/~RES: J1.5, U1.16 (~RES)
GND: C1.2, C2.2, C3.2, C4.2, D1.1 (K), J1.4, R1.2, U1.1 (VSS), U1.5 (WR), U1.6 (RD), U1.10 (D3), U1.11 (D4), U1.12 (D5), U1.13 (D6), U1.14 (D7), U1.17 (~CS), U1.19 (BS2)
unnamed: C1.1, U1.CH3
unnamed: C2.1, U1.CH2
unnamed: C3.1, U1.CH1
unnamed: C4.1, U1.CH4
unnamed: D1.2 (A), R2.2

Notes on the sheet:
A0 low (JP1 open) : addr = 0b0111100 A0 high (JP1 closed): addr = 0b0111101
Csatlakozó
Visszajelző LED
Kijelző
I2C address A0

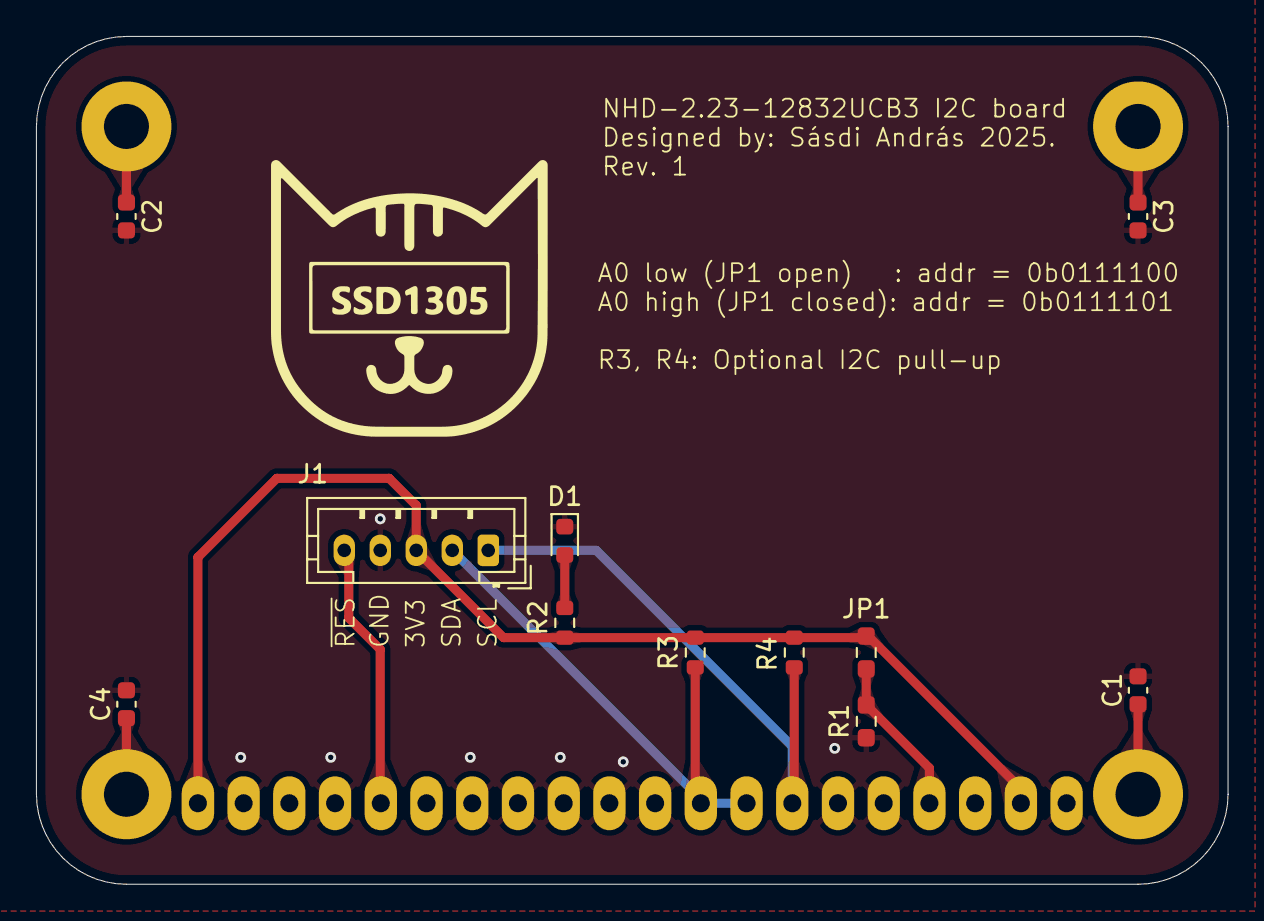
[picture p137: board display.kicad_pcb from above]

Board: 2 copper layers, 66.2 x 47.1 mm, 12 parts (1 on the bottom side), 11 nets.
