SAndras01/Masters-thesis/KiCad/numpad/numpad.kicad_pcb

## KiCad design KiCad/numpad/numpad.kicad_pcb (2025-11-19)

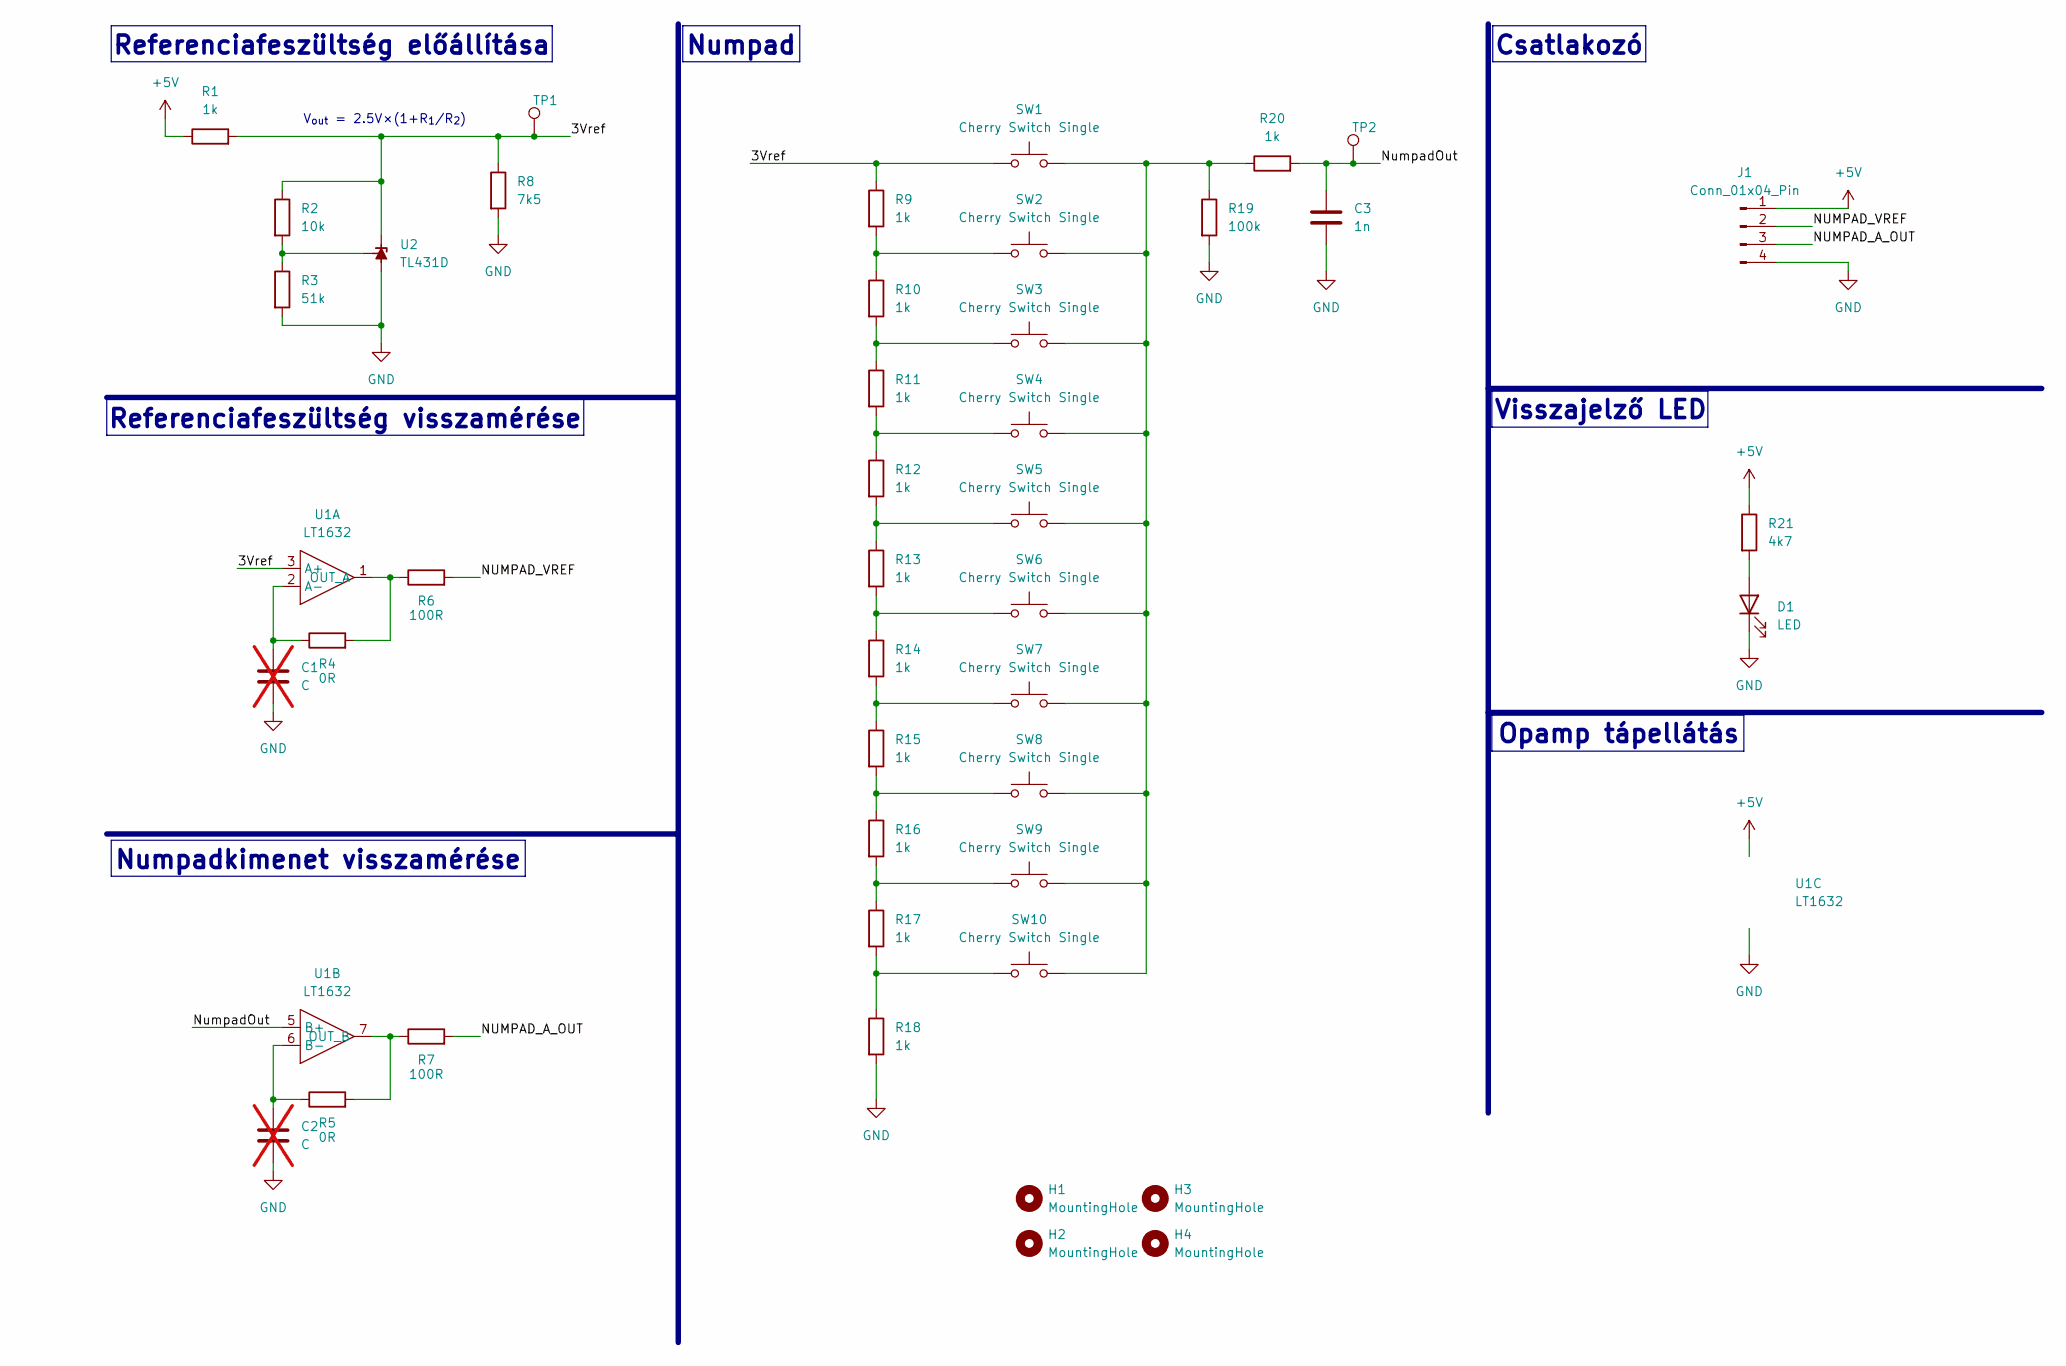
[picture p138: schematic numpad.kicad_sch]

Parts:
C1, C2: C; C_0603_1608Metric_Pad1.08x0.95mm_HandSolder; not fitted
C3: 1n; C_0603_1608Metric
D1: LED; D_0603_1608Metric
H1, H2, H3, H4: MountingHole; MountingHole_3.2mm_M3
J1: Conn_01x04_Pin; JST_PH_B4B-PH-K_1x04_P2.00mm_Vertical
R1, R9, R10, R11, R12, R13, R14, R15, R16, R17, R18, R20: 1k; R_0603_1608Metric
R2: 10k; R_0603_1608Metric
R3: 51k; R_0603_1608Metric
R4, R5: 0R; R_0603_1608Metric
R6, R7: 100R; R_0603_1608Metric
R8: 7k5; R_0603_1608Metric
R19: 100k; R_0603_1608Metric
R21: 4k7; R_0603_1608Metric
SW1, SW2, SW3, SW4, SW5, SW6, SW7, SW8, SW9, SW10: Cherry Switch Single; SW_Cherry_MX_1.00u_PCB
TP1, TP2: TestPoint; TestPoint_Pad_D2.0mm
U1: LT1632; SOIC-8_3.9x4.9mm_P1.27mm
U2: TL431D; SOIC-8_3.9x4.9mm_P1.27mm

Connections:
+5V: J1.1, R1.1, R21.1, U1.8 (V+)
/3Vref: R1.2, R2.1, R8.1, R9.1, SW1.1, TP1.1, U1.3 (A+), U2.1 (K)
/NUMPAD_A_OUT: J1.3, R7.2
/NUMPAD_VREF: J1.2, R6.2
/NumpadOut: C3.1, R20.2, TP2.1, U1.5 (B+)
GND: C1.2, C2.2, C3.2, D1.1 (K), J1.4, R3.2, R8.2, R18.2, R19.2, U1.4 (V-), U2.2 (A), U2.3 (A), U2.6 (A), U2.7 (A)
unnamed: D1.2 (A), R21.2
unnamed: R9.2, R10.1, SW2.1
unnamed: R10.2, R11.1, SW3.1
unnamed: R11.2, R12.1, SW4.1
unnamed: R12.2, R13.1, SW5.1
unnamed: R13.2, R14.1, SW6.1
unnamed: R14.2, R15.1, SW7.1
unnamed: R15.2, R16.1, SW8.1
unnamed: R16.2, R17.1, SW9.1
unnamed: R17.2, R18.1, SW10.1
unnamed: R19.1, R20.1, SW1.2, SW2.2, SW3.2, SW4.2, SW5.2, SW6.2, SW7.2, SW8.2, SW9.2, SW10.2
unnamed: C1.1, R4.1, U1.2 (A-)
unnamed: R4.2, R6.1, U1.1 (OUT_A)
unnamed: C2.1, R5.1, U1.6 (B-)
unnamed: R5.2, R7.1, U1.7 (OUT_B)
unnamed: R2.2, R3.1, U2.8 (REF)

Notes on the sheet:
Visszajelző LED
Referenciafeszültség előállítása
Referenciafeszültség visszamérése
Numpadkimenet visszamérése
Numpad
V_{out} = 2.5V×(1+R_{1}/R_{2})
Csatlakozó
Opamp tápellátás

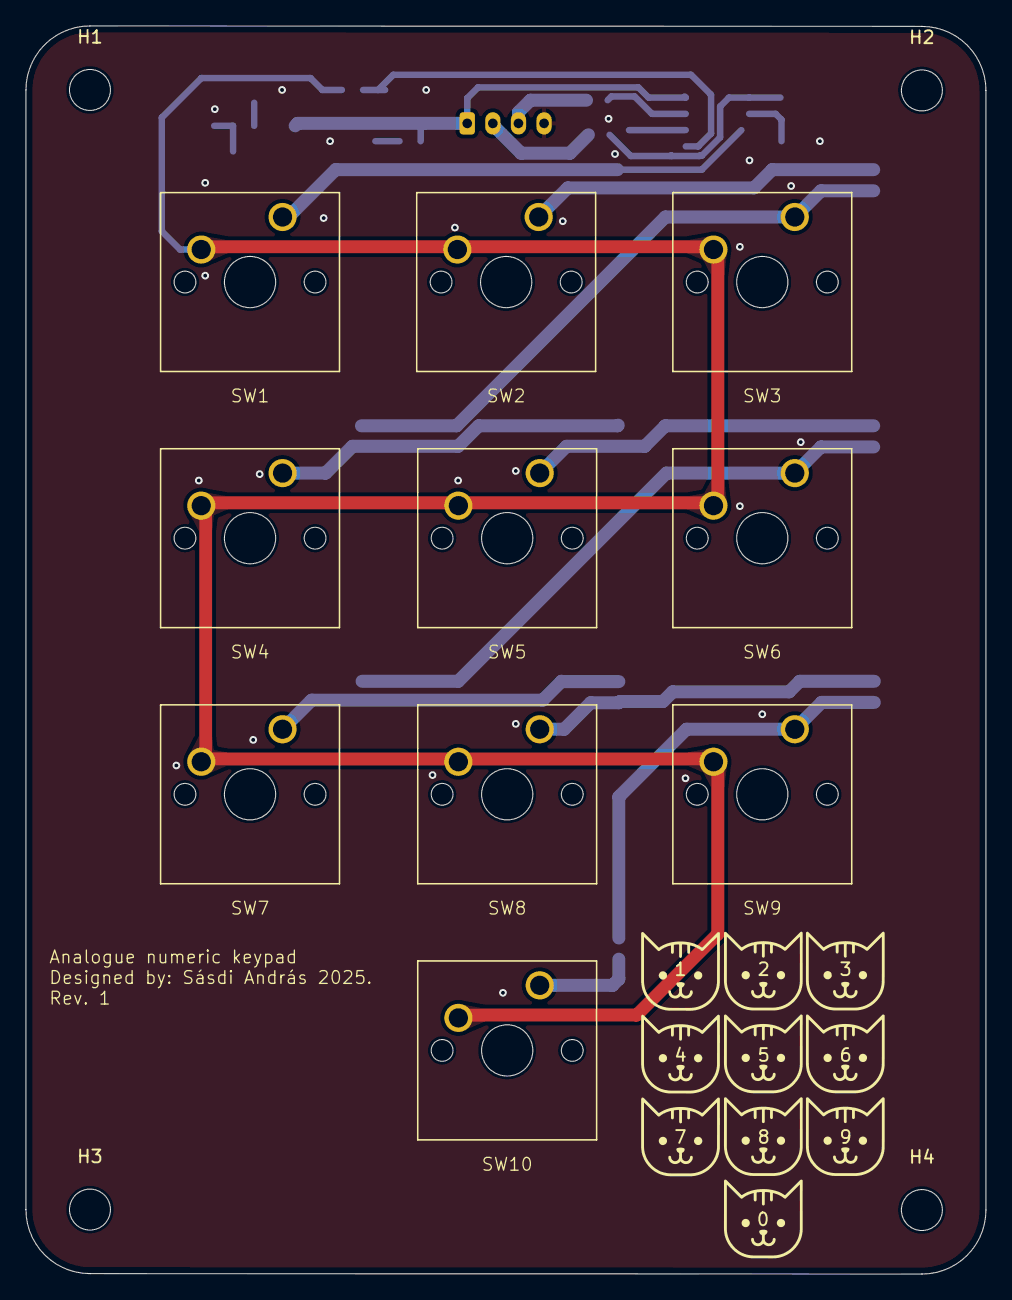
[picture p139: board numpad.kicad_pcb from above]

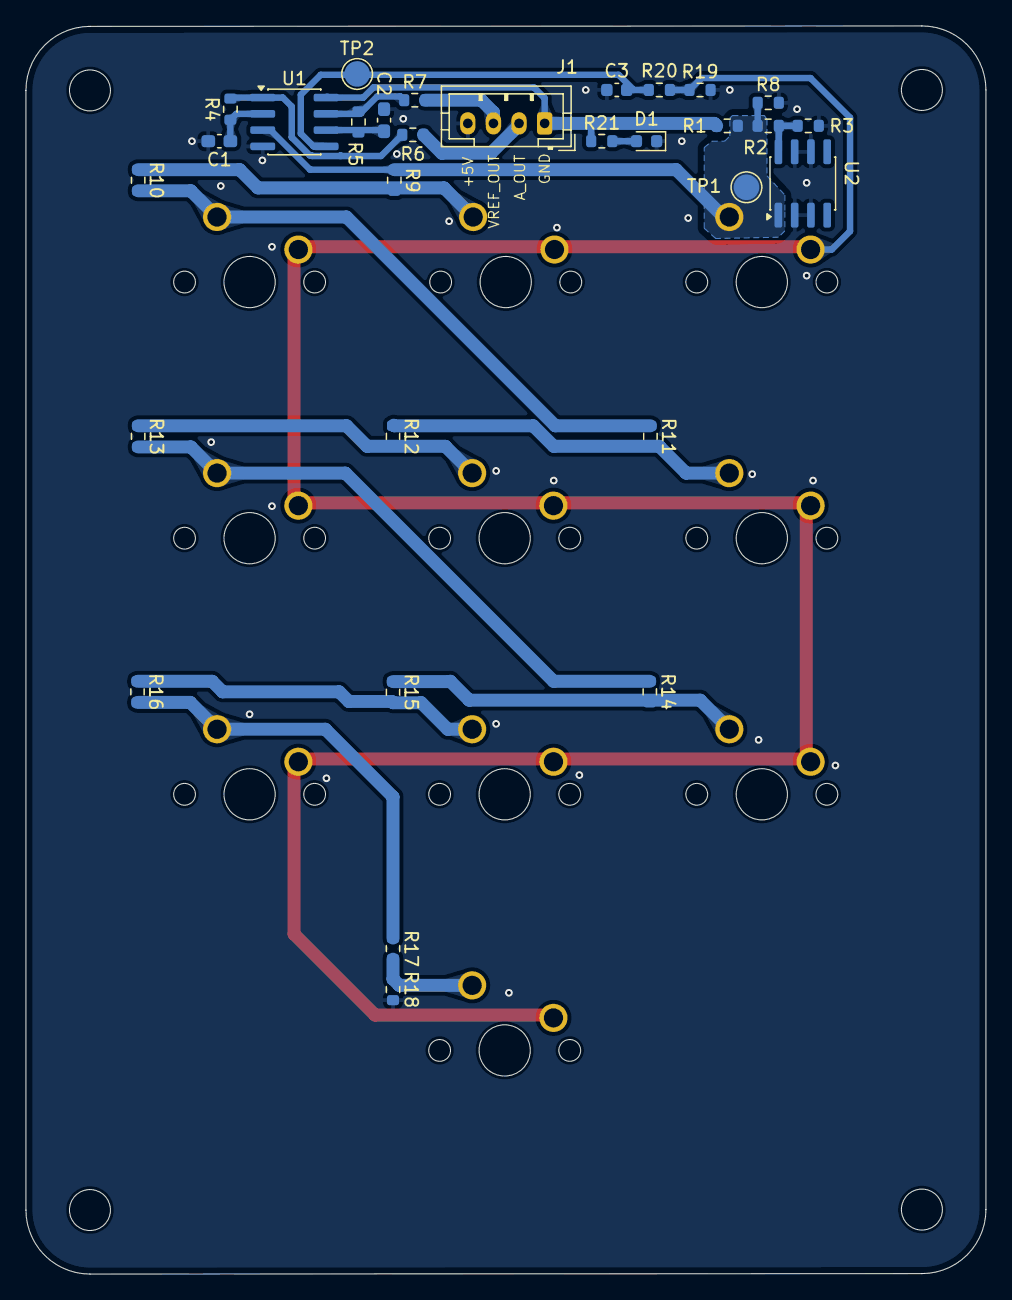
[picture p140: board numpad.kicad_pcb from below]

Board: 2 copper layers, 75.0 x 97.5 mm, 44 parts (30 on the bottom side), 22 nets.
