SAndras01/Masters-thesis/KiCad/motherboard/motherboard.kicad_pcb

## KiCad design KiCad/motherboard/motherboard.kicad_pcb (2025-11-13)

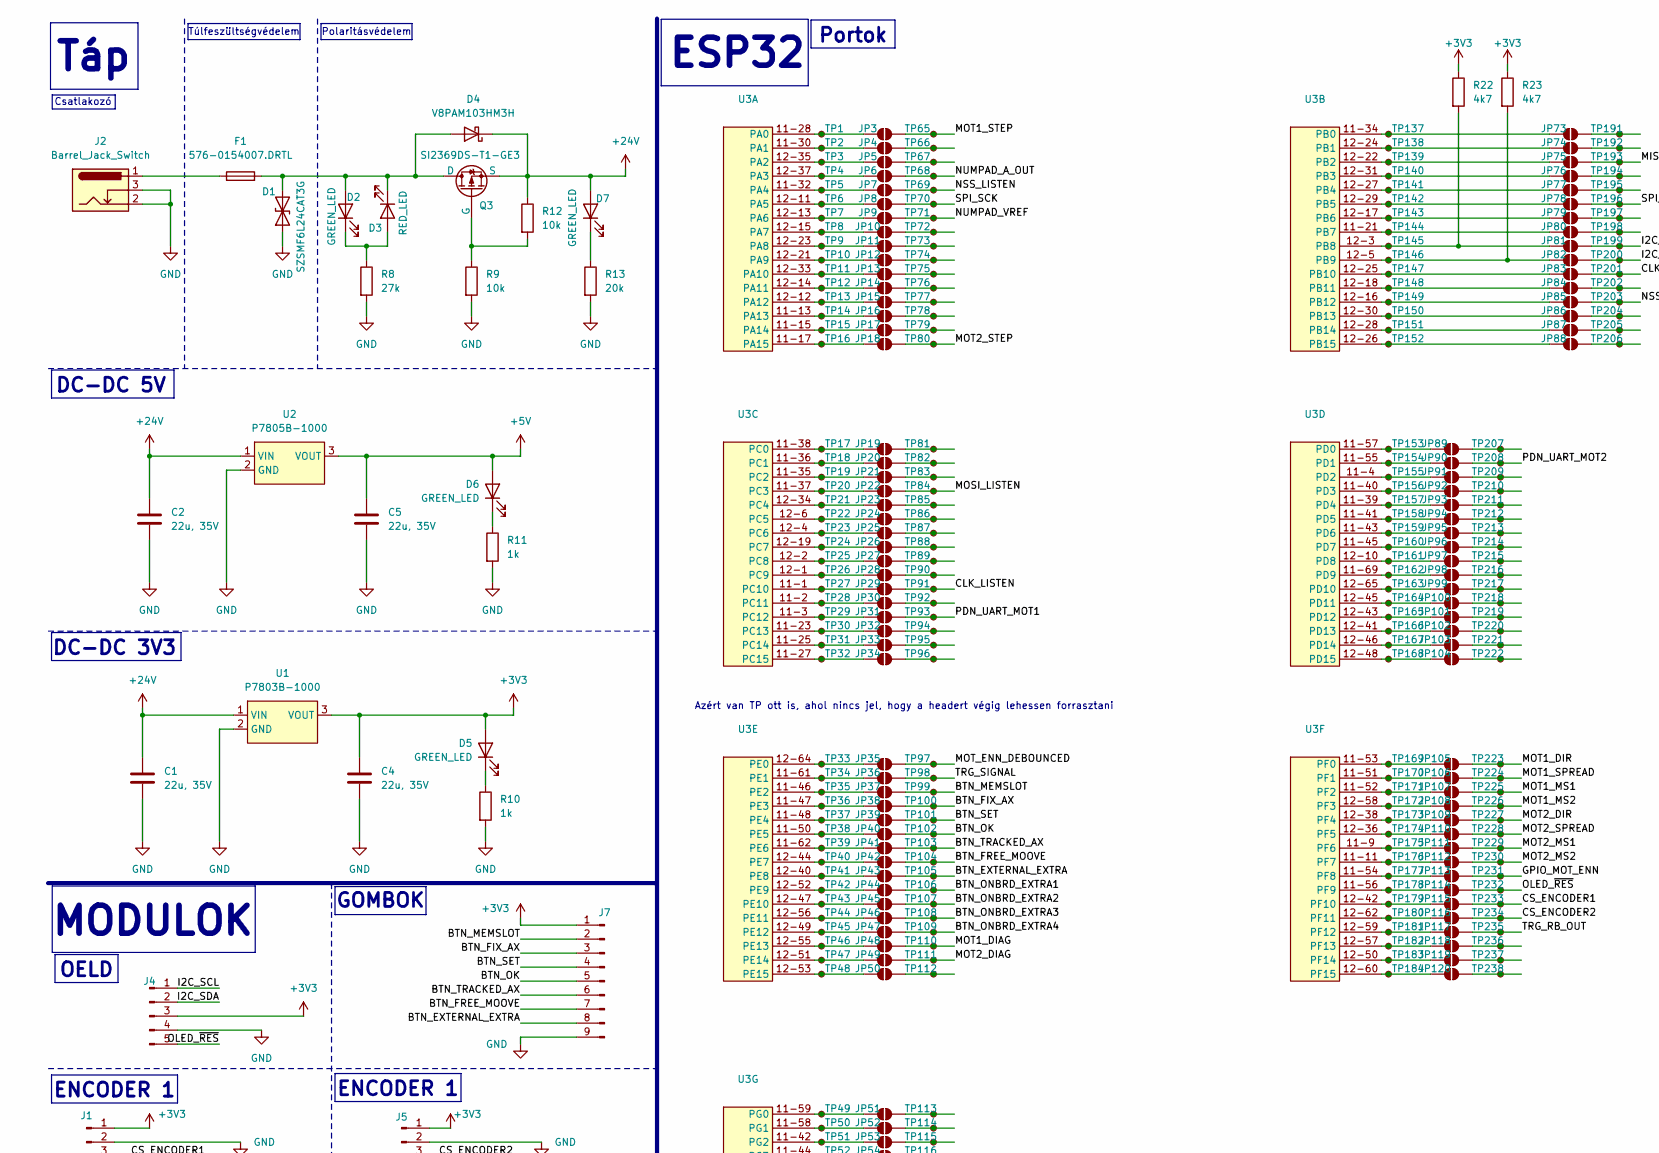
[picture p141: schematic motherboard.kicad_sch, part in row 1, column 1]

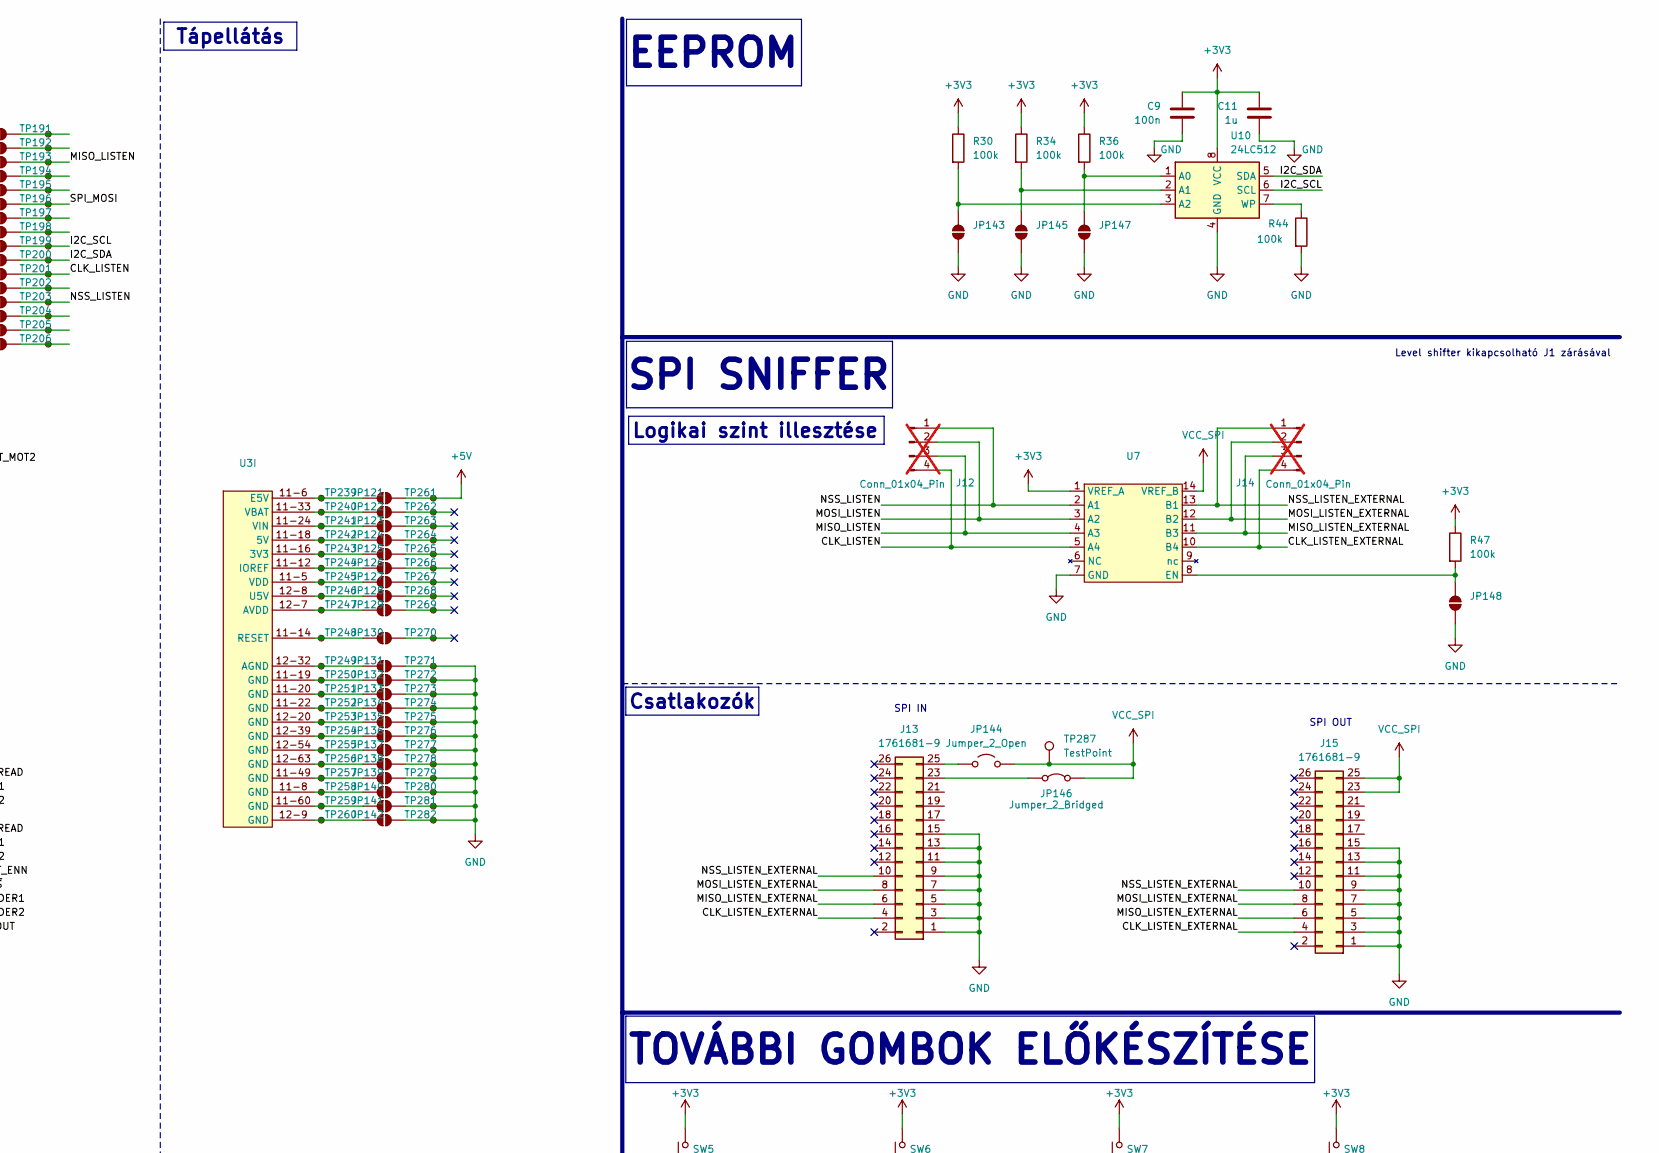
[picture p142: schematic motherboard.kicad_sch, part in row 1, column 2]

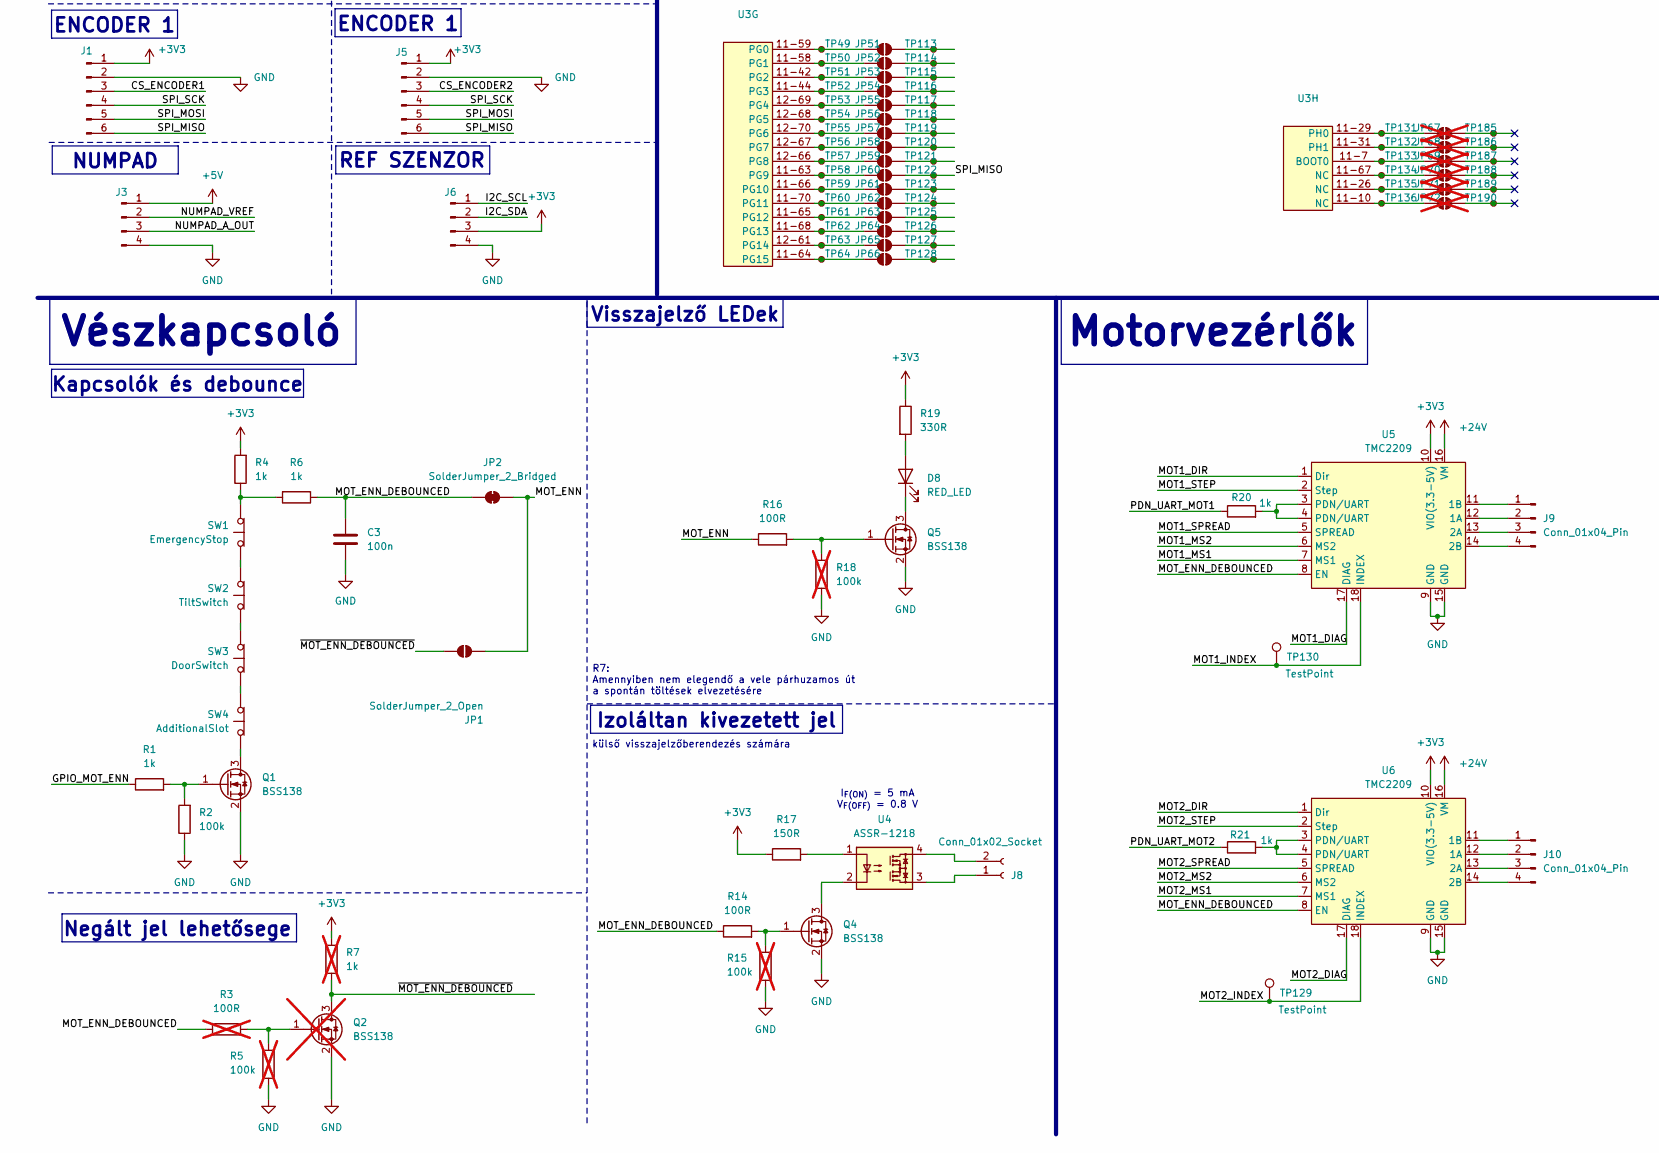
[picture p143: schematic motherboard.kicad_sch, part in row 2, column 1]

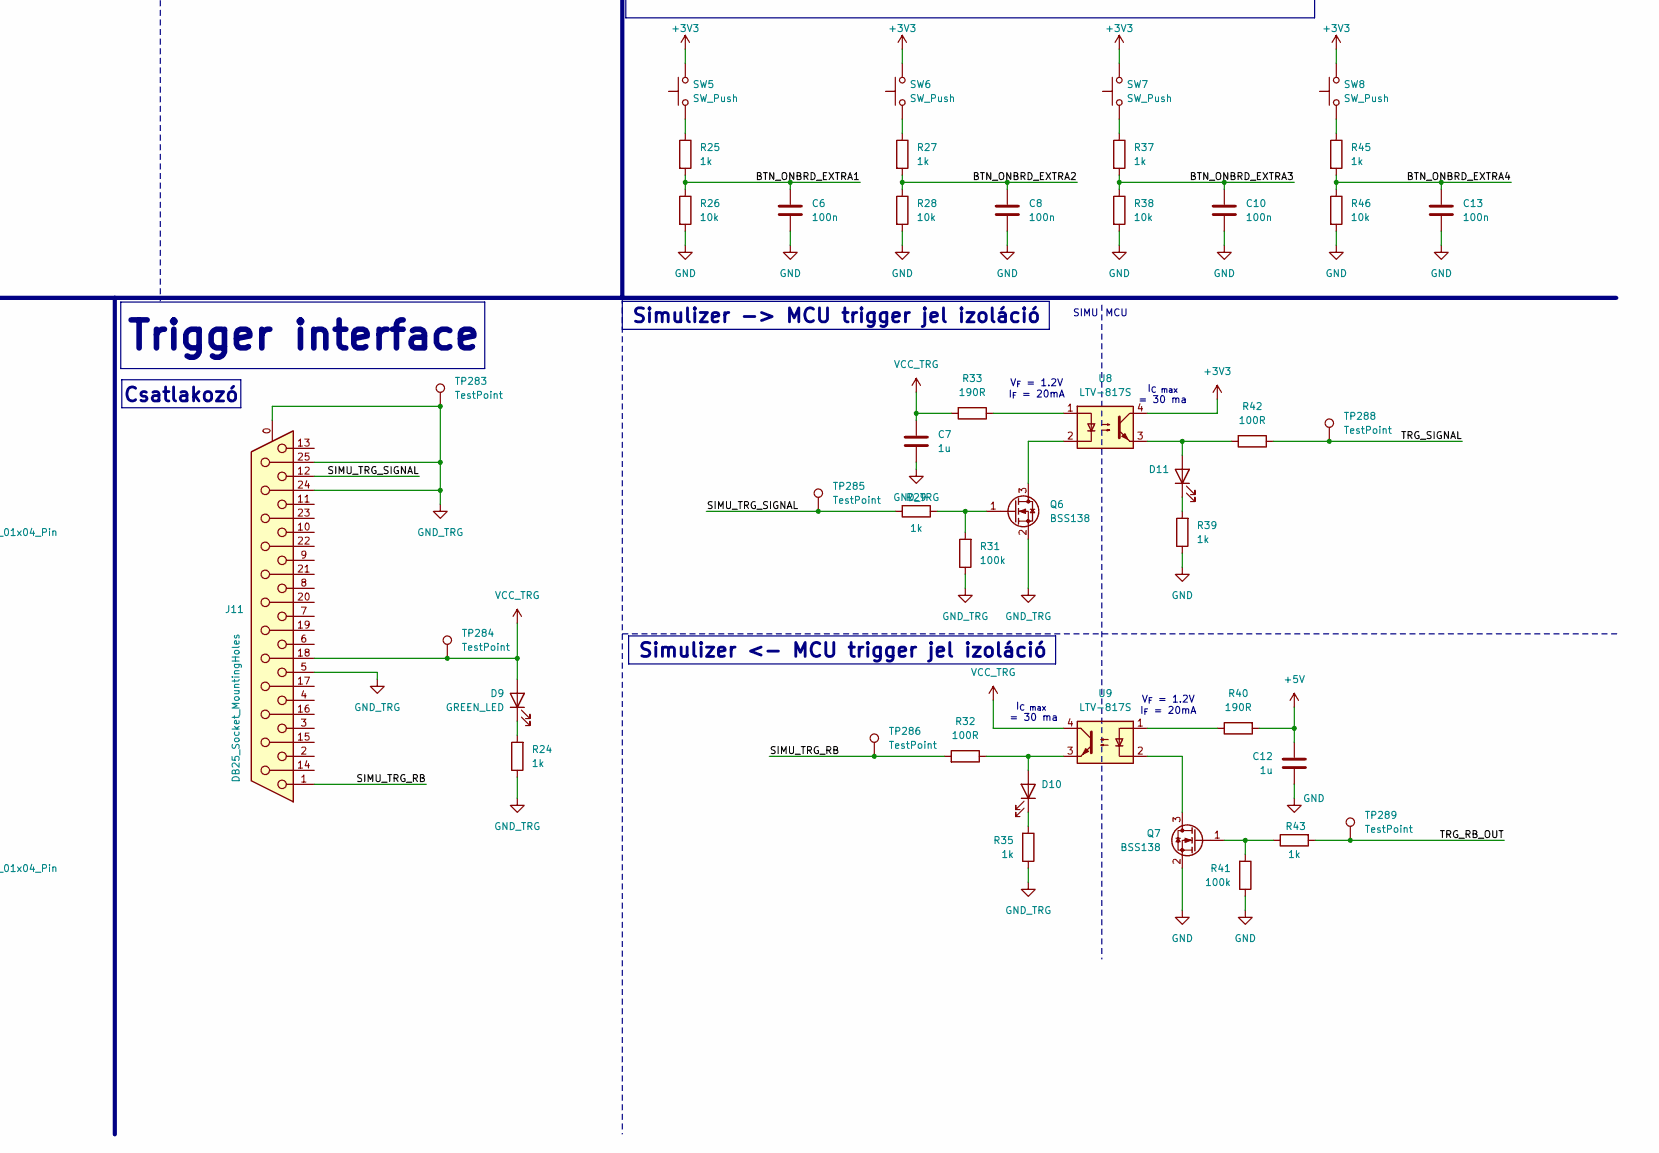
[picture p144: schematic motherboard.kicad_sch, part in row 2, column 2]

Parts:
C1, C2, C4, C5: 22u, 35V; C_1206_3216Metric
C3, C6, C8, C9, C10, C13: 100n; C_0603_1608Metric
C7, C11, C12: 1u; C_0603_1608Metric
D1: SZSMF6L24CAT3G; D_SOD-123
D2, D5, D6, D7, D9, D10, D11: GREEN_LED; D_0603_1608Metric
D3, D8: RED_LED; D_0603_1608Metric
D4: V8PAM103HM3H; Vishay_SMPA
F1: 576-0154007.DRTL; Fuseholder_Littelfuse_Nano2_154x
J1, J5: Conn_01x06_Pin; JST_PH_B6B-PH-K_1x06_P2.00mm_Vertical
J2: Barrel_Jack_Switch; BarrelJack_Wuerth_694106106102_2.0x5.5mm
J3, J6, J9, J10: Conn_01x04_Pin; JST_PH_B4B-PH-K_1x04_P2.00mm_Vertical
J4: Conn_01x05_Pin; JST_PH_B5B-PH-K_1x05_P2.00mm_Vertical
J7: Conn_01x09_Pin; JST_PH_B9B-PH-K_1x09_P2.00mm_Vertical
J8: Conn_01x02_Socket; TerminalBlock_Phoenix_MKDS-1,5-2_1x02_P5.00mm_Horizontal
J11: DB25_Socket_MountingHoles; DSUB-25_Socket_Horizontal_P2.77x2.84mm_EdgePinOffset7.70mm_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
J12, J14: Conn_01x04_Pin; PinSocket_1x04_P2.54mm_Vertical; not fitted
J13, J15: 1761681-9; PinHeader_2x13_P2.54mm_Vertical
JP1: SolderJumper_2_Open; R_0603_1608Metric
JP2: SolderJumper_2_Bridged; R_0603_1608Metric
JP3, JP4, JP5, JP6, JP7, JP8, JP9, JP10, JP11, JP12, JP13, JP14, JP15, JP16, JP17, JP18, JP19, JP20, JP21, JP22, JP23, JP24, JP25, JP26, JP27, JP28, JP29, JP30, JP31, JP32, JP33, JP34, JP35, JP36, JP37, JP38, JP39, JP40, JP41, JP42, JP43, JP44, JP45, JP46, JP47, JP48, JP49, JP50, JP51, JP52, JP53, JP54, JP55, JP56, JP57, JP58, JP59, JP60, JP61, JP62, JP63, JP64, JP65, JP66, JP73, JP74, JP75, JP76, JP77, JP78, JP79, JP80, JP81, JP82, JP83, JP84, JP85, JP86, JP87, JP88, JP89, JP90, JP91, JP92, JP93, JP94, JP95, JP96, JP97, JP98, JP99, JP100, JP101, JP102, JP103, JP104, JP105, JP106, JP107, JP108, JP109, JP110, JP111, JP112, JP113, JP114, JP115, JP116, JP117, JP118, JP119, JP120, JP121, JP122, JP123, JP124, JP125, JP126, JP127, JP128, JP129, JP130, JP131, JP132, JP133, JP134, JP135, JP136, JP137, JP138, JP139, JP140, JP141, JP142: SolderJumper_2_Open; R_0603_1608Metric_Pad0.98x0.95mm_HandSolder
JP67, JP68, JP69, JP70, JP71, JP72: SolderJumper_2_Open; R_0603_1608Metric_Pad0.98x0.95mm_HandSolder; not fitted
JP143, JP145, JP147, JP148: SolderJumper_2_Open; SolderJumper-2_P1.3mm_Open_RoundedPad1.0x1.5mm
JP144: Jumper_2_Open; PinHeader_1x02_P2.54mm_Vertical
JP146: Jumper_2_Bridged; PinHeader_1x02_P2.54mm_Vertical
Q1, Q4, Q5, Q6, Q7: BSS138; SOT-23
Q2: BSS138; SOT-23; not fitted
Q3: SI2369DS-T1-GE3; TSOT-23
R1, R4, R6, R10, R11, R20, R21, R24, R25, R27, R29, R35, R37, R39, R43, R45: 1k; R_0603_1608Metric
R2, R30, R31, R34, R36, R41, R44, R47: 100k; R_0603_1608Metric
R3: 100R; R_0603_1608Metric; not fitted
R5, R15, R18: 100k; R_0603_1608Metric; not fitted
R7: 1k; R_0603_1608Metric; not fitted
R8: 27k; R_0603_1608Metric
R9, R12, R26, R28, R38, R46: 10k; R_0603_1608Metric
R13: 20k; R_0603_1608Metric
R14, R16, R32, R42: 100R; R_0603_1608Metric
R17: 150R; R_0603_1608Metric
R19: 330R; R_0603_1608Metric
R22, R23: 4k7; R_0603_1608Metric
R33, R40: 190R; R_0603_1608Metric
SW1: EmergencyStop; TerminalBlock_Phoenix_MKDS-1,5-2_1x02_P5.00mm_Horizontal
SW2: TiltSwitch; TerminalBlock_Phoenix_MKDS-1,5-2_1x02_P5.00mm_Horizontal
SW3: DoorSwitch; TerminalBlock_Phoenix_MKDS-1,5-2_1x02_P5.00mm_Horizontal
SW4: AdditionalSlot; TerminalBlock_Phoenix_MKDS-1,5-2_1x02_P5.00mm_Horizontal
SW5, SW6, SW7, SW8: SW_Push; PinSocket_1x02_P2.54mm_Vertical
TP1, TP2, TP3, TP4, TP5, TP6, TP7, TP8, TP9, TP10, TP11, TP12, TP13, TP14, TP15, TP16, TP17, TP18, TP19, TP20, TP21, TP22, TP23, TP24, TP25, TP26, TP27, TP28, TP29, TP30, TP31, TP32, TP33, TP34, TP35, TP36, TP37, TP38, TP39, TP40, TP41, TP42, TP43, TP44, TP45, TP46, TP47, TP48, TP49, TP50, TP51, TP52, TP53, TP54, TP55, TP56, TP57, TP58, TP59, TP60, TP61, TP62, TP63, TP64, TP65, TP66, TP67, TP68, TP69, TP70, TP71, TP72, TP73, TP74, TP75, TP76, TP77, TP78, TP79, TP80, TP81, TP82, TP83, TP84, TP85, TP86, TP87, TP88, TP89, TP90, TP91, TP92, TP93, TP94, TP95, TP96, TP97, TP98, TP99, TP100, TP101, TP102, TP103, TP104, TP105, TP106, TP107, TP108, TP109, TP110, TP111, TP112, TP113, TP114, TP115, TP116, TP117, TP118, TP119, TP120, TP121, TP122, TP123, TP124, TP125, TP126, TP127, TP128, TP131, TP132, TP133, TP134, TP135, TP136, TP137, TP138, TP139, TP140, TP141, TP142, TP143, TP144, TP145, TP146, TP147, TP148, TP149, TP150, TP151, TP152, TP153, TP154, TP155, TP156, TP157, TP158, TP159, TP160, TP161, TP162, TP163, TP164, TP165, TP166, TP167, TP168, TP169, TP170, TP171, TP172, TP173, TP174, TP175, TP176, TP177, TP178, TP179, TP180, TP181, TP182, TP183, TP184, TP185, TP186, TP187, TP188, TP189, TP190, TP191, TP192, TP193, TP194, TP195, TP196, TP197, TP198, TP199, TP200, TP201, TP202, TP203, TP204, TP205, TP206, TP207, TP208, TP209, TP210, TP211, TP212, TP213, TP214, TP215, TP216, TP217, TP218, TP219, TP220, TP221, TP222, TP223, TP224, TP225, TP226, TP227, TP228, TP229, TP230, TP231, TP232, TP233, TP234, TP235, TP236, TP237, TP238, TP239, TP240, TP241, TP242, TP243, TP244, TP245, TP246, TP247, TP248, TP249, TP250, TP251, TP252, TP253, TP254, TP255, TP256, TP257, TP258, TP259, TP260, TP261, TP262, TP263, TP264, TP265, TP266, TP267, TP268, TP269, TP270, TP271, TP272, TP273, TP274, TP275, TP276, TP277, TP278, TP279, TP280, TP281, TP282: TestPoint_Small; PinSocket_1x01_P2.54mm_Vertical
TP129, TP130: TestPoint; PinSocket_1x01_P2.54mm_Vertical
TP283, TP284, TP285, TP286, TP288, TP289: TestPoint; TestPoint_Pad_D2.0mm
TP287: TestPoint; PinHeader_1x01_P2.54mm_Vertical
U1: P7803B-1000; SIP3_11.6x8.5mm
U2: P7805B-1000; SIP3_11.6x8.5mm
U3: NUCLEO-F767ZI
U4: ASSR-1218; SO-4_4.4x4.3mm_P2.54mm
U5, U6: TMC2209; TMC2209 Silentstepstick
U7: TSSOP-14_4.4x5mm_P0.65mm
U8, U9: LTV-817S; SMDIP-4_W9.53mm
U10: 24LC512; SOIC-8_5.3x6.2mm_P1.27mm

Connections:
+3V3: C4.1, C9.1, C11.1, D5.2 (A), J1.1, J4.3, J5.1, J6.3, J7.1, R4.2, R7.2, R17.1, R19.1, R22.1, R23.1, R30.1, R34.1, R36.1, R47.1, SW5.2, SW6.2, SW7.2, SW8.2, U1.3 (VOUT), U5.10 (VIO(3.3-5V)), U6.10 (VIO(3.3-5V)), U7.1 (VREF_A), U8.4, U10.8 (VCC)
+5V: C5.1, C12.1, D6.2 (A), J3.1, JP121.2 (B), R40.2, TP261.1, U2.3 (VOUT)
+24V: C1.1, C2.1, D4.1 (K), D7.2 (A), Q3.3 (S), R12.1, U1.1 (VIN), U2.1 (VIN), U5.16 (VM), U6.16 (VM)
/BTN_EXTERNAL_EXTRA: J7.8, JP43.2 (B), TP105.1
/BTN_FIX_AX: J7.3, JP38.2 (B), TP100.1
/BTN_FREE_MOOVE: J7.7, JP42.2 (B), TP104.1
/BTN_MEMSLOT: J7.2, JP37.2 (B), TP99.1
/BTN_OK: J7.5, JP40.2 (B), TP102.1
/BTN_ONBRD_EXTRA1: C6.1, JP44.2 (B), R25.2, R26.1, TP106.1
/BTN_ONBRD_EXTRA2: C8.1, JP45.2 (B), R27.2, R28.1, TP107.1
/BTN_ONBRD_EXTRA3: C10.1, JP46.2 (B), R37.2, R38.1, TP108.1
/BTN_ONBRD_EXTRA4: C13.1, JP47.2 (B), R45.2, R46.1, TP109.1
/BTN_SET: J7.4, JP39.2 (B), TP101.1
/BTN_TRACKED_AX: J7.6, JP41.2 (B), TP103.1
/CLK_LISTEN: J12.4, JP29.2 (B), JP83.2 (B), TP91.1, TP201.1, U7.5 (A4)
/CLK_LISTEN_EXTERNAL: J13.4, J14.4, J15.4, U7.10 (B4)
/CS_ENCODER1: J1.3, JP115.2 (B), TP233.1
/CS_ENCODER2: J5.3, JP116.2 (B), TP234.1
/GPIO_MOT_ENN: JP113.2 (B), R1.1, TP231.1
/I2C_SCL: J4.1, J6.1, JP81.2 (B), TP199.1, U10.6 (SCL)
/I2C_SDA: J4.2, J6.2, JP82.2 (B), TP200.1, U10.5 (SDA)
/MISO_LISTEN: J12.3, JP75.2 (B), TP193.1, U7.4 (A3)
/MISO_LISTEN_EXTERNAL: J13.6, J14.3, J15.6, U7.11 (B3)
/MOSI_LISTEN: J12.2, JP22.2 (B), TP84.1, U7.3 (A2)
/MOSI_LISTEN_EXTERNAL: J13.8, J14.2, J15.8, U7.12 (B2)
/MOT1_DIAG: JP48.2 (B), TP110.1, U5.17 (DIAG)
/MOT1_DIR: JP105.2 (B), TP223.1, U5.1 (Dir)
/MOT1_INDEX: TP130.1, U5.18 (INDEX)
/MOT1_MS1: JP107.2 (B), TP225.1, U5.7 (MS1)
/MOT1_MS2: JP108.2 (B), TP226.1, U5.6 (MS2)
/MOT1_SPREAD: JP106.2 (B), TP224.1, U5.5 (SPREAD)
/MOT1_STEP: JP3.2 (B), TP65.1, U5.2 (Step)
/MOT2_DIAG: JP49.2 (B), TP111.1, U6.17 (DIAG)
/MOT2_DIR: JP109.2 (B), TP227.1, U6.1 (Dir)
/MOT2_INDEX: TP129.1, U6.18 (INDEX)
/MOT2_MS1: JP111.2 (B), TP229.1, U6.7 (MS1)
/MOT2_MS2: JP112.2 (B), TP230.1, U6.6 (MS2)
/MOT2_SPREAD: JP110.2 (B), TP228.1, U6.5 (SPREAD)
/MOT2_STEP: JP18.2 (B), TP80.1, U6.2 (Step)
/MOT_ENN: JP1.1 (A), JP2.2 (B), R16.1
/MOT_ENN_DEBOUNCED: C3.1, JP2.1 (A), JP35.2 (B), R3.1, R6.1, R14.1, TP97.1, U5.8 (EN), U6.8 (EN)
/NSS_LISTEN: J12.1, JP7.2 (B), JP85.2 (B), TP69.1, TP203.1, U7.2 (A1)
/NSS_LISTEN_EXTERNAL: J13.10, J14.1, J15.10, U7.13 (B1)
/NUMPAD_A_OUT: J3.3, JP6.2 (B), TP68.1
/NUMPAD_VREF: J3.2, JP9.2 (B), TP71.1
/OLED_~RES: J4.5, JP114.2 (B), TP232.1
/PDN_UART_MOT1: JP31.2 (B), R20.1, TP93.1
/PDN_UART_MOT2: JP90.2 (B), R21.1, TP208.1
/SIMU_TRG_RB: J11.1, R32.2, TP286.1
/SIMU_TRG_SIGNAL: J11.12, R29.2, TP285.1
/SPI_MISO: J1.6, J5.6, JP60.2 (B), TP122.1
/SPI_MOSI: J1.5, J5.5, JP78.2 (B), TP196.1
/SPI_SCK: J1.4, J5.4, JP8.2 (B), TP70.1
/TRG_RB_OUT: JP117.2 (B), R43.2, TP235.1, TP289.1
/TRG_SIGNAL: JP36.2 (B), R42.1, TP98.1, TP288.1
/~MOT_ENN_DEBOUNCED: JP1.2 (B), Q2.3 (D), R7.1
GND: C1.2, C2.2, C3.2, C4.2, C5.2, C6.2, C8.2, C9.2, C10.2, C11.2, C12.2, C13.2, D1.1 (A1), J1.2, J2.2, J2.3, J3.4, J4.4, J5.2, J6.4, J7.9, J13.1, J13.3, J13.5, J13.7, J13.9, J13.11, J13.13, J13.15, J15.1, J15.3, J15.5, J15.7, J15.9, J15.11, J15.13, J15.15, JP131.2 (B), JP132.2 (B), JP133.2 (B), JP134.2 (B), JP135.2 (B), JP136.2 (B), JP137.2 (B), JP138.2 (B), JP139.2 (B), JP140.2 (B), JP141.2 (B), JP142.2 (B), JP143.2 (B), JP145.2 (B), JP147.2 (B), JP148.2 (B), Q1.2 (S), Q2.2 (S), Q4.2 (S), Q5.2 (S), Q7.2 (S), R2.1, R5.1, R8.2, R9.2, R10.2, R11.2, R13.2, R15.1, R18.1, R26.2, R28.2, R38.2, R39.1, R41.1, R44.2, R46.2, TP271.1, TP272.1, TP273.1, TP274.1, TP275.1, TP276.1, TP277.1, TP278.1, TP279.1, TP280.1, TP281.1, TP282.1, U1.2 (GND), U2.2 (GND), U5.9 (GND), U5.15 (GND), U6.9 (GND), U6.15 (GND), U7.7 (GND), U10.4 (GND)
GND_TRG: C7.2, J11.0 (PAD), J11.5, J11.24, J11.25, Q6.2 (S), R24.1, R31.1, R35.1, TP283.1
unnamed: D1.2 (A2), D2.2 (A), D3.1 (K), D4.2 (A), F1.2, Q3.1 (D)
unnamed: D2.1 (K), D3.2 (A), R8.1
unnamed: D5.1 (K), R10.1
unnamed: D6.1 (K), R11.1
unnamed: D7.1 (K), R13.1
unnamed: D8.2 (A), R19.2
unnamed: D8.1 (K), Q5.3 (D)
unnamed: D9.1 (K), R24.2
unnamed: D10.2 (A), R32.1, U9.3
unnamed: D10.1 (K), R35.2
unnamed: D11.2 (A), R42.2, U8.3
unnamed: D11.1 (K), R39.2
unnamed: F1.1, J2.1
unnamed: J8.1, U4.3
unnamed: J8.2, U4.4
unnamed: J9.1, U5.11 (1B)
unnamed: J9.2, U5.12 (1A)
unnamed: J9.3, U5.13 (2A)
unnamed: J9.4, U5.14 (2B)
unnamed: J10.1, U6.11 (1B)
unnamed: J10.2, U6.12 (1A)
unnamed: J10.3, U6.13 (2A)
unnamed: J10.4, U6.14 (2B)
unnamed: J13.23, JP146.1 (A)
unnamed: J13.25, JP144.1 (A)
unnamed: JP3.1 (A), TP1.1, U3.11-28 (PA0)
unnamed: JP4.1 (A), TP2.1, U3.11-30 (PA1)
unnamed: JP4.2 (B), TP66.1
unnamed: JP5.1 (A), TP3.1, U3.12-35 (PA2)
unnamed: JP5.2 (B), TP67.1
unnamed: JP6.1 (A), TP4.1, U3.12-37 (PA3)
unnamed: JP7.1 (A), TP5.1, U3.11-32 (PA4)
unnamed: JP8.1 (A), TP6.1, U3.12-11 (PA5)
unnamed: JP9.1 (A), TP7.1, U3.12-13 (PA6)
unnamed: JP10.1 (A), TP8.1, U3.12-15 (PA7)
unnamed: JP10.2 (B), TP72.1
unnamed: JP11.1 (A), TP9.1, U3.12-23 (PA8)
unnamed: JP11.2 (B), TP73.1
unnamed: JP12.1 (A), TP10.1, U3.12-21 (PA9)
unnamed: JP12.2 (B), TP74.1
unnamed: JP13.1 (A), TP11.1, U3.12-33 (PA10)
unnamed: JP13.2 (B), TP75.1
unnamed: JP14.1 (A), TP12.1, U3.12-14 (PA11)
unnamed: JP14.2 (B), TP76.1
unnamed: JP15.1 (A), TP13.1, U3.12-12 (PA12)
unnamed: JP15.2 (B), TP77.1
unnamed: JP16.1 (A), TP14.1, U3.11-13 (PA13)
unnamed: JP16.2 (B), TP78.1
unnamed: JP17.1 (A), TP15.1, U3.11-15 (PA14)
unnamed: JP17.2 (B), TP79.1
unnamed: JP18.1 (A), TP16.1, U3.11-17 (PA15)
unnamed: JP19.1 (A), TP17.1, U3.11-38 (PC0)
unnamed: JP19.2 (B), TP81.1
unnamed: JP20.1 (A), TP18.1, U3.11-36 (PC1)
unnamed: JP20.2 (B), TP82.1
unnamed: JP21.1 (A), TP19.1, U3.11-35 (PC2)
unnamed: JP21.2 (B), TP83.1
unnamed: JP22.1 (A), TP20.1, U3.11-37 (PC3)
unnamed: JP23.1 (A), TP21.1, U3.12-34 (PC4)
unnamed: JP23.2 (B), TP85.1
unnamed: JP24.1 (A), TP22.1, U3.12-6 (PC5)
unnamed: JP24.2 (B), TP86.1
unnamed: JP25.1 (A), TP23.1, U3.12-4 (PC6)
unnamed: JP25.2 (B), TP87.1
unnamed: JP26.1 (A), TP24.1, U3.12-19 (PC7)
unnamed: JP26.2 (B), TP88.1
unnamed: JP27.1 (A), TP25.1, U3.12-2 (PC8)
unnamed: JP27.2 (B), TP89.1
unnamed: JP28.1 (A), TP26.1, U3.12-1 (PC9)
unnamed: JP28.2 (B), TP90.1
unnamed: JP29.1 (A), TP27.1, U3.11-1 (PC10)
unnamed: JP30.1 (A), TP28.1, U3.11-2 (PC11)
unnamed: JP30.2 (B), TP92.1
unnamed: JP31.1 (A), TP29.1, U3.11-3 (PC12)
unnamed: JP32.1 (A), TP30.1, U3.11-23 (PC13)
unnamed: JP32.2 (B), TP94.1
unnamed: JP33.1 (A), TP31.1, U3.11-25 (PC14)
unnamed: JP33.2 (B), TP95.1
unnamed: JP34.1 (A), TP32.1, U3.11-27 (PC15)
unnamed: JP34.2 (B), TP96.1
unnamed: JP35.1 (A), TP33.1, U3.12-64 (PE0)
unnamed: JP36.1 (A), TP34.1, U3.11-61 (PE1)
unnamed: JP37.1 (A), TP35.1, U3.11-46 (PE2)
unnamed: JP38.1 (A), TP36.1, U3.11-47 (PE3)
unnamed: JP39.1 (A), TP37.1, U3.11-48 (PE4)
unnamed: JP40.1 (A), TP38.1, U3.11-50 (PE5)
unnamed: JP41.1 (A), TP39.1, U3.11-62 (PE6)
unnamed: JP42.1 (A), TP40.1, U3.12-44 (PE7)
unnamed: JP43.1 (A), TP41.1, U3.12-40 (PE8)
unnamed: JP44.1 (A), TP42.1, U3.12-52 (PE9)
unnamed: JP45.1 (A), TP43.1, U3.12-47 (PE10)
unnamed: JP46.1 (A), TP44.1, U3.12-56 (PE11)
unnamed: JP47.1 (A), TP45.1, U3.12-49 (PE12)
unnamed: JP48.1 (A), TP46.1, U3.12-55 (PE13)
unnamed: JP49.1 (A), TP47.1, U3.12-51 (PE14)
unnamed: JP50.1 (A), TP48.1, U3.12-53 (PE15)
unnamed: JP50.2 (B), TP112.1
unnamed: JP51.1 (A), TP49.1, U3.11-59 (PG0)
unnamed: JP51.2 (B), TP113.1
unnamed: JP52.1 (A), TP50.1, U3.11-58 (PG1)
unnamed: JP52.2 (B), TP114.1
unnamed: JP53.1 (A), TP51.1, U3.11-42 (PG2)
unnamed: JP53.2 (B), TP115.1
unnamed: JP54.1 (A), TP52.1, U3.11-44 (PG3)
unnamed: JP54.2 (B), TP116.1
unnamed: JP55.1 (A), TP53.1, U3.12-69 (PG4)
unnamed: JP55.2 (B), TP117.1
unnamed: JP56.1 (A), TP54.1, U3.12-68 (PG5)
unnamed: JP56.2 (B), TP118.1
unnamed: JP57.1 (A), TP55.1, U3.12-70 (PG6)
unnamed: JP57.2 (B), TP119.1
unnamed: JP58.1 (A), TP56.1, U3.12-67 (PG7)
unnamed: JP58.2 (B), TP120.1
unnamed: JP59.1 (A), TP57.1, U3.12-66 (PG8)
unnamed: JP59.2 (B), TP121.1
unnamed: JP60.1 (A), TP58.1, U3.11-63 (PG9)
unnamed: JP61.1 (A), TP59.1, U3.11-66 (PG10)
unnamed: JP61.2 (B), TP123.1
unnamed: JP62.1 (A), TP60.1, U3.11-70 (PG11)
unnamed: JP62.2 (B), TP124.1
unnamed: JP63.1 (A), TP61.1, U3.11-65 (PG12)
unnamed: JP63.2 (B), TP125.1
unnamed: JP64.1 (A), TP62.1, U3.11-68 (PG13)
unnamed: JP64.2 (B), TP126.1
unnamed: JP65.1 (A), TP63.1, U3.12-61 (PG14)
unnamed: JP65.2 (B), TP127.1
unnamed: JP66.1 (A), TP64.1, U3.11-64 (PG15)
unnamed: JP66.2 (B), TP128.1
unnamed: JP67.1 (A), TP131.1, U3.11-29 (PH0)
unnamed: JP68.1 (A), TP132.1, U3.11-31 (PH1)
unnamed: JP69.1 (A), TP133.1, U3.11-7 (BOOT0)
unnamed: JP70.1 (A), TP134.1, U3.11-67 (NC)
unnamed: JP71.1 (A), TP135.1, U3.11-26 (NC)
unnamed: JP72.1 (A), TP136.1, U3.11-10 (NC)
unnamed: JP73.1 (A), TP137.1, U3.11-34 (PB0)
unnamed: JP73.2 (B), TP191.1
unnamed: JP74.1 (A), TP138.1, U3.12-24 (PB1)
unnamed: JP74.2 (B), TP192.1
unnamed: JP75.1 (A), TP139.1, U3.12-22 (PB2)
unnamed: JP76.1 (A), TP140.1, U3.12-31 (PB3)
unnamed: JP76.2 (B), TP194.1
unnamed: JP77.1 (A), TP141.1, U3.12-27 (PB4)
unnamed: JP77.2 (B), TP195.1
unnamed: JP78.1 (A), TP142.1, U3.12-29 (PB5)
unnamed: JP79.1 (A), TP143.1, U3.12-17 (PB6)
unnamed: JP79.2 (B), TP197.1
unnamed: JP80.1 (A), TP144.1, U3.11-21 (PB7)
unnamed: JP80.2 (B), TP198.1
unnamed: JP81.1 (A), R22.2, TP145.1, U3.12-3 (PB8)
unnamed: JP82.1 (A), R23.2, TP146.1, U3.12-5 (PB9)
unnamed: JP83.1 (A), TP147.1, U3.12-25 (PB10)
unnamed: JP84.1 (A), TP148.1, U3.12-18 (PB11)
unnamed: JP84.2 (B), TP202.1
unnamed: JP85.1 (A), TP149.1, U3.12-16 (PB12)
unnamed: JP86.1 (A), TP150.1, U3.12-30 (PB13)
unnamed: JP86.2 (B), TP204.1
unnamed: JP87.1 (A), TP151.1, U3.12-28 (PB14)
unnamed: JP87.2 (B), TP205.1
unnamed: JP88.1 (A), TP152.1, U3.12-26 (PB15)
unnamed: JP88.2 (B), TP206.1
unnamed: JP89.1 (A), TP153.1, U3.11-57 (PD0)
unnamed: JP89.2 (B), TP207.1
unnamed: JP90.1 (A), TP154.1, U3.11-55 (PD1)
unnamed: JP91.1 (A), TP155.1, U3.11-4 (PD2)
unnamed: JP91.2 (B), TP209.1
unnamed: JP92.1 (A), TP156.1, U3.11-40 (PD3)
unnamed: JP92.2 (B), TP210.1
unnamed: JP93.1 (A), TP157.1, U3.11-39 (PD4)
unnamed: JP93.2 (B), TP211.1
unnamed: JP94.1 (A), TP158.1, U3.11-41 (PD5)
unnamed: JP94.2 (B), TP212.1
unnamed: JP95.1 (A), TP159.1, U3.11-43 (PD6)
unnamed: JP95.2 (B), TP213.1
unnamed: JP96.1 (A), TP160.1, U3.11-45 (PD7)
unnamed: JP96.2 (B), TP214.1
unnamed: JP97.1 (A), TP161.1, U3.12-10 (PD8)
unnamed: JP97.2 (B), TP215.1
unnamed: JP98.1 (A), TP162.1, U3.11-69 (PD9)
unnamed: JP98.2 (B), TP216.1
unnamed: JP99.1 (A), TP163.1, U3.12-65 (PD10)
unnamed: JP99.2 (B), TP217.1
unnamed: JP100.1 (A), TP164.1, U3.12-45 (PD11)
unnamed: JP100.2 (B), TP218.1
unnamed: JP101.1 (A), TP165.1, U3.12-43 (PD12)
unnamed: JP101.2 (B), TP219.1
unnamed: JP102.1 (A), TP166.1, U3.12-41 (PD13)
unnamed: JP102.2 (B), TP220.1
unnamed: JP103.1 (A), TP167.1, U3.12-46 (PD14)
unnamed: JP103.2 (B), TP221.1
unnamed: JP104.1 (A), TP168.1, U3.12-48 (PD15)
unnamed: JP104.2 (B), TP222.1
unnamed: JP105.1 (A), TP169.1, U3.11-53 (PF0)
unnamed: JP106.1 (A), TP170.1, U3.11-51 (PF1)
unnamed: JP107.1 (A), TP171.1, U3.11-52 (PF2)
unnamed: JP108.1 (A), TP172.1, U3.12-58 (PF3)
unnamed: JP109.1 (A), TP173.1, U3.12-38 (PF4)
unnamed: JP110.1 (A), TP174.1, U3.12-36 (PF5)
unnamed: JP111.1 (A), TP175.1, U3.11-9 (PF6)
unnamed: JP112.1 (A), TP176.1, U3.11-11 (PF7)
unnamed: JP113.1 (A), TP177.1, U3.11-54 (PF8)
unnamed: JP114.1 (A), TP178.1, U3.11-56 (PF9)
unnamed: JP115.1 (A), TP179.1, U3.12-42 (PF10)
unnamed: JP116.1 (A), TP180.1, U3.12-62 (PF11)
unnamed: JP117.1 (A), TP181.1, U3.12-59 (PF12)
unnamed: JP118.1 (A), TP182.1, U3.12-57 (PF13)
unnamed: JP118.2 (B), TP236.1
unnamed: JP119.1 (A), TP183.1, U3.12-50 (PF14)
unnamed: JP119.2 (B), TP237.1
unnamed: JP120.1 (A), TP184.1, U3.12-60 (PF15)
unnamed: JP120.2 (B), TP238.1
unnamed: JP121.1 (A), TP239.1, U3.11-6 (E5V)
unnamed: JP122.1 (A), TP240.1, U3.11-33 (VBAT)
unnamed: JP123.1 (A), TP241.1, U3.11-24 (VIN)
unnamed: JP124.1 (A), TP242.1, U3.11-18 (5V)
unnamed: JP125.1 (A), TP243.1, U3.11-16 (3V3)
unnamed: JP126.1 (A), TP244.1, U3.11-12 (IOREF)
unnamed: JP127.1 (A), TP245.1, U3.11-5 (VDD)
unnamed: JP128.1 (A), TP246.1, U3.12-8 (U5V)
unnamed: JP129.1 (A), TP247.1, U3.12-7 (AVDD)
unnamed: JP130.1 (A), TP248.1, U3.11-14 (RESET)
unnamed: JP131.1 (A), TP249.1, U3.12-32 (AGND)
unnamed: JP132.1 (A), TP250.1, U3.11-19 (GND)
unnamed: JP133.1 (A), TP251.1, U3.11-20 (GND)
unnamed: JP134.1 (A), TP252.1, U3.11-22 (GND)
unnamed: JP135.1 (A), TP253.1, U3.12-20 (GND)
unnamed: JP136.1 (A), TP254.1, U3.12-39 (GND)
unnamed: JP137.1 (A), TP255.1, U3.12-54 (GND)
unnamed: JP138.1 (A), TP256.1, U3.12-63 (GND)
unnamed: JP139.1 (A), TP257.1, U3.11-49 (GND)
unnamed: JP140.1 (A), TP258.1, U3.11-8 (GND)
unnamed: JP141.1 (A), TP259.1, U3.11-60 (GND)
unnamed: JP142.1 (A), TP260.1, U3.12-9 (GND)
unnamed: JP143.1 (A), R30.2, U10.3 (A2)
unnamed: JP145.1 (A), R34.2, U10.2 (A1)
unnamed: JP147.1 (A), R36.2, U10.1 (A0)
unnamed: JP148.1 (A), R47.2, U7.8 (EN)
unnamed: Q1.3 (D), SW4.1 (A)
unnamed: Q1.1 (G), R1.2, R2.2
unnamed: Q2.1 (G), R3.2, R5.2
unnamed: Q3.2 (G), R9.1, R12.2
unnamed: Q4.3 (D), U4.2
unnamed: Q4.1 (G), R14.2, R15.2
unnamed: Q5.1 (G), R16.2, R18.2
unnamed: Q6.3 (D), U8.2
unnamed: Q6.1 (G), R29.1, R31.2
unnamed: Q7.3 (D), U9.2
unnamed: Q7.1 (G), R41.2, R43.1
unnamed: R17.2, U4.1
unnamed: R20.2, U5.3 (PDN/UART), U5.4 (PDN/UART)
unnamed: R21.2, U6.3 (PDN/UART), U6.4 (PDN/UART)
unnamed: R25.1, SW5.1
unnamed: R27.1, SW6.1
unnamed: R33.1, U8.1
unnamed: R37.1, SW7.1
unnamed: R40.1, U9.1
unnamed: R45.1, SW8.1
unnamed: SW1.1 (A), SW2.2 (B)
unnamed: R4.1, R6.2, SW1.2 (B)
unnamed: SW2.1 (A), SW3.2 (B)
unnamed: SW3.1 (A), SW4.2 (B)
unnamed: R44.1, U10.7 (WP)
VCC_SPI: J15.23, J15.25, JP144.2 (B), JP146.2 (B), TP287.1, U7.14 (VREF_B)
VCC_TRG: C7.1, D9.2 (A), J11.18, R33.2, TP284.1, U9.4

Notes on the sheet:
Portok
V_{F} = 1.2V I_{F} = 20mA
külső visszajelzőberendezés számára
I_{C max} = 30 ma
SIMU
ENCODER 1
MODULOK
Kapcsolók és debounce
Visszajelző LEDek
SPI OUT
Negált jel lehetősege
OELD
R7: Amennyiben nem elegendő a vele párhuzamos út a spontán töltések elvezetésére
Trigger interface
Simulizer <- MCU trigger jel izoláció
SPI IN
DC-DC 3V3
Túlfeszültségvédelem
Csatlakozók
GOMBOK
Level shifter kikapcsolható J1 zárásával
Azért van TP ott is, ahol nincs jel, hogy a headert végig lehessen forrasztani
Simulizer -> MCU trigger jel izoláció
ESP32
NUMPAD
EEPROM
DC-DC 5V
MCU
Tápellátás
Izoláltan kivezetett jel
Táp
SPI SNIFFER
Vészkapcsoló
I_{F(ON)} = 5 mA V_{F(OFF)} = 0.8 V
REF SZENZOR
TOVÁBBI GOMBOK ELŐKÉSZÍTÉSE
Logikai szint illesztése
I_{C max} = 30 ma
Csatlakozó
Motorvezérlők
Polaritásvédelem

Board: 2 copper layers, 549 parts (0 on the bottom side), 321 nets, no tracks yet.
