SAndras01/Masters-thesis/cubeIDE_workspace/TwoAxisPlatformMain/Core/Src/main.cpp

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
/* Includes ------------------------------------------------------------------*/
#include "main.h"
#include "string.h"

/* USER CODE BEGIN Includes */
#include <cstdio>
#include "StepperController.hpp"
#include "numpad.hpp"
#include "SSD1305.hpp"
#include "AS5147U.hpp"
#include "state_machine.hpp"

#include "../Modules/ICM20948/ICM20948.hpp"
/* USER CODE END Includes */

/* USER CODE BEGIN PD */
#define EEPROMAddress 0x50

/* USER CODE END PD */

#if defined ( __ICCARM__ ) /*!< IAR Compiler */
#pragma location=0x2007c000
ETH_DMADescTypeDef  DMARxDscrTab[ETH_RX_DESC_CNT]; /* Ethernet Rx DMA Descriptors */
#pragma location=0x2007c0a0
ETH_DMADescTypeDef  DMATxDscrTab[ETH_TX_DESC_CNT]; /* Ethernet Tx DMA Descriptors */

#elif defined ( __CC_ARM )  /* MDK ARM Compiler */

__attribute__((at(0x2007c000))) ETH_DMADescTypeDef  DMARxDscrTab[ETH_RX_DESC_CNT]; /* Ethernet Rx DMA Descriptors */
__attribute__((at(0x2007c0a0))) ETH_DMADescTypeDef  DMATxDscrTab[ETH_TX_DESC_CNT]; /* Ethernet Tx DMA Descriptors */

#elif defined ( __GNUC__ ) /* GNU Compiler */
ETH_DMADescTypeDef DMARxDscrTab[ETH_RX_DESC_CNT] __attribute__((section(".RxDecripSection"))); /* Ethernet Rx DMA Descriptors */
ETH_DMADescTypeDef DMATxDscrTab[ETH_TX_DESC_CNT] __attribute__((section(".TxDecripSection")));   /* Ethernet Tx DMA Descriptors */

#endif

ETH_TxPacketConfig TxConfig;

ADC_HandleTypeDef hadc1;

ETH_HandleTypeDef heth;

I2C_HandleTypeDef hi2c1;

SPI_HandleTypeDef hspi1;
SPI_HandleTypeDef hspi2;
SPI_HandleTypeDef hspi3;
DMA_HandleTypeDef hdma_spi2_rx;
DMA_HandleTypeDef hdma_spi3_rx;

TIM_HandleTypeDef htim2;
TIM_HandleTypeDef htim5;
TIM_HandleTypeDef htim6;
DMA_HandleTypeDef hdma_tim2_up_ch3;
DMA_HandleTypeDef hdma_tim5_up;

UART_HandleTypeDef huart3;

PCD_HandleTypeDef hpcd_USB_OTG_FS;

/* USER CODE BEGIN PV */
GPIO DIR_GPIO_MOT1(MOT1_DIR_GPIO_Port, MOT1_DIR_Pin);
GPIO ENN_GPIO_MOT1(MOT_ENN_GPIO_Port, MOT_ENN_Pin);

GPIO DIR_GPIO_MOT2(MOT2_DIR_GPIO_Port, MOT2_DIR_Pin);
GPIO ENN_GPIO_MOT2(MOT_ENN_GPIO_Port, MOT_ENN_Pin);

/* USER CODE END PV */

void SystemClock_Config(void);
static void MX_GPIO_Init(void);
static void MX_DMA_Init(void);
static void MX_USART3_UART_Init(void);
static void MX_USB_OTG_FS_PCD_Init(void);
static void MX_I2C1_Init(void);
static void MX_SPI1_Init(void);
static void MX_SPI2_Init(void);
static void MX_SPI3_Init(void);
static void MX_ETH_Init(void);
static void MX_TIM2_Init(void);
static void MX_TIM5_Init(void);
static void MX_ADC1_Init(void);
static void MX_TIM6_Init(void);
/* USER CODE BEGIN PFP */
void available_devices(int* devices)
{
	HAL_StatusTypeDef status;

	int j = 0;
	for(int i = 0; i<128; i++)
	{
		status = HAL_I2C_IsDeviceReady(&hi2c1, i<<1, 2, 100);
		devices[i] = 0;
		if(status == HAL_OK)
			{
				devices[j] = i;
				j++;
			}
	}
}
/* USER CODE END PFP */

/**
  * @brief  The application entry point.
  * @retval int
  */
int main(void)
{
  /* MCU Configuration--------------------------------------------------------*/

  /* Reset of all peripherals, Initializes the Flash interface and the Systick. */
  HAL_Init();

  /* Configure the system clock */
  SystemClock_Config();

  /* Initialize all configured peripherals */
  MX_GPIO_Init();
  MX_DMA_Init();
  MX_USART3_UART_Init();
  MX_USB_OTG_FS_PCD_Init();
  MX_I2C1_Init();
  MX_SPI1_Init();
  MX_SPI2_Init();
  MX_SPI3_Init();
  MX_ETH_Init();
  MX_TIM2_Init();
  MX_TIM5_Init();
  MX_ADC1_Init();
  MX_TIM6_Init();
  /* USER CODE BEGIN 2 */


  //ENN_GPIO_MOT1.digitalWrite(GPIO_PIN_RESET);
  //ENN_GPIO_MOT2.digitalWrite(GPIO_PIN_RESET);

  StepperController motor1_controller(
		  &htim2,
		  &hdma_tim2_up_ch3,
		  &DIR_GPIO_MOT1,
		  1.8d,
		  0.125d);

  StepperController motor2_controller(
		  &htim5,
		  &hdma_tim5_up,
		  &DIR_GPIO_MOT2,
		  1.8d,
		  0.125d);


  char MSG[30];
  numpadEnable();

  HAL_GPIO_WritePin(OLED_RES_GPIO_Port, OLED_RES_Pin, GPIO_PIN_SET);

  SSD1305 display(&hi2c1, 0x3C, 128, 32);
  display.Init();

  ICM20948 imu(&hi2c1, ICM20948_ADDR_AD0_HIGH);

  if (imu.init(true))
  {
	  display.SetCursor(0, 0);
	  display.WriteString("IMU INIT OK", Font_7x10, White);
	  display.WriteBitmapToScreen();
  }
  else
  {
	  display.SetCursor(0, 0);
	  display.WriteString("IMU INIT NOK", Font_7x10, White);
	  display.WriteBitmapToScreen();
	  while(1)
	  {
		  __NOP();
	  }
  }
  imu.setAccRange(FS_plus_minus_2G);



  AS5147U encoder(&hspi1, ENCODER1_CS_GPIO_Port, ENCODER1_CS_Pin);

  if( encoder.init() )
  {
	  display.Fill(Black);
	  display.SetCursor(0, 0);
	  display.WriteString("ENCODER INIT OK", Font_7x10, White);
	  display.WriteBitmapToScreen();
  }
  else
  {
	  display.Fill(Black);
	  display.SetCursor(0, 0);
	  display.WriteString("ENCODER INIT NOK", Font_7x10, White);
	  display.WriteBitmapToScreen();
	  while(1)
	  {
		  __NOP();
	  }
  }



  //Memory init
  int devices[128];

  available_devices(devices);

  memoryElement elementList[9] =
  {
      {"MS1_fixAx", i8},
      {"MS1_trackAx", i8},
      {"MS1_setDeg", i16},

	  {"MS2_fixAx", i8},
      {"MS2_trackAx", i8},
      {"MS2_setDeg", i16},

	  {"MS3_fixAx", i8},
      {"MS3_trackAx", i8},
      {"MS3_setDeg", i16},
  };

  //deleteRegion(&hi2c1, EEPROMAddress, 0, 128);
  EEPROMmemory EEPROM(elementList, 9, EEPROMAddress, &hi2c1);


  uint8_t testVal = 99;
  //EEPROM.getValue("MS1_fixAx", &testVal);

  HAL_StatusTypeDef stat;
  uint16_t start = 0;
  stat = HAL_I2C_IsDeviceReady(&hi2c1, EEPROMAddress<<1, 2, 100);
  stat = HAL_I2C_Mem_Read(&hi2c1, EEPROMAddress<<1, start, I2C_MEMADD_SIZE_16BIT, &testVal, sizeof(testVal), 1000);

  State_Settings state_Settings;
  State_SelectMemory state_SelectMemory;
  State_Moving state_Moving;
  State_FreeMove state_FreeMove;
  State_Remote state_Remote;

  getMemorySlotFromEEPROM(&state_Settings.currentMemorySlot, 1, &EEPROM);
  StateMachine machine(&state_SelectMemory, //<- starting state
		  	  	  	  &state_Settings, &state_SelectMemory, &state_Moving, &state_FreeMove, &state_Remote, //<- states
		  	  	  	  &display, &imu, &EEPROM); //<- resources




  /* USER CODE END 2 */

  /* Infinite loop */
  /* USER CODE BEGIN WHILE */
  while (1)
  {
	machine.run();


	//HAL_Delay(200);
    /* USER CODE END WHILE */

    /* USER CODE BEGIN 3 */
  }
  /* USER CODE END 3 */
}

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
