SAndras01/Masters-thesis/cubeIDE_workspace/TwoAxisPlatformMain/TwoAxisPlatformMain.ioc

Mcu.UserName=STM32F767ZITx
PA0/WKUP.GPIO_Label=MOT1_STEP
PA0/WKUP.Signal=S_TIM5_CH1
PA1.GPIO_Label=RMII_REF_CLK [LAN8742A-CZ-TR_REFCLK0]
PA1.Signal=ETH_REF_CLK
PA10.GPIO_Label=USB_ID
PA10.Signal=USB_OTG_FS_ID
PA11.GPIO_Label=USB_DM
PA11.Signal=USB_OTG_FS_DM
PA12.GPIO_Label=USB_DP
PA12.Signal=USB_OTG_FS_DP
PA13.GPIO_Label=TMS
PA13.Signal=SYS_JTMS-SWDIO
PA14.GPIO_Label=TCK
PA14.Signal=SYS_JTCK-SWCLK
PA15.GPIO_Label=MOT2_STEP
PA15.Signal=S_TIM2_CH1_ETR
PA2.GPIO_Label=RMII_MDIO [LAN8742A-CZ-TR_MDIO]
PA2.Signal=ETH_MDIO
PA3.GPIO_Label=NUMPAD_A_OUT
PA3.Signal=ADCx_IN3
PA4.Signal=SPI3_NSS
PA5.Signal=SPI1_SCK
PA6.GPIO_Label=NUMPAD_VREF
PA6.Signal=ADCx_IN6
PA7.GPIO_Label=RMII_CRS_DV [LAN8742A-CZ-TR_CRS_DV]
PA7.Signal=ETH_CRS_DV
PA8.GPIO_Label=USB_SOF [TP1]
PA8.Signal=USB_OTG_FS_SOF
PA9.GPIO_Label=USB_VBUS
PA9.Signal=USB_OTG_FS_VBUS
PB0.GPIO_Label=LD1 [Green]
PB0.Signal=GPIO_Output
PB10.Signal=SPI2_SCK
PB12.Signal=SPI2_NSS
PB13.GPIO_Label=RMII_TXD1 [LAN8742A-CZ-TR_TXD1]
PB13.Signal=ETH_TXD1
PB14.GPIO_Label=LD3 [Red]
PB14.Signal=GPIO_Output
PB2.Signal=SPI3_MOSI
PB3.GPIO_Label=SWO
PB3.Signal=SYS_JTDO-SWO
PB5.Signal=SPI1_MOSI
PB7.GPIO_Label=LD2 [Blue]
PB7.Signal=GPIO_Output
PB8.Signal=I2C1_SCL
PB9.Signal=I2C1_SDA
PC1.GPIO_Label=RMII_MDC [LAN8742A-CZ-TR_MDC]
PC1.Signal=ETH_MDC
PC10.Signal=SPI3_SCK
PC13.GPIO_Label=USER_Btn [B1]
PC13.Signal=GPXTI13
PC14/OSC32_IN.Signal=RCC_OSC32_IN
PC15/OSC32_OUT.Signal=RCC_OSC32_OUT
PC2.GPIO_Label=TRG_RB_OUT
PC2.Signal=GPIO_Output
PC3.Signal=SPI2_MOSI
PC4.GPIO_Label=RMII_RXD0 [LAN8742A-CZ-TR_RXD0]
PC4.Signal=ETH_RXD0
PC5.GPIO_Label=RMII_RXD1 [LAN8742A-CZ-TR_RXD1]
PC5.Signal=ETH_RXD1
PD8.GPIO_Label=STLK_RX [STM32F103CBT6_PA3]
PD8.Signal=USART3_TX
PD9.GPIO_Label=STLK_TX [STM32F103CBT6_PA2]
PD9.Signal=USART3_RX
PE0.GPIO_Label=MOT_ENN_RB
PE0.Signal=GPIO_Input
PE1.GPIO_Label=TRG_SIGNAL
PE1.Signal=GPIO_Input
PE10.GPIO_Label=BTN_ONBRD_EXTRA2
PE10.Signal=GPIO_Input
PE11.GPIO_Label=BTN_ONBRD_EXTRA3
PE11.Signal=GPIO_Input
PE12.GPIO_Label=BTN_ONBRD_EXTRA4
PE12.Signal=GPIO_Input
PE13.GPIO_Label=MOT1_DIAG
PE13.Signal=GPIO_Input
PE14.GPIO_Label=MOT2_DIAG
PE14.Signal=GPIO_Input
PE2.GPIO_Label=BTN_FIX_AX
PE2.Signal=GPIO_Input
PE3.GPIO_Label=BTN_TRACKED_AX
PE3.Signal=GPIO_Input
PE4.GPIO_Label=BTN_MEM_SLOT
PE4.Signal=GPIO_Input
PE5.GPIO_Label=BTN_OK
PE5.Signal=GPIO_Input
PE6.GPIO_Label=BNT_SET
PE6.Signal=GPIO_Input
PE7.GPIO_Label=BTN_FREE_MOOVE
PE7.Signal=GPIO_Input
PE8.GPIO_Label=BTN_EXTERNAL_EXTRA
PE8.Signal=GPIO_Input
PE9.GPIO_Label=BTN_ONBRD_EXTRA1
PE9.Signal=GPIO_Input
PF0.GPIO_Label=MOT1_DIR
PF0.Signal=GPIO_Output
PF1.GPIO_Label=MOT1_SPREAD
PF1.Signal=GPIO_Output
PF10.GPIO_Label=ENCODER1_CS
PF10.Signal=GPIO_Output
PF11.GPIO_Label=ENCODER2_CS
PF11.Signal=GPIO_Output
PF2.GPIO_Label=MOT1_MS1
PF2.Signal=GPIO_Output
PF3.GPIO_Label=MOT1_MS2
PF3.Signal=GPIO_Output
PF4.GPIO_Label=MOT2_DIR
PF4.Signal=GPIO_Output
PF5.GPIO_Label=MOT2_SPREAD
PF5.Signal=GPIO_Output
PF6.GPIO_Label=MOT2_MS1
PF6.Signal=GPIO_Output
PF7.GPIO_Label=MOT2_MS2
PF7.Signal=GPIO_Output
PF8.GPIO_Label=MOT_ENN
PF8.Signal=GPIO_Output
PF9.GPIO_Label=OLED_RES
PF9.Signal=GPIO_Output
PG11.GPIO_Label=RMII_TX_EN [LAN8742A-CZ-TR_TXEN]
PG11.Signal=ETH_TX_EN
PG13.GPIO_Label=RMII_TXD0 [LAN8742A-CZ-TR_TXD0]
PG13.Signal=ETH_TXD0
PG7.GPIO_Label=USB_OverCurrent [STMPS2151STR_FAULT]
PG7.Signal=GPIO_Input
PG9.Signal=SPI1_MISO
PH0/OSC_IN.GPIO_Label=MCO [STM32F103CBT6_PA8]
PH0/OSC_IN.Signal=RCC_OSC_IN
PH1/OSC_OUT.Signal=RCC_OSC_OUT
