SAndras01/Masters-thesis/bitmap.h

const uint8_t myBitmap[] = {
    0x00, 0x00, 0x00, 0x80, 0x80, 0x00, 0x00, 0x80, 0x80, 0x00, 0x80, 0x80, 0xC0, 0xE0, 0xE0, 0xC0, 
    0xE0, 0xE0, 0xF0, 0xF8, 0x48, 0x7C, 0x14, 0x9C, 0x98, 0x78, 0xEC, 0xBC, 0xE4, 0xBC, 0xF8, 0xF0, 
    0xF4, 0x3E, 0x7A, 0xFC, 0xE6, 0xFB, 0xB6, 0x72, 0xFE, 0x3B, 0x97, 0x4E, 0x9F, 0xCF, 0xEF, 0xFF, 
    0xEB, 0x37, 0x3D, 0x61, 0x31, 0xF5, 0x6D, 0xDE, 0xFB, 0x57, 0xC8, 0x17, 0xF5, 0xD5, 0xFC, 0x94, 
    0xFE, 0xFD, 0xDD, 0xBD, 0xFF, 0xFF, 0xB8, 0xF9, 0xBF, 0xFE, 0xFE, 0xF7, 0xF9, 0x3D, 0x7E, 0xF9, 
    0xDD, 0xFE, 0x7F, 0xFA, 0xCF, 0xEF, 0x73, 0xE7, 0xEF, 0xBC, 0xFC, 0xBC, 0xFC, 0xFC, 0xFC, 0xFE, 
    0xFF, 0xFF, 0xBF, 0xF6, 0xFB, 0xFF, 0xFB, 0xFE, 0xF6, 0xEE, 0xEC, 0xE6, 0xEF, 0xE6, 0xA7, 0xE3, 
    0xC7, 0xE3, 0xE3, 0xE3, 0xE2, 0x03, 0x03, 0x03, 0x00, 0x03, 0x05, 0x01, 0x03, 0x03, 0x00, 0x00, 
    0x00, 0x00, 0xF0, 0xA5, 0xD9, 0x8F, 0xD8, 0xED, 0xED, 0xFD, 0xE6, 0xFB, 0x3D, 0x75, 0x7B, 0xB9, 
    0xF7, 0x7D, 0xFF, 0xF7, 0xC2, 0xF1, 0x71, 0x48, 0x00, 0x0A, 0x00, 0x09, 0x00, 0x40, 0x04, 0xC0, 
    0x84, 0x08, 0x20, 0x98, 0xF3, 0x8B, 0x9F, 0xFE, 0x5D, 0x7F, 0xFE, 0xD6, 0xF7, 0xB4, 0xFB, 0xEE, 
    0xD8, 0xF9, 0x25, 0xAF, 0x5F, 0xFE, 0xB1, 0xAF, 0x29, 0xF3, 0xDB, 0x27, 0xFF, 0xFF, 0xF9, 0xEA, 
    0xDF, 0xB7, 0x1F, 0xEF, 0xAF, 0x96, 0xE6, 0xFF, 0xFC, 0x1F, 0x1A, 0x0E, 0x0F, 0x84, 0xC0, 0xC0, 
    0xE0, 0xF0, 0xD4, 0xBE, 0xED, 0x6C, 0xFC, 0xBC, 0xEE, 0xBF, 0xBE, 0xDB, 0xEE, 0xFE, 0xFE, 0xFF, 
    0xFE, 0x9F, 0xFF, 0xEF, 0xFF, 0xFB, 0x8F, 0xEF, 0xFF, 0x7F, 0xFE, 0xF7, 0xBF, 0xFF, 0xBF, 0xFF, 
    0xBF, 0x9F, 0xBF, 0xCD, 0xBF, 0xFE, 0x50, 0x00, 0x00, 0x30, 0x00, 0x20, 0x40, 0x00, 0x00, 0x80, 
    0x00, 0x07, 0xAE, 0x99, 0x96, 0x5F, 0xD7, 0x99, 0xF9, 0xE1, 0xA7, 0xBF, 0x6B, 0xFF, 0xB1, 0xBE, 
    0xDF, 0xB7, 0x2E, 0x1F, 0xAA, 0x12, 0x24, 0x00, 0x04, 0x40, 0x40, 0x20, 0x80, 0x21, 0x81, 0xB2, 
    0xB4, 0x60, 0xF0, 0xA2, 0x75, 0xAD, 0x4C, 0x5F, 0xBF, 0x77, 0x9C, 0xFB, 0xFF, 0x7F, 0xBE, 0xAF, 
    0xBF, 0xDD, 0xDF, 0xFF, 0xFF, 0xB1, 0xF3, 0xF9, 0xE0, 0xDD, 0xBF, 0xFB, 0xFB, 0xFD, 0xFF, 0xFF, 
    0xFF, 0xEF, 0xFF, 0x7F, 0xBF, 0xFD, 0x4F, 0x0F, 0xDF, 0xFB, 0x3F, 0x2F, 0xCF, 0x9F, 0xDE, 0xFF, 
    0xF7, 0xCE, 0xE3, 0x75, 0x7B, 0xFD, 0xF7, 0xFF, 0xFB, 0x77, 0xBF, 0xFF, 0xEF, 0xF7, 0xBD, 0xF9, 
    0xDF, 0x5F, 0xFF, 0xFF, 0xFF, 0xFD, 0xEF, 0xFF, 0xFF, 0x7F, 0x9E, 0xFF, 0xFE, 0xFF, 0xFA, 0xFA, 
    0xF9, 0xEF, 0xEE, 0xF6, 0xFF, 0x30, 0x05, 0x24, 0x00, 0x00, 0x40, 0x40, 0x21, 0x08, 0x0E, 0x02, 
    0x00, 0x00, 0x00, 0x01, 0x03, 0x06, 0x04, 0x0B, 0x0C, 0x3A, 0xB5, 0x60, 0x66, 0x7C, 0xFB, 0xDB, 
    0xFB, 0xFF, 0xD7, 0x66, 0x40, 0x78, 0x48, 0x7A, 0xFA, 0x7F, 0x7D, 0x1F, 0xC7, 0x07, 0x07, 0x83, 
    0x07, 0x0D, 0x1E, 0x36, 0xD5, 0xDA, 0xFD, 0x5D, 0xFE, 0x5F, 0xAF, 0x7F, 0xA6, 0x05, 0x7F, 0xCF, 
    0x3E, 0x3B, 0x2F, 0xFB, 0xCF, 0x72, 0xB3, 0xFF, 0xFD, 0x7D, 0x7D, 0xFE, 0xFF, 0xFE, 0xFE, 0x7D, 
    0x77, 0xF7, 0x47, 0xDD, 0xEF, 0xFB, 0xEF, 0xFF, 0xFF, 0xF2, 0xFB, 0xF8, 0x77, 0x1D, 0x11, 0x33, 
    0x33, 0x0E, 0x21, 0x1F, 0x39, 0x1B, 0x0B, 0x0B, 0x0F, 0x0F, 0x07, 0x05, 0x07, 0x06, 0x03, 0x01, 
    0x03, 0x03, 0x03, 0x03, 0x03, 0x07, 0x06, 0x1F, 0x1D, 0x3F, 0x7F, 0x7F, 0xF7, 0xE7, 0xDF, 0x9F, 
    0x0F, 0x07, 0x01, 0x05, 0x05, 0x02, 0x90, 0x00, 0x08, 0x00, 0x10, 0x00, 0x00, 0x10, 0x00, 0x84, 
};
