SAndras01/Masters-thesis/cubeIDE_workspace/TwoAxisPlatformMain/Core/Modules/SSD1305/test_bitmaps.hpp

/*
 * test_bitmaps.hpp
 *
 *  Created on: Sep 7, 2025
 *      Author: Sásdi András
 */

#ifndef MODULES_SSD1306_TEST_BITMAPS_HPP_
#define MODULES_SSD1306_TEST_BITMAPS_HPP_

static uint8_t Misato_sfw[512] = {
    		0xff, 0xff, 0xff, 0xff, 0xff, 0xff, 0xff, 0xff, 0xff, 0xff, 0xff, 0xff, 0xff, 0xff, 0xff, 0xff,
    		0xff, 0xff, 0xff, 0xff, 0xff, 0xff, 0xff, 0xff, 0xff, 0xff, 0xff, 0xff, 0xff, 0xf8, 0x80, 0x00,
    		0x00, 0x00, 0x00, 0x00, 0x00, 0x00, 0x00, 0x00, 0x00, 0x00, 0x00, 0x00, 0xc0, 0xc0, 0xc0, 0x40,
    		0x00, 0x00, 0x00, 0x00, 0x10, 0x20, 0x00, 0x40, 0x12, 0x2c, 0xf8, 0xfb, 0xff, 0xff, 0xff, 0xff,
    		0xff, 0xff, 0xff, 0xff, 0xff, 0xff, 0xfd, 0xee, 0x53, 0x48, 0x00, 0x20, 0x00, 0x00, 0x00, 0x18,
    		0x04, 0x00, 0x00, 0x20, 0x00, 0xc0, 0x60, 0x88, 0x40, 0x00, 0x00, 0x00, 0x00, 0x80, 0x80, 0x40,
    		0x00, 0x00, 0x00, 0x00, 0x00, 0x0f, 0xff, 0xff, 0xff, 0xff, 0xff, 0xff, 0xff, 0xff, 0xff, 0xff,
    		0xff, 0xff, 0xff, 0xff, 0xff, 0xff, 0xff, 0xff, 0xff, 0xff, 0xff, 0xff, 0xff, 0xff, 0xff, 0xff,
    		0xff, 0xff, 0xff, 0xff, 0xff, 0xff, 0xff, 0xff, 0xff, 0xff, 0xff, 0xff, 0xff, 0xff, 0xff, 0xff,
    		0xff, 0xff, 0xff, 0xff, 0xff, 0xff, 0xff, 0xff, 0xff, 0xff, 0xff, 0xff, 0xff, 0xff, 0x0f, 0x00,
    		0x00, 0x00, 0x00, 0x00, 0x00, 0x00, 0x3c, 0xfc, 0x78, 0xe0, 0x40, 0x1c, 0xff, 0xff, 0xfe, 0xf8,
    		0xfc, 0xfe, 0xfe, 0xf0, 0xe0, 0xe0, 0xe0, 0xf2, 0xfe, 0xfc, 0xf8, 0xfe, 0xfd, 0xfd, 0xff, 0xff,
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
    	0x3f, 0x3f, 0x3f, 0x3f, 0x7f, 0x7f, 0x7f, 0x7f, 0xff, 0xff, 0xff, 0xff, 0xff, 0xff, 0xff, 0xff,
    	0xff, 0xff, 0xff, 0xff, 0xff, 0xff, 0xff, 0xff, 0xff, 0xff, 0xff, 0xff, 0xff, 0xff, 0xff, 0xff,
    	0x1f, 0x1f, 0x0f, 0x0f, 0x0f, 0x0f, 0x0f, 0x07, 0x07, 0x07, 0x07, 0x83, 0x83, 0x83, 0x83, 0xc1,
    	0xc1, 0xc1, 0xc1, 0xe0, 0xe0, 0xe0, 0xe0, 0xf0, 0xf0, 0xf0, 0xf0, 0xf8, 0xf8, 0xf8, 0xf8, 0xf8,
    	0xfc, 0xfc, 0xfc, 0xfc, 0xfe, 0xfe, 0xfe, 0xfe, 0xff, 0xff, 0xff, 0xff, 0xff, 0xff, 0xff, 0xff,
    	0xff, 0xff, 0xff, 0xff, 0xff, 0xff, 0xff, 0xff, 0xff, 0xff, 0xff, 0xff, 0xff, 0xff, 0xff, 0xff,
    	0xff, 0xff, 0xff, 0xff, 0xff, 0xff, 0xff, 0xff, 0xff, 0xff, 0xff, 0xff, 0xff, 0xff, 0xff, 0xff,
    	0xff, 0xff, 0xff, 0xff, 0xff, 0xff, 0xff, 0xfe, 0xfe, 0xfe, 0xfe, 0xfc, 0xfc, 0xfc, 0xfc, 0xf8,
    	0xf8, 0xf8, 0xf8, 0xf8, 0xf0, 0xf0, 0xf0, 0xf0, 0xe0, 0xe0, 0xe0, 0xe0, 0xc0, 0xc1, 0xc1, 0xc1,
    	0x81, 0x83, 0x83, 0x83, 0x83, 0x07, 0x07, 0x07, 0x07, 0x0f, 0x0f, 0x0f, 0x0f, 0x1f, 0x1f, 0x1f
    };



#endif /* MODULES_SSD1306_TEST_BITMAPS_HPP_ */
