SAndras01/Masters-thesis/(commit log)

2025-08-27 Progress uploaded
    Progress so far: Stepper controller
    [Követelménylista.xlsx, Módszerek összehasonlítása (python - C).xlsx, hiba.xlsx]
2025-09-05 OLED driver
2025-09-07 OLED driver finished
2025-09-17 State machine updated
    So far only the "StateSetFixTrackDeg" state is implemented. Also it should be named smth better, like "SetParams", as we are setting all the params of a memory slot here. Also an eeprom should be integrated into it and write the on exit so we save this all to the eeprom
2025-10-06 Accelerometer driver, regmap added, testing in main.cpp
2025-10-10 encoder dev con.
2025-10-12 Accelerometer driver continued
2025-10-21 Migration to bigger board
2025-10-22 eeprom comm error debug
    [main.cpp, memory.cpp]
2025-10-26 eeprom debug completed, hw design started
    [694106106102 (rev1).stp, Adafruit ICM20948.step, CES-106-01-T-S.stp, ICM20948.step, KITTEN.kicad_pcb, KITTEN.kicad_sch, NHD-2.23-12832U.STEP, PHF-120-01-L-S.stp]
2025-11-02 numpad schematic started
    [694106106102 (rev1).stp, Adafruit ICM20948.step, CES-106-01-T-S.stp, ICM20948.step, KITTEN.kicad_pcb, KITTEN.kicad_sch, NHD-2.23-12832U.STEP, PHF-120-01-L-S.stp]
2025-11-02 KiCad simulations, numpad design
2025-11-02 kicad saves
    [KITTEN.kicad_sch]
2025-11-03 Display and numpad schematics
    [KITTEN.kicad_sch]
2025-11-03 Work on schematics
    [694106106102 (rev1).stp, Adafruit ICM20948.step, CES-106-01-T-S.stp, ICM20948.step, KITTEN.kicad_pcb, KITTEN.kicad_sch, NHD-2.23-12832U.STEP, PHF-120-01-L-S.stp]
2025-11-04 Buttons module and main board schematics
    [KITTEN.kicad_sch, buttons.kicad_pcb, buttons.kicad_sch]
2025-11-06 Main sch further development
    [KITTEN.kicad_sch]
2025-11-06 MAIN board schematic mostly done
    [KITTEN.kicad_sch]
2025-11-08 schematics finished
    [buttons.kicad_sch, display.kicad_pcb, display.kicad_sch, motherboard.kicad_pcb, motherboard.kicad_sch, numpad.kicad_pcb, numpad.kicad_sch]
2025-11-10 PCB designs started
    [buttons.kicad_pcb, buttons.kicad_sch, display.kicad_pcb, display.kicad_sch, motherboard.kicad_sch, numpad.kicad_pcb, numpad.kicad_sch]
2025-11-11 numpad, buttons, display PCB done, review needed
    [buttons.kicad_pcb, display.kicad_pcb, numpad.kicad_pcb]
2025-11-11 main board pcb design started
    [motherboard.kicad_pcb, motherboard.kicad_sch]
2025-11-12 main board pcb continued
    [motherboard.kicad_pcb, motherboard.kicad_sch]
2025-11-13 motherboard pcb layout (MCU)
    [motherboard.kicad_pcb, motherboard.kicad_sch]
2025-11-13 Unnecessary silkscreen markings moveed to user1 layer. next step is routing and writing pin names for easier future debugging
    [motherboard.kicad_pcb]
2025-11-15 motherboard PCB design
    [motherboard.kicad_sch]
2025-11-16 motherboard PCCB done, review needed
    [motherboard.kicad_sch]
2025-11-19 PCB bugfixes based on review
    [buttons.kicad_pcb, display.kicad_pcb, display.kicad_sch, motherboard.kicad_sch, numpad.kicad_pcb]
2025-11-22 motor controll documentation
2025-11-24 Documentation + BOM
    [Boms.xlsx, MASTER_BOM_OUTPUT.xlsx, buttons.csv, display.csv, motherboard.csv, numpad.csv]
2025-11-28 documentation, OLED demo, BOM
    [Boms.xlsx, motherboard.kicad_sch, numpad.kicad_sch]
2025-12-01 documentation and plots
    [motherboard.kicad_sch]
2026-01-14 Power point continued
2026-01-15 ppt continued
    [motherboard.kicad_sch]
