SAndras01/Masters-thesis/(notices)

Notices in the files:
cubeIDE_workspace/TwoAxisPlatformMain/Core/Inc/main.h:
Copyright (c) 2025 STMicroelectronics.
All rights reserved.
This software is licensed under terms that can be found in the LICENSE file
KiCad/Buttons/TSW-120-06-T-S.stp:
author */ ('License CC BY-ND 4.0'),
